OpenARDF/FlexFox80/README.md

# FlexFox80
A very configurable remote-controllable 80m ARDF transmitter. It has no external buttons or switches, and contains its own webserver and is configured using most WiFi-capable devices, such as smartphones, tablets, or laptops.

Flexfox can be configured to function as an 80m "fox" transmitter for any type of Amateur Radio Direction Finding event, such as classic, sprint, or even foxoring.  

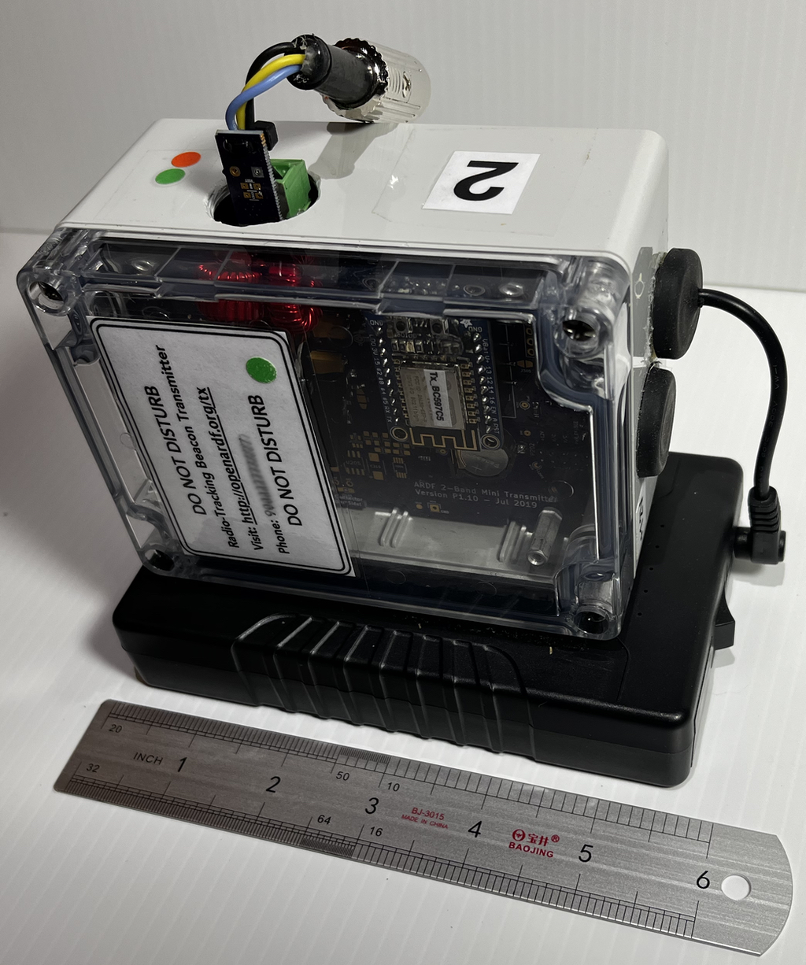
[picture p1: Docs/Proto-Flexfox4.jpeg]

Photo: Prototype FlexFox80 Assembled with 12V 6AH Battery Underneath

<b>KiCad</b>

The KiCad folder holds files for generating the schematic, BOM, and PCB files using KiCad. 

<b>Software</b>

The Software folder holds files for compiling executable code using Atmel Studio 7. 

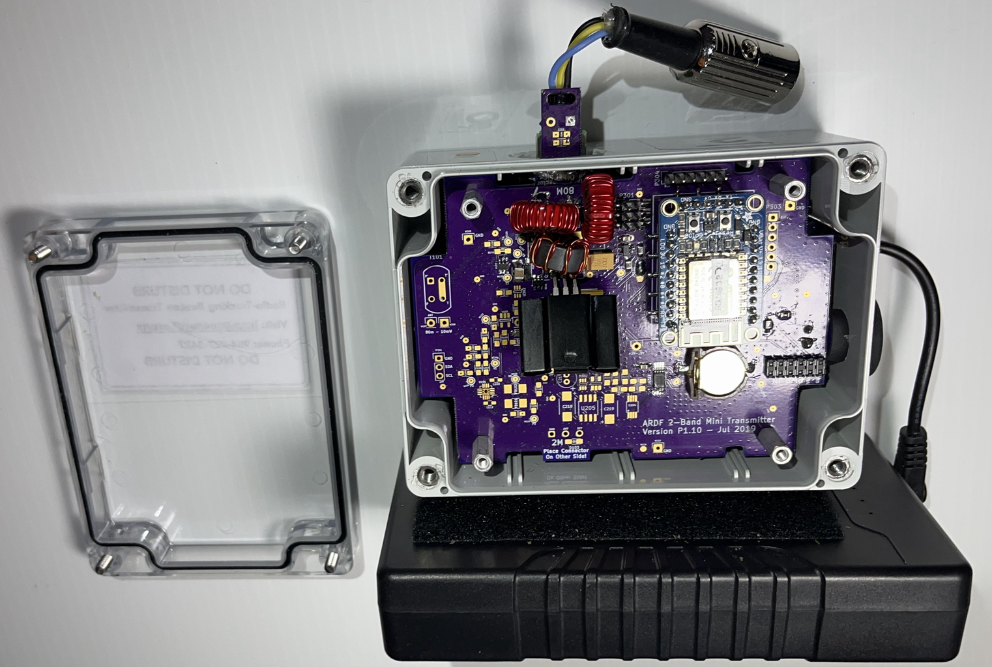
[picture p2: Docs/Proto-Flexfox2.jpeg]

Photo: Prototype FlexFox80 with Transparent Cover Removed
