OpenARDF/FlexFox80/KiCad/Gerber/FlexFox80 BOM Populated.xlsx

FlexFox80
Ref | Value | QTY PER | Footprint | Description | Digi-Key Part No. | LCSC Part No. | Link | Manufacturer | Manufacturer PN | Comments
C123 C131 | 1100pF | 2 | Capacitors_SMD:C_0805 | CAP CER 1100PF 50V NP0 0805 | 399-14552-1-ND | C2327793 | <a href="https://www.digikey.com/products/en?keywords=399-14552-1-ND">Link</a> | KEMET | C0805C112J5GAC7800
C120 C122 C310 C312 | 470nF | 4 | Capacitors_SMD:C_0805 | CAP CER 0.47UF 100V X7R 0805 | 478-9924-1-ND | C342818 | <a href="https://www.digikey.com/products/en?keywords=478-9924-1-ND">Link</a> | AVX Corporation | 08051C474K4Z2A
C126 | 1800pF | 1 | Capacitors_SMD:C_0805 | CAP CER 1800PF 100V C0G 0805 | 445-5752-1-ND | C2173329 | <a href="https://www.digikey.com/products/en?keywords=445-5752-1-ND">Link</a> | TDK Corporation | CGA4F2C0G2A182J085AA
C128 | 91pF | 1 | Capacitors_SMD:C_0603 | CAP CER 91PF 100V NP0 0603 | 478-10247-1-ND | C2170042 | <a href="https://www.digikey.com/products/en?keywords=478-10247-1-ND">Link</a> | KYOCERA AVX | 06031U910FAT2A
C119 C214 C217 | 47uF low ESR | 3 | Capacitors_SMD:C_2917 | CAP TANT 47UF 10% 20V 2917 | 399-3904-1-ND | C122333 | <a href="https://www.digikey.com/products/en?keywords=399-3904-1-ND">Link</a> | KEMET | T495X476K020ATE150
C117 C210 | 22uF | 2 | Capacitors_SMD:C_1210 | CAP CER 22UF 25V X5R 1210 | 1276-3373-1-ND | C337455 | <a href="https://www.digikey.com/products/en?keywords=1276-3373-1-ND">Link</a> | Samsung Electro-Mechanics | CL32A226MAJNNNE
C101 C205 C216 C305 C304 | 10uF | 5 | Capacitors_SMD:C_0805 | CAP CER 10UF 25V X5R 0805 | 490-5523-1-ND | C84416 | <a href="https://www.digikey.com/products/en?keywords=490-5523-1-ND">Link</a> | Murata Electronics | GRM21BR61E106KA73L
C213 C219 C301 | 1uF | 3 | Capacitors_SMD:C_0805 | CAP CER 1UF 16V X7R 0805 | 311-1365-1-ND | C344171 | <a href="https://www.digikey.com/products/en?keywords=311-1365-1-ND">Link</a> | Yageo | CC0805KKX7R7BB105
C207 | 270pF | 1 | Capacitors_SMD:C_0805 | CAP CER 270PF 50V C0G/NP0 0805 | 1276-2624-1-ND | C161109 | <a href="https://www.digikey.com/products/en?keywords=1276-2624-1-ND">Link</a> | Samsung Electro-Mechanics | CL21C271GBANNNC
C208 | 10pF | 1 | Capacitors_SMD:C_0805 | CAP CER 10PF 200V C0G/NP0 0805 | 478-10457-1-ND | C344177 | <a href="https://www.digikey.com/products/en?keywords=478-10457-1-ND">Link<a/> | AVX Corporation | 08052U100FAT2A
C206 C211 C202 C204 C212 C306 C307 C302 C319 C320 C311 C308 | 100nF | 12 | Capacitors_SMD:C_0805 | CAP CER 0.1UF 50V X7R 0805 | 478-1395-1-ND | C360619 | <a href="https://www.digikey.com/products/en?keywords=478-1395-1-ND">Link</a> | AVX Corporation | 08055C104KAT2A
C215 C209 | 150uF low ESR | 2 | Capacitors_SMD:C_2917 | CAP TANT 150UF 10% 20V 2917 | 478-5253-1-ND | C444765 | <a href="https://www.digikey.com/products/en?keywords=478-5253-1-ND">Link</a> | AVX Corporation | TPME157K020R0035
C218 | 10nF | 1 | Capacitors_SMD:C_0805 | CAP CER 10000PF 50V NP0 0805 | 478-10068-1-ND | C527201 | <a href="https://www.digikey.com/products/en?keywords=478-10068-1-ND">Link</a> | AVX Corporation | 08055A103JAT2A
C303 C318 C317 C314 C313 C315 | 4.7uF | 6 | Capacitors_SMD:C_0805 | CAP CER 4.7UF 25V X7R 0805 | 587-2990-1-ND | C162420 | <a href="https://www.digikey.com/products/en?keywords=587-2990-1-ND">Link</a> | Taiyo Yuden | TMK212AB7475KG-T
D104 D306 D307 | ESD | 3 | Resistors_SMD:R_0603 | VARISTOR 0603 | CG0603MLC-05LECT-ND | C2655331 | <a href="https://www.digikey.com/products/en?keywords=CG0603MLC-05LECT-ND">Link</a> | Bourns Inc. | CG0603MLC-05LE
D101 D301 | MBD54 | 2 | TO_SOT_Packages_SMD:SOT-363-0.65 | DIODE ARRAY SCHOTTKY 30V SC88 | MBD54DWT1GOSCT-ND | C152486 | <a href="https://www.digikey.com/products/en?keywords=MBD54DWT1GOSCT-ND">Link</a> | ON Semiconductor | MBD54DWT1G
D102 | 4.7V | 1 | Diodes_SMD:SOD-123_Handsolder | DIODE ZENER 4.7V 500MW SOD123 | BZT52C4V7-13FDICT-ND | C151054 | <a href="https://www.digikey.com/products/en?keywords=BZT52C4V7-13FDICT-ND">Link</a> | Diodes Incorporated | BZT52C4V7-13-F
D202 D201 | B530 | 2 | Diodes_SMD:DO-214AB | DIODE SCHOTTKY 30V 5A SMC | B530C-FDICT-ND | C110488 | <a href="https://www.digikey.com/products/en?keywords=B530C-FDICT-ND">Link</a> | Diodes Incorporated | B530C-13-F
D305 | RED | 1 | Resistors_SMD:R_0805 | LED RED CLEAR 0805 SMD | 732-4984-1-ND | C72037 | <a href="https://www.digikey.com/products/en?keywords=732-4984-1-ND ">Link</a> | Wurth Elektronik | 150080RS75000
D304 | GREEN | 1 | Resistors_SMD:R_0805 | LED GREEN CLEAR 0805 SMD | 732-4983-1-ND | C98224 | <a href="https://www.digikey.com/products/en?keywords=732-4983-1-ND">Link</a> | Wurth Elektronik | 150080GS75000
L202 L203 | 6.8uH | 2 | Inductors:CDR7D28MN | FIXED IND 6.8UH 2.75A 46.3 MOHM | 308-1328-1-ND |  | <a href="https://www.digikey.com/products/en?keywords=308-1328-1-ND">Link</a> | Sumida America Components Inc. | CDR7D28MNNP-6R8NC
Q201 | MUN5213DW1 | 1 | TO_SOT_Packages_SMD:SOT-363-0.65 | TRANS PREBIAS 2NPN 50V SC88 | MUN5213DW1T1GOSCT-ND | C95381 | <a href="https://www.digikey.com/products/en?keywords=MUN5213DW1T1GOSCT-ND">Link</a> | ON Semiconductor | MUN5213DW1T1G
Q202 | DMP4025LSD | 1 | Housings_SOIC:SOIC-8_3.9x4.9mm_Pitch1.27mm | MOSFET 2P-CH 40V 6.9A 8SO | DMP4025LSD-13DICT-ND | C150763 | <a href="https://www.digikey.com/products/en?keywords=DMP4025LSD-13DICT-ND">Link</a> | Diodes Incorporated | DMP4025LSD-13
Q203 | RJK0354DSP | 1 | Housings_SOIC:SOIC-8_3.9x4.9mm_Pitch1.27mm | MOSFET N-CH 30V 16A 8SOP | RJK0354DSP-00#J0CT-ND | C919563 | <a href="https://www.digikey.com/products/en?keywords=RJK0354DSP-00#J0CT-ND">Link</a> | Renesas Electronics America Inc | RJK0354DSP-00#J0
Q301 | PN2222A | 1 | TO_SOT_Packages_SMD:SOT-23 | TRANS NPN 40V 0.6A SOT23 | MMBT2222ATPMSCT-ND | C194252 | <a href="https://www.digikey.com/products/en?keywords=MMBT2222ATPMSCT-ND">Link</a> | Micro Commercial Co | MMBT2222A-TP
R204 | 392k | 1 | Resistors_SMD:R_0805 | RES SMD 392K OHM 1% 1/8W 0805 | 311-392KCRCT-ND | C273847 | <a href="https://www.digikey.com/products/en?keywords=311-392KCRCT-ND">Link</a> | Yageo | RC0805FR-07392KL
R207 R209 R210 R313 R308 | 100k | 5 | Resistors_SMD:R_0805 | RES SMD 100K OHM 1% 1/8W 0805 | 311-100KCRCT-ND | C103905 | <a href="https://www.digikey.com/products/en?keywords=311-100KCRCT-ND">Link</a> | Yageo | RC0805FR-07100KL
R212 R205 R201 | 162k | 3 | Resistors_SMD:R_0805 | RES SMD 162K OHM 1% 1/8W 0805 | 311-162KCRCT-ND | C416820 | <a href="https://www.digikey.com/products/en?keywords=311-162KCRCT-ND">Link</a> | Yageo | RC0805FR-07162KL
R203 R208 R206 | 27k | 3 | Resistors_SMD:R_0805 | RES SMD 27K OHM 1% 1/8W 0805 | 311-27.0KCRCT-ND | C139896 | <a href="https://www.digikey.com/products/en?keywords=311-27.0KCRCT-ND">Link</a> | Yageo | RC0805FR-0727KL
R213 R214 R211 R216 R215 R306 R307 R310 R311 R303 R315 R316 | 10k | 12 | Resistors_SMD:R_0805 | RES SMD 10K OHM 1% 1/8W 0805 | 311-10KLGCT-ND | C38522 | <a href="https://www.digikey.com/products/en?keywords=311-10KLGCT-ND">Link</a> | Yageo | AC0805FR-0710KL
R217 | 1.1k | 1 | Resistors_SMD:R_0805 | RES SMD 1.1K OHM 1% 1/8W 0805 | 311-1.10KCRCT-ND | C352257 | <a href="https://www.digikey.com/products/en?keywords=311-1.10KCRCT-ND">Link</a> | Yageo | RC0805FR-071K1L
R218 | 0.01 0.5W | 1 | Resistors_SMD:R_0805 | RES 0.01 OHM 1% 1/2W 0805 | 408-1544-1-ND | C728271 | <a href="https://www.digikey.com/products/en?keywords=408-1544-1-ND">Link</a> | Susumu | KRL1220E-M-R010-F-T5
R202 | 49.9k | 1 | Resistors_SMD:R_0805 | RES SMD 49.9K OHM 0.1% 1/8W 0805 | YAG4990CT-ND | C218598 | <a href="https://www.digikey.com/products/en?keywords=YAG4990CT-ND">Link</a> | Yageo | RT0805BRE0749K9L
R304 | 10 | 1 | Resistors_SMD:R_0805 | RES SMD 10 OHM 1% 1/8W 0805 | 311-10.0CRCT-ND | C96347 | <a href="https://www.digikey.com/products/en?keywords=311-10.0CRCT-ND">Link</a> | Yageo | RC0805FR-0710RL
R312 R314 | 560k | 2 | Resistors_SMD:R_0805 | RES SMD 560K OHM 1% 1/8W 0805 | 13-RT0805FRE07560KLCT-ND | C352198 | <a href="https://www.digikey.com/products/en?keywords=13-RT0805FRE07560KLCT-ND">Link</a> | Yageo | RT0805FRE07560KL
R309 | 2.2k | 1 | Resistors_SMD:R_0805 | RES SMD 2.2K OHM 1% 1/8W 0805 | 311-2.2KCRCT-ND | C114561 | <a href="https://www.digikey.com/products/en?keywords=311-10.0KCRCT-ND">Link</a> | Yageo | RC0805FR-072K2L
R302 R301 | 470 | 2 | Resistors_SMD:R_0805 | RES 470 OHM 1% 1/4W 0805 | 2019-RK73H2ATTD4700FCT-ND | C114564 | <a href="https://www.digikey.com/products/en?keywords=2019-RK73H2ATTD4700FCT-ND">Link</a> | KOA Speer Electronics Inc. | RK73H2ATTD4700F
RV301 | 10k Pot | 1 | Potentiometers:Potentiometer_ST32ET_Handsolder | TRIMMER 10K OHM 0.1W J LEAD TOP | TC33X-103ECT-ND | C719176 | <a href="https://www.digikey.com/products/en?keywords=TC33X-103ECT-ND">Link</a> | Bourns Inc. | TC33X-2-103E
SW301 | SPST | 1 | Buttons_Switches_SMD:PTS645SL50SMTR92 | SWITCH TACTILE SPST-NO 0.05A 12V | CKN9088CT-ND | C221877 | <a href="https://www.digikey.com/products/en?keywords=CKN9088CT-ND">Link</a> | C&K | PTS645SL50SMTR92 LFS
U107 | LM5134B | 1 | TO_SOT_Packages_SMD:SOT-23-6-LM5134 | IC GATE DRVR LOW-SIDE SOT23-6 | 296-40244-1-ND | C2677086 | <a href="https://www.digikey.com/products/en?keywords=296-40244-1-ND">Link</a> | Texas Instruments | LM5134BMFX/NOPB
U101 | TPS22810DBVT | 1 | TO_SOT_Packages_SMD:SOT-23-6 | Power Switch/Driver 1:1 N-Channel 2A SOT-23-6 | 296-45304-1-ND | C2680364 | <a href="https://www.digikey.com/products/en?keywords=296-45304-1-ND">Link</a> | Texas Instruments | TPS22810DBVT
U203 | LTC3600 | 1 | Housings_SSOP:SSOP-12_Pad | IC REG BUCK PROG 1.5A 12MSOP | LTC3600EMSE#PBF-ND | C580752 | <a href="https://www.digikey.com/products/en?keywords=LTC3600EMSE%23PBF-ND">Link</a> | Analog Devices Inc. | LTC3600EMSE#PBF
U202 | OPA171 | 1 | TO_SOT_Packages_SMD:SOT-23-5_MCP | IC OPAMP GP 1 CIRCUIT SOT23-5 | 296-37698-1-ND | C88036 | <a href="https://www.digikey.com/products/en?keywords=296-37698-1-ND">Link</a> | Texas Instruments | OPA171AIDBVR
U204 | MIC2196 | 1 | Housings_SOIC:SOIC-8_3.9x4.9mm_Pitch1.27mm | IC REG CTRLR BOOST 8SOIC | MIC2196YM-CT-ND | C627808 | <a href="https://www.digikey.com/products/en?keywords=MIC2196YM-CT-ND">Link</a> | Microchip Technology | MIC2196YM-TR
U304 | SI5351A | 1 | Housings_SSOP:MSOP-10_3x3mm_Pitch0.5mm | IC CLK GENERATOR 200MHZ 10MSOP | 336-2399-5-ND | C529366 | <a href="https://www.digikey.com/products/en?keywords=336-2399-5-ND">Link</a> | Silicon Labs | SI5351A-B-GT
U301 | DS3231 | 1 | SMD_Packages:SO16 | IC RTC CLK/CALENDAR I2C 16-SOIC | DS3231S#T&RCT-ND | C2651514 | <a href="https://www.digikey.com/products/en?keywords=DS3231S%23T%26RCT-ND">Link</a> | Maxim Integrated | DS3231S#T&R
U305 | 74HC1G08 | 1 | TO_SOT_Packages_SMD:SOT-23-5 | IC GATE AND 1CH 2-INP 5TSOP | MC74HC1G08DTT1GOSCT-ND | C108694 | <a href="https://www.digikey.com/products/en?keywords=MC74HC1G08DTT1GOSCT-ND">Link</a> | ON Semiconductor | MC74HC1G08DTT1G
U303 U308 | LD2985BM33R | 2 | TO_SOT_Packages_SMD:SOT-23-5 | IC REG LINEAR 3.3V 150MA SOT23-5 | 497-3499-1-ND | C222396 | <a href="https://www.digikey.com/products/en?keywords=497-3499-1-ND">Link</a> | STMicroelectronics | LD2985BM33R
U302 | AVR128DA48 | 1 | Housings_QFP:TQFP-48_7x7mm_Pitch0.5mm_AVR128DA48 | IC MCU 8BIT 128KB FLASH 48TQFP | 150-AVR128DA48T-E/PTCT-ND | C1870720 | <a href="https://www.digikey.com/products/en?keywords=150-AVR128DA48T-E/PTCT-ND">Link</a> | Microchip Technology | AVR128DA48T-E/PT
U306 | LT1763CS8-5 | 1 | Housings_SOIC:SOIC-8_3.9x4.9mm_Pitch1.27mm | IC REG LINEAR 5V 500MA 8SOIC | LT1763CS8-5#TRPBFCT-ND | C193629 | <a href="https://www.digikey.com/products/en?keywords=LT1763CS8-5#TRPBFCT-ND">Link</a> | Analog Devices Inc. | LT1763CS8-5#TRPBF
U307 | TPS22810DBVT | 1 | TO_SOT_Packages_SMD:SOT-23-6 | IC PWR SWITCH N-CHAN 1:1 SOT23-6 | 296-45304-1-ND | C2680364 | <a href="https://www.digikey.com/products/en?keywords=296-45304-1-ND">Link</a> | Texas Instruments | TPS22810DBVT
X301 | 25.MHZ TCXO | 1 | Crystals:ASTX-H11-25.000MHZ | XTAL OSC TCXO 25MHZ CLPSNW | 2780-I537-2O7-25.000MHZCT-ND |  | <a href="https://www.digikey.com/products/en?keywords=2780-I537-2O7-25.000MHZCT-ND">Link</a> | Abracon LLC | I537-2O7-25.000 MHZ
