OpenARDF/FlexFox80/KiCad/FlexFox80.kicad_pcb

## KiCad design KiCad/FlexFox80.kicad_pcb (2026-07-14)

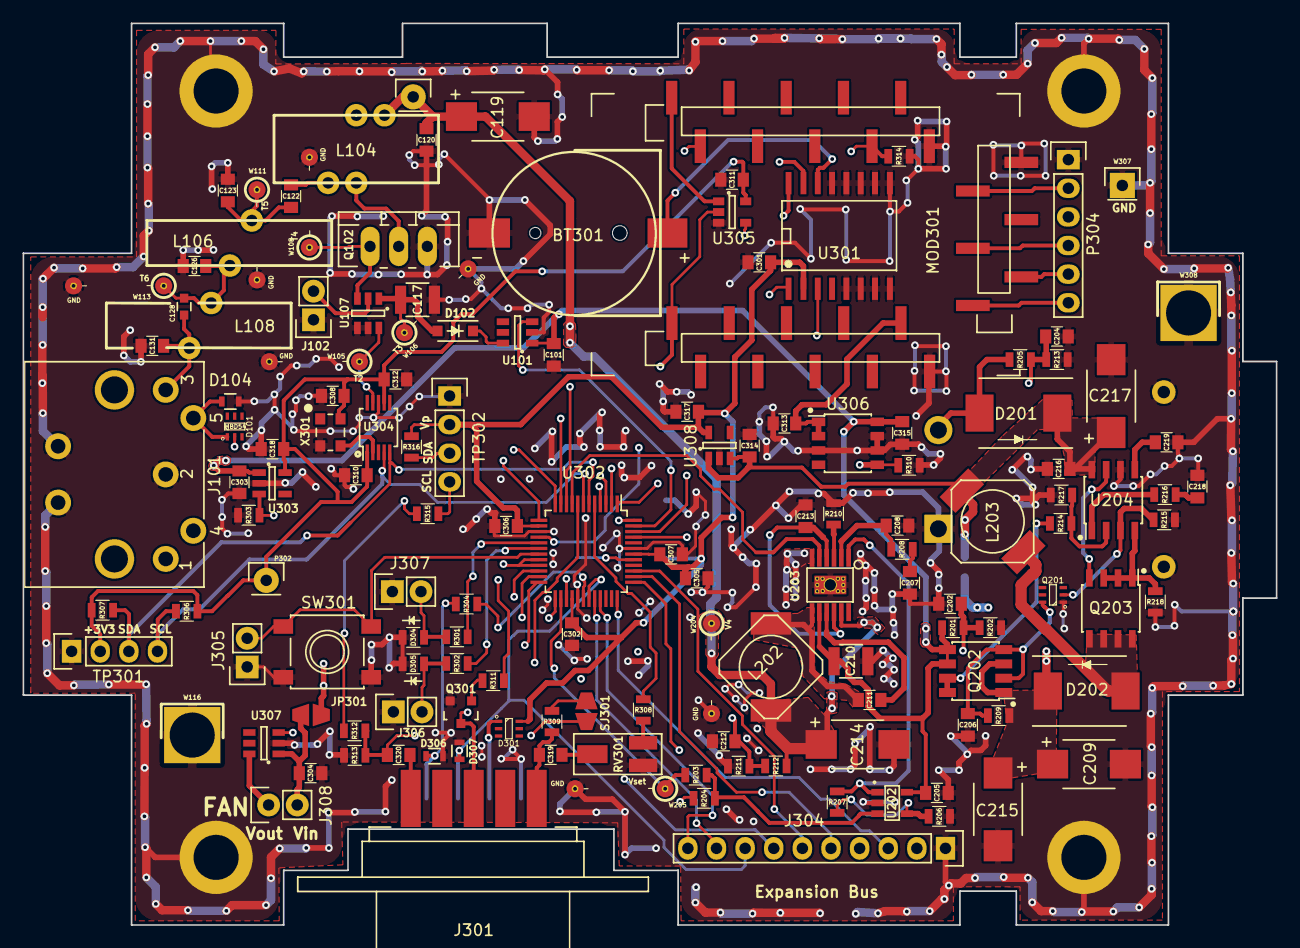
[picture p3: board FlexFox80.kicad_pcb from above]

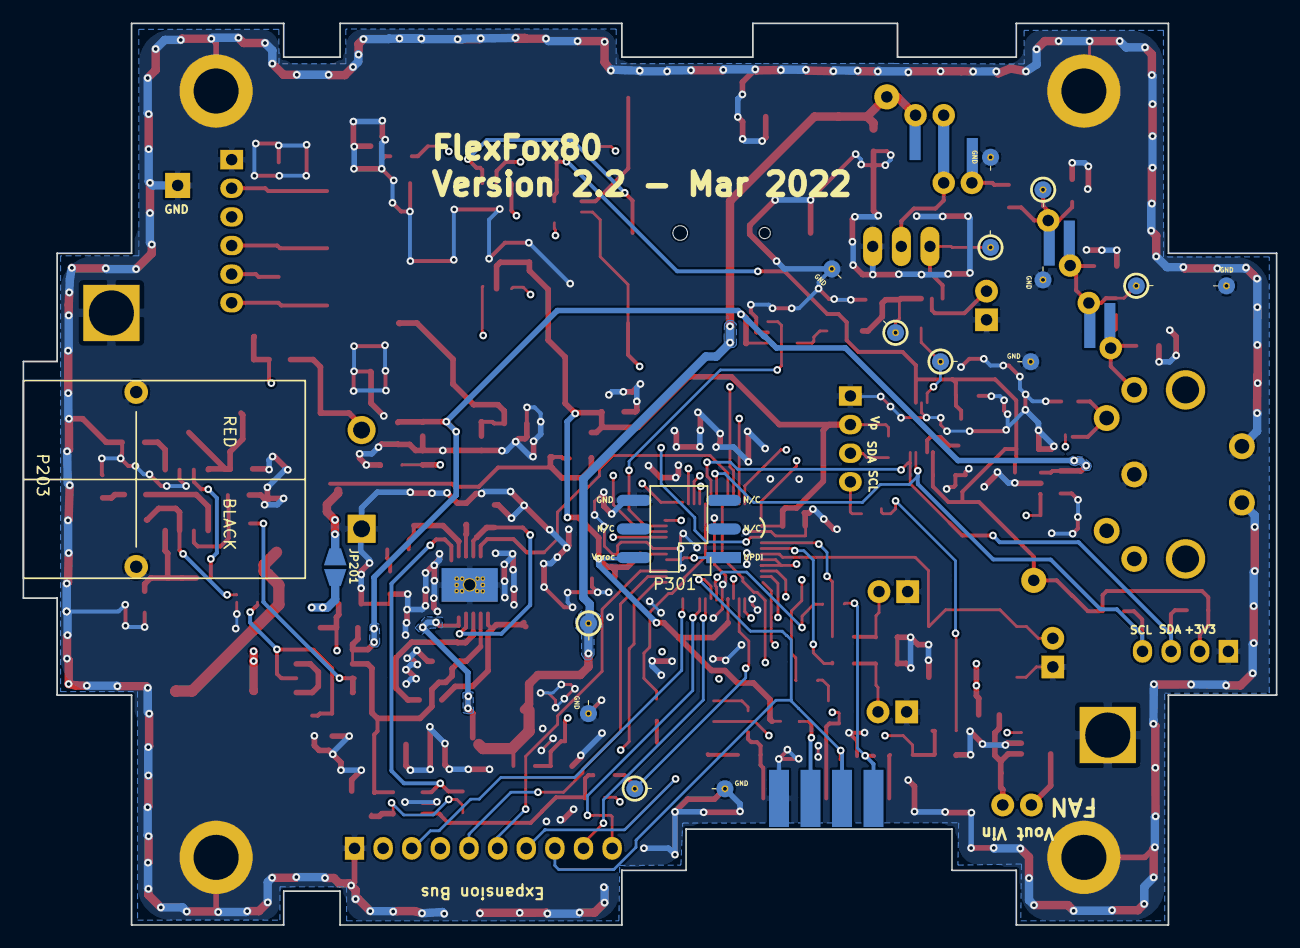
[picture p4: board FlexFox80.kicad_pcb from below]

Board: 4 copper layers, 111.2 x 80.0 mm, 143 parts (3 on the bottom side), 94 nets.

Parts:
BT301: CR1220; BC501SM_CR1220_BAT_Handsolder
C101, C205, C216, C304, C305: 10uF; C_0805
C117, C210: 22uF; C_1210
C119, C214, C217: 47uF low ESR; C_2917
C120, C122, C310, C312: 470nF; C_0805
C123, C131: 1100pF; C_0805
C126: 1800pF; C_0805
C128: 91pF; C_0603
C202, C204, C206, C211, C212, C302, C306, C307, C308, C311, C319, C320: 100nF; C_0805
C207: 270pF; C_0805
C208: 10pF; C_0805
C209, C215: 150uF low ESR; C_2917
C213, C219, C301: 1uF; C_0805
C218: 10nF; C_0805
C303, C313, C314, C315, C317, C318: 4.7uF; C_0805
D101, D301: MBD54; SOT-363-0.65_MBD54
D102: 4.7V; SOD-123
D104, D306, D307: ESD; R_0603
D201, D202: B530; DO-214AB
D304: GREEN; D_0805
D305: RED; D_0805
J101: DIN-5_180degree; SDF-50J
J102, J305, J306, J307, J308: Conn_01x02; Pin_Header_Straight_1x02
J203: V4; Pin_Header_Straight_1x01_circle_pad
J301: DB9_Female; DB9F_CI
J304: Conn_01x10; Pin_Header_Straight_1x10
JP201: Boost Bypass; Solder-Jumper-NO-SMD-Pad_Small
JP301: Jumper_NO_Small; Solder-Jumper-NO-SMD-Pad_Small
L104: 9T #24 Bifilar T50-43; Toroid_T-50A_TH_BF_CT_Vertical
L106, L108: 2.7uH; Toroid_T-60_2TH_Vertical
L202, L203: 6.8uH; CDR7D28MN
MOD301: HUZZAH_ESP8266_Breakout; Adafruit_HUZZAH_ESP8266_Breakout_SM
P203: Power Pole; PowerPole-ASMPP30-1x2
P301: ISP/PDI; SM_Pin_Header_Straight_2x03
P302: Thru; Pin_Header_Straight_1x01
P304: Header; Pin_Header_Straight_1x06
Q102: IRF610; TO-220_Neutral123_Vertical_LargePads
Q201: MUN5213DW1; SOT-363-0.65
Q202: DMP4025LSD; SOIC-8_3.9x4.9mm_Pitch1.27mm
Q203: RJK0354DSP; SOIC-8_3.9x4.9mm_Pitch1.27mm
Q301: PN2222A; SOT-23
R201, R205, R212: 162k; R_0805
R202: 49.9k; R_0805
R203, R206, R208: 27k; R_0805
R204: 392k; R_0805
R207, R209, R210, R308, R313: 100k; R_0805
R211, R213, R214, R215, R216, R303, R306, R307, R310, R311, R315, R316: 10k; R_0805
R217: 1.1k; R_0805
R218: 0.01 0.5W; R_0805
R301, R302: 470; R_0805
R304: 10; R_0805
R309: 2.2k; R_0805
R312, R314: 560k; R_0805
RV301: 10k Pot; Potentiometer_ST32ET_Handsolder
SJ301: SolderJumper_2_Open; Solder-Jumper-NO-SMD-Pad_Small
SW301: SPST; PTS645SL50SMTR92
TP301: I2C1; Pin_Header_Straight_1x04
TP302: I2C0; Pin_Header_Straight_1x04
U101, U307: TPS22810DBVT; SOT-23-6
U107: LM5134B; SOT-23-6-LM5134
U202: OPA171; SOT-23-5_MCP
U203: LTC3600; SSOP-12_Pad_Handsolder
U204: MIC2196; SOIC-8_3.9x4.9mm_Pitch1.27mm
U301: DS3231; SO16
U302: AVR128DA48; TQFP-48_7x7mm_Pitch0.5mm_AVR128DA48
U303, U308: LD2985BM33R; SOT-23-5
U304: SI5351A; MSOP-10_3x3mm_Pitch0.5mm
U305: 74HC1G08; SOT-23-5
U306: LT1763CS8-5; SOIC-8_3.9x4.9mm_Pitch1.27mm
W105: T2; Measurement_Point_ScopeProbe_Round-SMD-2sides-Pad_Small
W106: T3; Measurement_Point_ScopeProbe_Round-SMD-2sides-Pad_Small
W108: T4; Measurement_Point_ScopeProbe_Round-SMD-2sides-Pad_Small
W111: T5; Measurement_Point_ScopeProbe_Round-SMD-2sides-Pad_Small
W113: T6; Measurement_Point_ScopeProbe_Round-SMD-2sides-Pad_Small
W116: GND; Pin_Header_Straight_1x01
W204: V4; Measurement_Point_ScopeProbe_Round-SMD-2sides-Pad_Small
W205: Vset; Measurement_Point_ScopeProbe_Round-SMD-2sides-Pad_Small
W307, W308: CONN_01X01; Pin_Header_Straight_1x01
X301: 25.MHZ TCXO; TXETCLSANF-25.000MHZ

Connections:
3V3_PWR_ENABLE: R303.2, U302.3, U303.3
32KHZ_SQUAREWAVE: U301.1, U302.16
80M_ANTENNA_DETECT: D101.1, D104.1, J101.5, U302.20, U302.21
+2to+12V: C119.1, C120.1, C214.1, J203.1, L104.1, L202.2, R212.1, U203.11, W204.1
+3V3_L8: C308.1, C310.1, C311.2, C312.1, C318.2, J304.2, P302.1, R204.1, R306.1, R307.1, TP301.2, U303.5, U304.1, U304.7, U305.5, X301.4
+12V: C101.2, C205.2, C210.1, C303.2, C315.2, JP301.2, Q202.5, Q202.6, R201.2, U101.1, U202.5, U203.8, U303.1, U306.8
/Digital/ADC7: MOD301.13, R314.1, U302.27
/Digital/PC5: R301.2, U302.17
/Digital/PC6: R302.2, U302.18
/Digital/PC7: J305.2, SW301.1, U302.19
/Digital/PE2: J304.9, U302.32
/Digital/PE3: J304.10, U302.33
/Digital/PF2: J304.3, U302.36
/Digital/PF3: J304.4, U302.37
/Digital/PF4: J304.5, U302.38
/Digital/PF5: J304.6, U302.39
/Digital/SCL1: R306.2, TP301.4, U302.7, U304.4
/Digital/SDA1: R307.2, TP301.3, U302.6, U304.5
/Digital/TXD4: J304.7, R304.1, U302.30
CLK1: U107.6, U304.9, W105.1
DAC_OUTPUT: R203.2, U302.26, W205.1
EXTERNAL_3.6V-15V_SUPPLY: C216.2, C217.1, C314.2, D201.1, JP201.2, L203.2, U204.8, U308.1, U308.3
FAN_ENABLE: U302.45, U307.3
FET_DRIVER_ENABLE: U101.3, U302.47
GND: BT301.2, C101.1, C117.2, C119.2, C120.2, C123.2, C126.1, C131.2, C202.2, C204.1, C205.1, C206.2, C207.2, C208.2, C209.2, C210.2, C212.1, C213.2, C214.2, C215.2, C216.1, C217.2, C218.2, C219.2, C301.2, C302.1, C303.1, C304.2, C305.1, C306.1, C307.1, C308.2, C310.2, C311.1, C312.2, C313.1, C314.1, C315.1, C317.1, C318.1, D104.2, D304.1, D305.1, D306.2, D307.2, J101.2, J101.E, J102.1, J301.6, J304.1, J305.1, J306.1, J307.1, MOD301.10, MOD301.11, MOD301.21, P203.1, P203.E, P301.6, P304.1, Q102.3, Q201.1, Q301.2, R202.2, R206.2, R210.2, R211.2, R213.2, R215.1, R217.1, R218.1, R303.1, R310.2, R313.2, R314.2, RV301.3, SW301.2, TP301.1, TP302.1, U101.2, U107.4, U107.5, U202.2, U203.6, U203.13, U204.6, U301.5, U301.6, U301.7, U301.8, U301.9, U301.10, U301.11, U301.12, U301.13, U302.15, U302.29, U302.43, U303.2, U304.8, U305.3, U306.3, U306.6, U306.7, U307.2, U308.2, W105.2, W106.2, W108.2, W111.2, W113.2, W116.1, W204.2, W205.2, W307.1, W308.1, X301.2
MAIN_PWR_ENABLE: Q201.2, R215.2, U204.3, U302.8
unnamed: BT301.1, U301.14
unnamed: C117.1, D102.2, U107.1, W106.1
unnamed: C122.1, L104.3
unnamed: C122.2, C123.1, L106.1, W111.1
unnamed: C126.2, C128.2, L106.2, L108.1, W113.1
unnamed: C128.1, C131.1, J101.3, L108.2
unnamed: C206.1, Q201.6, Q202.2, Q202.4, R209.1
unnamed: C207.1, R208.2
unnamed: C208.1, R208.1, U203.2
unnamed: C209.1, C215.1, D202.1, JP201.1, Q202.1, Q202.3, R209.2
unnamed: C211.1, L202.1, U203.7
unnamed: C211.2, U203.9
unnamed: C213.1, U203.4, U203.10
unnamed: C218.1, R216.1
unnamed: C219.1, U204.5
unnamed: C304.1, J308.2, JP301.1, U307.1
unnamed: C313.2, MOD301.9, U306.1, U306.2
unnamed: C319.1, RV301.2
unnamed: C319.2, J301.1, R309.2
unnamed: C320.2, J301.5
unnamed: D102.1, U101.6
unnamed: D201.2, P203.2, R205.1
unnamed: D202.2, L203.1, Q203.5, Q203.6, Q203.7, Q203.8
unnamed: D301.1, J301.7
unnamed: D304.2, J307.2, R301.1
unnamed: D305.2, J306.2, R302.1
unnamed: J102.2, U107.2
unnamed: J301.3, Q301.3, SJ301.2
unnamed: J308.1, U307.6
unnamed: L104.2, Q102.2
unnamed: MOD301.20, U305.1
unnamed: MOD301.22, P304.2
unnamed: MOD301.24, P304.4
unnamed: MOD301.25, P304.5
unnamed: MOD301.26, P304.6
unnamed: P301.1, U302.41
unnamed: Q102.1, U107.3, W108.1
unnamed: Q202.7, Q202.8, R214.2
unnamed: Q203.1, Q203.2, Q203.3, R218.2, U204.4
unnamed: Q203.4, U204.7
unnamed: Q301.1, R311.1
unnamed: R203.1, R204.2, U202.3
unnamed: R206.1, R207.2, U202.4
unnamed: R207.1, U202.1, U203.1
unnamed: R210.1, U203.3
unnamed: R214.1, R217.2, U204.2
unnamed: R216.2, U204.1
unnamed: R308.2, RV301.1
unnamed: R309.1, SJ301.1
unnamed: U304.2, X301.3
PROC_HT_AUDIO_IN: C320.1, R312.2, R313.1, U302.22
PROC_PTT_OUT: R311.2, U302.4
PROC_TONE_OUT: R308.1, U302.5
RTC_SCL: R315.2, TP302.4, U301.16, U302.13
RTC_SDA: R316.2, TP302.3, U301.15, U302.12
RTC_SQW: U301.3, U302.46
RXD_TO_FTDI: D307.1, J301.8, J304.8, U302.31
TXD_TO_FTDI: D306.1, J301.9, R304.2
TX_+12_VOLTAGE: C202.1, R201.1, R202.1, U302.24
TX_BATTERY_VOLTAGE: C204.2, R205.2, R213.1, U302.23
TX_FINAL_VOLTAGE_ENABLE: U203.5, U302.9
TX_PA_VOLTAGE: C212.2, R211.1, R212.2, U302.25
Vproc: C301.1, C302.2, C305.2, C306.2, C307.2, C317.2, D301.6, P301.2, R312.1, R315.1, R316.1, TP302.2, U301.2, U302.14, U302.28, U302.42, U308.5
WIFI_ENABLE: R310.1, U302.1, U306.5
WIFI_RX: MOD301.19, U302.10
WIFI_TX: U302.11, U305.4
~ANT_CONNECT_INT: D101.2, U302.48
~WIFI_RESET: MOD301.1, U302.2, U305.2
