OpenARDF/FlexFox80/Software/Huzzah/ARDF_Transmitter/ARDF_Transmitter.ino

/*
 *  MIT License
 *
 *  Copyright (c) 2022-2026 Digital Confections LLC
 *
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
 *  THE SOFTWARE IS PROVIDED "AS IS", WITHOUT WARRANTY OF ANY KIND, EXPRESS OR
 *  IMPLIED, INCLUDING BUT NOT LIMITED TO THE WARRANTIES OF MERCHANTABILITY,
 *  FITNESS FOR A PARTICULAR PURPOSE AND NONINFRINGEMENT. IN NO EVENT SHALL THE
 *  AUTHORS OR COPYRIGHT HOLDERS BE LIABLE FOR ANY CLAIM, DAMAGES OR OTHER
 *  LIABILITY, WHETHER IN AN ACTION OF CONTRACT, TORT OR OTHERWISE, ARISING FROM,
 *  OUT OF OR IN CONNECTION WITH THE SOFTWARE OR THE USE OR OTHER DEALINGS IN THE
 *  SOFTWARE.
 */

/*
 * Top-level ESP8266 WiFi, HTTP, WebSocket, and AVR bridge orchestration.
 *
 * Hardware target: Adafruit HUZZAH ESP8266 at 80 MHz.
 *
 * This sketch:
 *
 * - exchanges framed Linkbus commands and telemetry with the FlexFox AVR;
 * - hosts the FlexFox access point, HTTP configuration UI, and WebSocket API;
 * - stores and validates event definitions in LittleFS;
 * - coordinates master/target wireless cloning, including quiet mode, RTC-edge
 *   synchronization, checksum validation, and cleanup; and
 * - can obtain network time and pass it to the AVR when explicitly requested.
 */

#include <Arduino.h>
/*#include <GDBStub.h> */
#include <ESP8266WiFi.h>
#include <WiFiUdp.h>
#include <WiFiClient.h>
#include <ESP8266WebServer.h>
#include <ESP8266WiFiMulti.h>
#include <Updater.h>
#include <StreamString.h>
/*#include <ESP8266mDNS.h> */
#include <user_interface.h>
#include "esp8266.h"
/*#include <ArduinoOTA.h> */
#include <LittleFS.h> // LittleFS is declared
#include <Hash.h>
#include <WebSocketsServer.h>
#include <WebSocketsClient.h>
#include <ESP8266WiFiType.h>
#include <time.h>
#include "Transmitter.h"
#include "RootPage.h"
#include "FirmwareUpdatePage.h"
#include "AvrFirmwareUpdate.h"
#include "AvrFirmwareUpdatePage.h"
#include "FleetSoak.h"
#include "Event.h"
#include "clone_event_manifest.h"
#include "clone_diagnostic_state.h"
#include "clone_keepalive_schedule.h"
#include "clone_reset_marker.h"
#include "clone_sync_safety.h"
#include "fleet_soak.h"
#include "firmware_update_integrity.h"
#include "filesystem_startup_policy.h"
#include "linkbus_command_transaction.h"
#include "temperature_contract.h"
/* #include <Wire.h> */
#include "Helpers.h"
#include "CircularStringBuff.h"
#include "Blinkies.h"

/* Global variables are always prefixed with g_ */

#if TRANSMITTER_COMPILE_DEBUG_PRINTS
bool g_debug_prints_enabled = DEBUG_PRINTS_ENABLE_DEFAULT;
#endif // TRANSMITTER_COMPILE_DEBUG_PRINTS

bool g_LEDs_enabled = LEDS_ENABLE_DEFAULT;
bool g_baud_sync_success = false;

/*
    TCP to UART Bridge
*/

#define MAX_SRV_CLIENTS 3   /*how many clients should be able to telnet to this ESP8266 */
/*WiFiServer g_tcpServer(BRIDGE_TCP_PORT_DEFAULT.toInt());
  WiFiClient g_tcpServerClients[MAX_SRV_CLIENTS]; */

// String g_bridgeIPaddr = BRIDGE_IP_ADDR_DEFAULT;
///String g_bridgeSSID = BRIDGE_SSID_DEFAULT;
String g_bridgePW = BRIDGE_PW_DEFAULT;  /* minimum 8 characters */
// String g_bridgeTCPport = BRIDGE_TCP_PORT_DEFAULT;


/* Access Point */
String g_masterSSID = MASTER_SSID;
String g_masterSSID_PWD = BRIDGE_PW_DEFAULT;
bool g_IamMaster = MASTER_ENABLE_DEFAULT;

/* Time Retrieval */
/*
    NIST Time Sync
    See https://www.arduino.cc/en/Tutorial/UdpNTPClient
    See http://tf.nist.gov/tf-cgi/servers.cgi
*/
// String g_timeHost = TIME_HOST_DEFAULT;
// String g_timeHTTPport = TIME_HTTP_PORT_DEFAULT;

/* UDP time query */
#define NTP_PACKET_SIZE 48                                  /* NTP time stamp is in the first 48 bytes of the message */
WiFiUDP g_UDP;                                              /* A UDP instance to let us send and receive packets over UDP */
unsigned int g_localPort = 2390;                            /* local port to listen for UDP  packets */

/* HTTP web server */
ESP8266WebServer g_http_server(80);                         /* HTTP server on port 80 */
WebSocketsServer g_webSocketServer = WebSocketsServer(81);  /* create a websocket server on port 81 */
String g_AP_NameString;
String g_uniqueAPNameString;
WebSocketsClient g_webSocketLocalClient;
bool g_webSocketServerStarted = false;

typedef struct webSocketClient
{
  int8_t webID;
  int8_t socketID;
  String macAddr;
} WebSocketClient;

WebSocketClient g_webSocketClient[MAX_NUMBER_OF_WEB_CLIENTS];   /* Keep track of active clients and their MAC addresses */
uint8_t g_numberOfSocketClients = 0;
uint8_t g_numberOfWebClients = 0;
uint8_t g_socket_timeout = 0;

ESP8266WiFiMulti wifiMulti; /* Create an instance of the ESP8266WiFiMulti class, called 'wifiMulti' */
File fsUploadFile;          /* a File variable to temporarily store the received file */
String g_fsUploadTargetPath;
String g_fsUploadStagingPath;
String g_fsUploadBackupPath;
String g_fsUploadError;
size_t g_fsUploadExpectedSize = 0;
size_t g_fsUploadReceivedSize = 0;
uint32_t g_fsUploadExpectedCrc32 = 0;
uint32_t g_fsUploadRunningCrc32 = 0xffffffffUL;
bool g_fsUploadIntegrityRequired = false;
bool g_fsUploadSucceeded = false;
bool g_littleFsMounted = false;
bool g_littleFsRecoveryMode = false;
const char *g_littleFsRecoveryReason = "none";

static const char FILESYSTEM_RECOVERY_PAGE_HTML[] PROGMEM =
  "<!doctype html><html><head><meta name='viewport' content='width=device-width,initial-scale=1'>"
  "<title>FlexFox filesystem recovery</title></head><body>"
  "<h1>Filesystem recovery mode</h1>"
  "<p>LittleFS was not mounted. No filesystem was formatted or modified.</p>"
  "<p>Configuration, event, and AVR-update operations are disabled, but the ESP sketch updater remains available.</p>"
  "<p><a href='/firmware'>Open ESP firmware updater</a></p>"
  "<p><a href='/firmware/status'>View recovery status</a></p>"
  "</body></html>";

String g_softAP_IP_addr;

void handleRoot();          /* function prototypes for HTTP handlers */
void handleNotFound();
void stopWebSocketServer();

/*
    Main Program Support
*/

//unsigned long g_lastAccessToNISTServers = 0;
//bool g_timeWasSet = false;
bool g_justPoweredUp = true;

WebSocketSlaveState g_webSocketSlaveState = WSClientConnecting;
bool g_master_has_connected_slave = false;
bool g_slave_released = true;
bool g_slave_received_new_event_file = false;
int g_slave_socket_number = -1;
int g_files_sent_to_slave = 0;
bool g_onlyUpdateEvent = false;
bool g_slaveCloneQuietActive = false;
bool g_slaveSyncReadySent = false;
unsigned long g_slaveSyncReadyStartedMillis = 0;
unsigned long g_cloneClockExpected = 0;
unsigned long g_cloneClockReadback = 0;
int32_t g_cloneClockReadbackDelta = 0;
unsigned long g_cloneClockWaitStartedMillis = 0;
bool g_cloneClockVerified = false;
bool g_cloneClockReadbackMismatch = false;
bool g_masterCloneQuietPending = false;
bool g_masterCloneQuietActive = false;
bool g_masterClonePruneTargetEvents = false;
bool g_slaveClonePruneTargetEvents = false;
CloneEventManifest g_cloneEventManifest;
CloneKeepAliveSchedule g_slaveCloneKeepAliveSchedule = {0, false, false};
CloneDiagnosticState g_cloneDiagnostic;
String g_cloneDiagnosticFailure;
bool g_cloneDiagnosticCanReportToMaster = false;
uint32_t g_cloneDiagnosticFreeHeap = 0;
uint32_t g_cloneDiagnosticMinimumFreeHeap = 0;
uint16_t g_cloneDiagnosticMaxFreeBlock = 0;
uint8_t g_cloneDiagnosticHeapFragmentation = 0;
String g_masterLastTargetDiagnostic;
unsigned long g_masterLastTargetDiagnosticMillis = 0;
unsigned long g_masterCloneSessionStartedMillis = 0;
unsigned long g_masterCloneLastProgressMillis = 0;
uint16_t g_masterCloneRecoveryCount = 0;
String g_masterCloneLastFailure;
bool g_cloneRecoveredResetDetected = false;
CloneDiagnosticPhase g_cloneRecoveredResetPhase = CLONE_DIAG_IDLE;
uint16_t g_cloneRecoveredResetFileIndex = 0;
uint16_t g_cloneRecoveredResetFileCount = 0;
String g_cloneRecoveredResetReason;
FleetSoakMode g_masterFleetSoakMode = FLEET_SOAK_MODE_OFF;
FleetSoakMode g_slaveFleetSoakMode = FLEET_SOAK_MODE_OFF;
String g_slaveFleetSoakAssignment;
bool g_slaveFleetSoakCapabilitySeen = false;
bool g_slaveFleetSoakSessionReady = false;
int g_fleetSoakCandidateSocket = -1;
String g_fleetSoakCandidateSsid;
String g_fleetSoakCandidateAssignment;

bool g_firmwareUpdateActive = false;
bool g_firmwareUpdateSucceeded = false;
bool g_firmwareRestartPending = false;
size_t g_firmwareUpdateExpectedSize = 0;
size_t g_firmwareUpdateReceivedSize = 0;
uint32_t g_firmwareUpdateExpectedCrc32 = 0;
uint32_t g_firmwareUpdateRunningCrc32 = 0xffffffffUL;
unsigned long g_firmwareUpdateLastKeepAliveMillis = 0;
unsigned long g_firmwareRestartAtMillis = 0;
String g_firmwareUpdateError;

File g_avrUpdateUploadFile;
bool g_avrUpdateUploadActive = false;
bool g_avrUpdateUploadSucceeded = false;
size_t g_avrUpdateExpectedSize = 0;
size_t g_avrUpdateReceivedSize = 0;
uint32_t g_avrUpdateExpectedCrc32 = 0;
uint32_t g_avrUpdateRunningCrc32 = 0xffffffffUL;
String g_avrUpdateTargetVersion;
String g_avrUpdateError;
uint32_t g_avrUpdateCompletionIndicationUntil = 0;
bool g_avrBootloaderAvailable = false;
String g_avrBootloaderIdentity;
int16_t g_avrQualificationResetPage = -1;
bool g_avrQualificationResetReady = false;
bool g_avrQualificationResetContinue = false;

static_assert(
  CLONE_EVENT_MANIFEST_CAPACITY == MAXIMUM_NUMBER_OF_EVENTS,
  "Clone manifest must hold every supported event file");

#define NO_ACTIVITY_TIMEOUT (60 * 5)
int g_noActivityTimeoutSeconds = NO_ACTIVITY_TIMEOUT;

unsigned long g_timeOfDayFromTx = 0;

static WiFiEventHandler e1, e2;

Transmitter *g_xmtr = NULL;
Event* g_activeEvent = NULL;
String g_selectedEventName = String("");
String g_atmega_sw_version = String("");
int g_activeEventIndex = 0;
EventFileRef g_eventList[MAXIMUM_NUMBER_OF_EVENTS];
int g_numberOfEventFilesFound = 0;
int g_numberOfEventFilesSeen = 0;
bool g_eventListCapacityExceeded = false;
int g_numberOfScheduledEvents = 0;
bool g_sendEventSheet = true;
TxCommState g_ESP_Comm_State = TX_WAKE_UP;
TxCommState g_Hold_Comm_State = TX_INVALID_STATE;

CircularStringBuff *g_LBOutputBuff = NULL;
CircularStringBuff *g_fileDataBuff = NULL;
int g_linkBusAckPending = 0;
int g_linkBusNacksReceived = 0;
bool g_linkBusAckTimoutOccurred = false;
bool g_linkBusEventTransactionActive = false;
int g_linkBusCurrentAttemptCount = 0;
int g_linkBusLastAttempts = 0;
unsigned long g_linkBusLastValidFrameMillis = 0;
String g_linkBusLastPhase = String("idle");
String g_linkBusLastFailure = String("");

Blinkies *lights;

void httpWebServerLoop(int blinkRate);
bool populateEventFileList(void);
bool updateEventFileRefFromEvent(String path, Event * event, EventFileRef * fileRef);
bool readEventSummary(String path, Event * event, EventFileRef * fileRef);
void broadcastEventSummary(const EventFileRef& fileRef);
bool readDefaultsFile(void);
void saveDefaultsFile(void);
#if TRANSMITTER_COMPILE_DEBUG_PRINTS
void showSettings(void);
#endif // TRANSMITTER_COMPILE_DEBUG_PRINTS
void handleFileUpload(void);
void handleFileUploadResult(void);
void recoverInterruptedFileUploads(void);
bool startLittleFS(void);
bool filesystemStartupMayProceed(void);
void filesystemStartupComplete(void);
void handleFirmwareUpdatePage(void);
void handleFirmwareUpdateStatus(void);
void handleFirmwareUpdateResult(void);
void handleFirmwareUpdateUpload(void);
void serviceFirmwareUpdateRestart(void);
void handleAvrUpdatePage(void);
void handleAvrUpdateStatus(void);
void handleAvrUpdateJournal(void);
void handleAvrQualificationStatus(void);
void handleAvrQualificationContinue(void);
void handleAvrUpdateResult(void);
void handleAvrUpdateUpload(void);
void handleFleetSoakStatus(void);
void handleFleetSoakActivate(void);
void handleFleetSoakCleanup(void);
void handleAvrUpdateStart(void);
void handleFileDownload(void);
void fileDelete(void);
void fileDeleteWithMessage(String msg);
void handleFileDelete(void);
void handleLBMessage(String message);
void handleFS(void);
bool linkbusLoop(void);
bool clientConnectLoop();
bool clientUpdateEventFilesLoop();
bool waitForTimeLoop();
bool sendEventToATMEGA(String * errorTxt);
bool loadActiveEventFile(String updatedFileName);
int numberOfEventsScheduled(unsigned long epoch);
void shutdownSlave(void);
bool setAVRCloneQuietMode(bool quiet);
void beginSlaveCloneKeepAlive(void);
void serviceSlaveCloneKeepAlive(void);
void endSlaveCloneKeepAlive(void);
void reportCloneDiagnosticPhase(CloneDiagnosticPhase phase);
void reportCloneDiagnosticFailure(const String& reason);
void reportCloneDiagnosticComplete(void);
String cloneDiagnosticFailureText(const String& fallback);
void captureCloneHeapDiagnostic(void);
void cleanupIncompleteCloneTempFile(File& tempFile);
void persistCloneResetMarker(void);
void loadCloneResetEvidence(void);
void initializeUniqueAPName(void);
void serviceMasterCloneHandshake(void);
void serviceMasterCloneWatchdog(void);
void endMasterCloneSession(void);
bool reconcileCloneEventFiles(const CloneEventManifest *manifest);
static bool drainLinkbusBeforeEvent(String *errorTxt);
static bool sendLinkbusTransactionCommand(const String& message, const char *phase, String *errorTxt);

void setup()
{
  Serial.begin(SERIAL_BAUD_RATE);
  initializeUniqueAPName();
  loadCloneResetEvidence();

  lights = new Blinkies();

#define LB_OUTPUT_BUFF_SIZE 25
  g_LBOutputBuff = new CircularStringBuff(LB_OUTPUT_BUFF_SIZE);

  if (filesystemStartupMayProceed())
  {
    g_littleFsMounted = startLittleFS();
    if (!g_littleFsMounted)
    {
      g_littleFsRecoveryReason = "mount-failed";
    }
    if (g_littleFsMounted)
    {
      avrUpdateResumeIfRequired();      /* Resume autonomously if AVR reset removed ESP power mid-update. */
      recoverInterruptedFileUploads(); /* Restore a live file if power failed during a staged replacement. */
      if (!readDefaultsFile())          /* Read default settings from file system */
      {
        saveDefaultsFile();
      }
    }
    filesystemStartupComplete();
  }

  if (!g_littleFsMounted)
  {
    /* Never clone, schedule, or write defaults against an unavailable
     * filesystem. Force the immutable MAC-derived SSID so the recovery target
     * remains unambiguous even if the saved master setting cannot be read. */
    g_littleFsRecoveryMode = true;
    g_IamMaster = false;
  }

#if WIFI_DEBUG_PRINTS_ENABLED
  WiFi.onEvent(eventWiFi);    /* Handle WiFi event */
#endif /* WIFI_DEBUG_PRINTS_ENABLED */

#if TRANSMITTER_COMPILE_DEBUG_PRINTS
  g_xmtr = new Transmitter(g_debug_prints_enabled);
#else
  g_xmtr = new Transmitter(false);
#endif // TRANSMITTER_COMPILE_DEBUG_PRINTS

  if (g_cloneRecoveredResetDetected)
  {
    /* A reset during cloning can leave the AVR suppressing the time report that
     * waitForTimeLoop() requires. Resume it before entering that wait so the
     * target can boot, expose diagnostics, and retry without a power cycle. */
    g_LBOutputBuff->put(LB_MESSAGE_ESP_CLONE_RESUME);
  }

}

/*******************************************************
    Handle WiFi events
 ********************************************************/
#if WIFI_DEBUG_PRINTS_ENABLED
void eventWiFi(WiFiEvent_t event)
{
  String e = String(event);

  switch (event)
  {
    case WIFI_EVENT_STAMODE_CONNECTED:
      {
        Serial.println(String("[WiFi] " + e + ", Connected"));
      }
      break;

    case WIFI_EVENT_STAMODE_DISCONNECTED:
      {
        Serial.println(String("[WiFi] " + e + ", Disconnected - Status " + String( WiFi.status()) + String(connectionStatus( WiFi.status() ).c_str()) ));
      }
      break;

    case WIFI_EVENT_STAMODE_AUTHMODE_CHANGE:
      {
        Serial.println(String("[WiFi] " + e + ", AuthMode Change"));
      }
      break;

    case WIFI_EVENT_STAMODE_GOT_IP:
      {
        Serial.println(String("[WiFi] " + e + ", Got IP"));
      }
      break;

    case WIFI_EVENT_STAMODE_DHCP_TIMEOUT:
      {
        Serial.println(String("[WiFi] " + e + ", DHCP Timeout"));
      }
      break;

    case WIFI_EVENT_SOFTAPMODE_STACONNECTED:
      {
        Serial.println(String("[WiFi] " + e + ", Client Connected"));
      }
      break;

    case WIFI_EVENT_SOFTAPMODE_STADISCONNECTED:
      {
        Serial.println(String("[AP] " + e + ", Client Disconnected"));
      }
      break;

    case WIFI_EVENT_SOFTAPMODE_PROBEREQRECVED:
      {
        Serial.println(String("[AP] " + e + ", Probe Request Recieved"));
      }
      break;

    case WIFI_EVENT_ANY:
      {
        Serial.println(String("[AP] " + e + ", WIFI_EVENT_ANY Recieved"));
      }
      break;

    case WIFI_EVENT_MODE_CHANGE:
      {
        Serial.println(String("[AP] " + e + ", WIFI_EVENT_MODE_CHANGE Recieved"));
      }
      break;

    default:
      {
        /*    case WIFI_EVENT_MAX: */
        Serial.println(String("[AP] " + e + ", WIFI_EVENT_MAX Recieved"));
      }
      break;
  }
}
#endif  /* WIFI_DEBUG_PRINTS_ENABLED */


/*******************************************************
    WiFi Connection Status
 ********************************************************/
String connectionStatus( int which )
{
  switch ( which )
  {
    case WL_CONNECTED:
      {
        return ( "Connected");
      }
      break;

    case WL_NO_SSID_AVAIL:
      {
        return ( "Network not availible");
      }
      break;

    case WL_CONNECT_FAILED:
      {
        return ( "Wrong password");
      }
      break;

    case WL_IDLE_STATUS:
      {
        return ( "Idle status");
      }
      break;

    case WL_DISCONNECTED:
      {
        return ( "Disconnected");
      }
      break;

    default:
      {
        return ( "Unknown");
      }
      break;
  }
}

/*===============================================================
   This routine is executed when you open its IP in browser
  =============================================================== */
void handleRoot()
{
  if (g_littleFsRecoveryMode)
  {
    g_http_server.sendHeader("Cache-Control", "no-store");
    g_http_server.send_P(200, PSTR("text/html; charset=utf-8"), FILESYSTEM_RECOVERY_PAGE_HTML);
    return;
  }
  g_http_server.send_P(200, PSTR("text/html; charset=utf-8"), ROOT_PAGE_HTML);
}

void handleFS()
{
  String message = "<p style=\"text-align:left;\"><a href=\"/\">[HOME]</a></p> <h2 style=\"font-family:verdana; font-size:30px; color:Black; text-align:left;\">File System Contents</h2>";
  String line;
  Dir dir = LittleFS.openDir("/");

  while (dir.next())
  { /* List the file system contents */
    String fileName = dir.fileName();
    size_t fileSize = dir.fileSize();
    line = String("<p>" + fileName + ", size: " + formatBytes(fileSize) + "</p>");
    message += line;
  }

  message += "<form method=\"post\" enctype=\"multipart/form-data\">\r\n";
  message += "File name:<input type=\"text\" name=\"name\">\r\n";
  message += "<input class=\"button\" type=\"submit\" value=\"Download\">\r\n";
  message += "</form>";

  g_http_server.send(200, "text/html", message);
}

void handleUpload()
{
  String message = "<p style=\"text-align:left;\"><a href=\"/\">[HOME]</a></p><form method=\"post\" enctype=\"multipart/form-data\"><input type=\"file\" name=\"name\"><input class=\"button\" type=\"submit\" value=\"Upload\"></form>";

  g_http_server.send(200, "text/html", message);
}

bool firmwareUpdateCloneIsActive()
{
  return g_master_has_connected_slave ||
         g_masterCloneQuietPending ||
         g_masterCloneQuietActive ||
         g_slaveCloneQuietActive;
}

uint32_t firmwareUpdateMaximumSketchSize()
{
  const uint32_t freeSketchSpace = ESP.getFreeSketchSpace();
  if (freeSketchSpace <= 0x1000)
  {
    return 0;
  }
  return (freeSketchSpace - 0x1000) & 0xfffff000UL;
}

void firmwareUpdateCaptureUpdaterError(const String& prefix)
{
  StreamString details;
  Update.printError(details);
  g_firmwareUpdateError = prefix;
  if (details.length())
  {
    g_firmwareUpdateError += ": ";
    g_firmwareUpdateError += details.c_str();
  }
  g_firmwareUpdateError.trim();
}

void firmwareUpdateAbort(const String& reason)
{
  if (Update.isRunning())
  {
    Update.end(false); /* No eboot command is created for an incomplete image. */
  }
  g_firmwareUpdateActive = false;
  g_firmwareUpdateSucceeded = false;
  g_firmwareUpdateError = reason;
}

bool avrSoftwareVersionAtLeast(unsigned int requiredMajor, unsigned int requiredMinor)
{
  unsigned int major = 0;
  unsigned int minor = 0;
  char trailing = '\0';
  return sscanf(g_atmega_sw_version.c_str(), "%u.%u%c", &major, &minor, &trailing) == 2 &&
         (major > requiredMajor || (major == requiredMajor && minor >= requiredMinor));
}

void firmwareUpdateKeepAvrAwake()
{
  /* This mature keep-alive path is also reused by ordinary LittleFS uploads.
   * A long, single HTTP request can prevent the browser WebSocket heartbeat
   * from being serviced before the AVR's two-minute ESP timeout expires. */
  const unsigned long now = millis();
  if (!g_firmwareUpdateLastKeepAliveMillis ||
      (unsigned long)(now - g_firmwareUpdateLastKeepAliveMillis) >= 20000UL)
  {
    if (g_LBOutputBuff && !g_LBOutputBuff->full())
    {
      g_LBOutputBuff->put(
        avrSoftwareVersionAtLeast(0, 209) ?
          LB_MESSAGE_ESP_UPDATE_LEASE :
          LB_MESSAGE_ESP_KEEPALIVE);
      g_firmwareUpdateLastKeepAliveMillis = now;
    }
  }
}

void firmwareUpdateReleaseAvrLease()
{
  /* A maintenance failure must not leave the longer lease active. Restoring
   * the mature ordinary keep-alive immediately returns the AVR to its normal
   * two-minute, activity-renewed shutdown contract. */
  if (g_LBOutputBuff && !g_LBOutputBuff->full())
  {
    g_LBOutputBuff->put(LB_MESSAGE_ESP_KEEPALIVE);
  }
  g_firmwareUpdateLastKeepAliveMillis = 0;
}

void beginSlaveCloneKeepAlive()
{
  cloneKeepAliveBegin(&g_slaveCloneKeepAliveSchedule);
}

void serviceSlaveCloneKeepAlive()
{
  if (g_linkBusEventTransactionActive)
  {
    return;
  }

  const uint32_t now = millis();
  if (cloneKeepAliveIsDue(&g_slaveCloneKeepAliveSchedule, now) &&
      g_LBOutputBuff && !g_LBOutputBuff->full())
  {
    g_LBOutputBuff->put(LB_MESSAGE_ESP_KEEPALIVE);
    cloneKeepAliveWasQueued(&g_slaveCloneKeepAliveSchedule, now);
  }
}

void endSlaveCloneKeepAlive()
{
  cloneKeepAliveEnd(&g_slaveCloneKeepAliveSchedule);
}

void persistCloneResetMarker()
{
  CloneResetMarker marker = g_cloneDiagnostic.active
                            ? cloneResetMarkerActive(
                                (uint32_t)g_cloneDiagnostic.phase,
                                g_cloneDiagnostic.fileIndex,
                                g_cloneDiagnostic.fileCount)
                            : cloneResetMarkerClear();
  ESP.rtcUserMemoryWrite(
    CLONE_RESET_RTC_OFFSET_WORDS,
    reinterpret_cast<uint32_t *>(&marker),
    sizeof(marker));
}

void loadCloneResetEvidence()
{
  CloneResetMarker marker = cloneResetMarkerClear();
  const bool markerRead = ESP.rtcUserMemoryRead(
    CLONE_RESET_RTC_OFFSET_WORDS,
    reinterpret_cast<uint32_t *>(&marker),
    sizeof(marker));

  if (markerRead && cloneResetMarkerWasInterrupted(&marker) &&
      marker.phase <= (uint32_t)CLONE_DIAG_FAILED)
  {
    g_cloneRecoveredResetDetected = true;
    g_cloneRecoveredResetPhase = (CloneDiagnosticPhase)marker.phase;
    g_cloneRecoveredResetFileIndex = (uint16_t)marker.fileIndex;
    g_cloneRecoveredResetFileCount = (uint16_t)marker.fileCount;
    g_cloneRecoveredResetReason = ESP.getResetReason();
  }

  marker = cloneResetMarkerClear();
  ESP.rtcUserMemoryWrite(
    CLONE_RESET_RTC_OFFSET_WORDS,
    reinterpret_cast<uint32_t *>(&marker),
    sizeof(marker));
}

static String jsonEscaped(String value)
{
  value.replace("\\", "\\\\");
  value.replace("\"", "\\\"");
  value.replace("\r", "\\r");
  value.replace("\n", "\\n");
  return value;
}

static String cloneDiagnosticSnapshot()
{
  const uint32_t now = millis();
  String failureReason = g_cloneDiagnosticFailure;
  failureReason.replace(",", ";");
  String resetReason = g_cloneRecoveredResetReason;
  resetReason.replace(",", ";");
  String message;
  /* Clone diagnostics run at the lowest-heap point in the workflow. Reserve
   * once and append in place instead of constructing a long chain of String
   * temporaries immediately before LittleFS metadata operations. */
  message.reserve(384);
  message += SOCK_COMMAND_CLONE_DIAGNOSTIC;
  message += ',';
  message += g_uniqueAPNameString;
  message += ',';
  message += cloneDiagnosticPhaseText(g_cloneDiagnostic.phase);
  message += ',';
  message += cloneDiagnosticPhaseText(g_cloneDiagnostic.failurePhase);
  message += ',';
  message += g_cloneDiagnostic.attempt;
  message += ',';
  message += g_cloneDiagnostic.fileIndex;
  message += ',';
  message += g_cloneDiagnostic.fileCount;
  message += ',';
  message += g_cloneDiagnostic.receivedLines;
  message += ',';
  message += cloneDiagnosticElapsedMillis(&g_cloneDiagnostic, now);
  message += ',';
  message += g_cloneDiagnostic.cleanupConfirmed ? '1' : '0';
  message += ',';
  message += g_cloneDiagnostic.receiveBufferOverflow ? '1' : '0';
  message += ',';
  message += failureReason;
  message += ',';
  message += g_cloneClockExpected;
  message += ',';
  message += g_cloneClockReadback;
  message += ',';
  message += g_cloneClockReadbackDelta;
  message += ',';
  message += cloneDiagnosticPhaseText(g_cloneRecoveredResetPhase);
  message += ',';
  message += g_cloneRecoveredResetFileIndex;
  message += ',';
  message += g_cloneRecoveredResetFileCount;
  message += ',';
  message += resetReason;
  message += ',';
  message += g_cloneDiagnosticFreeHeap;
  message += ',';
  message += g_cloneDiagnosticMinimumFreeHeap;
  message += ',';
  message += g_cloneDiagnosticMaxFreeBlock;
  message += ',';
  message += g_cloneDiagnosticHeapFragmentation;
  message += ',';
  message += g_cloneDiagnostic.temporaryFileCleanupAttempted ? '1' : '0';
  message += ',';
  message += g_cloneDiagnostic.temporaryFileCleanupConfirmed ? '1' : '0';
  message.replace("\r", " ");
  message.replace("\n", " ");
  return message;
}

void captureCloneHeapDiagnostic()
{
  g_cloneDiagnosticFreeHeap = ESP.getFreeHeap();
  if (!g_cloneDiagnosticMinimumFreeHeap ||
      g_cloneDiagnosticFreeHeap < g_cloneDiagnosticMinimumFreeHeap)
  {
    g_cloneDiagnosticMinimumFreeHeap = g_cloneDiagnosticFreeHeap;
  }
  g_cloneDiagnosticMaxFreeBlock = ESP.getMaxFreeBlockSize();
  g_cloneDiagnosticHeapFragmentation = ESP.getHeapFragmentation();
}

void cleanupIncompleteCloneTempFile(File& tempFile)
{
  if (!cloneDiagnosticShouldRemoveIncompleteTemporaryFile(&g_cloneDiagnostic))
  {
    return;
  }

  if (tempFile)
  {
    tempFile.close();
  }
  if (LittleFS.exists("/Temp"))
  {
    LittleFS.remove("/Temp");
  }
  cloneDiagnosticTemporaryFileCleanupFinished(
    &g_cloneDiagnostic,
    !LittleFS.exists("/Temp"));
}

static void emitCloneDiagnosticSnapshot()
{
  String message = cloneDiagnosticSnapshot();
  Serial.println(message);
  if (g_cloneDiagnosticCanReportToMaster)
  {
    g_webSocketLocalClient.sendTXT(stringObjToConstCharString(&message));
  }
}

void reportCloneDiagnosticPhase(CloneDiagnosticPhase phase)
{
  cloneDiagnosticSetPhase(&g_cloneDiagnostic, phase, millis());
  captureCloneHeapDiagnostic();
  persistCloneResetMarker();
  emitCloneDiagnosticSnapshot();
}

void reportCloneDiagnosticFailure(const String& reason)
{
  if (!g_cloneDiagnosticFailure.length())
  {
    g_cloneDiagnosticFailure = reason;
  }
  cloneDiagnosticFail(&g_cloneDiagnostic, millis());
  captureCloneHeapDiagnostic();
  persistCloneResetMarker();
  emitCloneDiagnosticSnapshot();
}

void reportCloneDiagnosticComplete()
{
  cloneDiagnosticComplete(&g_cloneDiagnostic, millis());
  captureCloneHeapDiagnostic();
  persistCloneResetMarker();
  emitCloneDiagnosticSnapshot();
}

String cloneDiagnosticFailureText(const String& fallback)
{
  const String reason = g_cloneDiagnosticFailure.length() ? g_cloneDiagnosticFailure : fallback;
  const CloneDiagnosticPhase phase = g_cloneDiagnostic.phase == CLONE_DIAG_FAILED
                                     ? g_cloneDiagnostic.failurePhase
                                     : g_cloneDiagnostic.phase;
  return String(cloneDiagnosticPhaseText(phase)) + ": " + reason;
}

void handleFirmwareUpdatePage()
{
  g_http_server.sendHeader("Cache-Control", "no-store");
  g_http_server.send_P(200, PSTR("text/html; charset=utf-8"), FIRMWARE_UPDATE_PAGE_HTML);
}

void handleFirmwareUpdateStatus()
{
  String response = "{\"version\":\"";
  response += WIFI_SW_VERSION;
  response += "\",\"deviceSsid\":\"";
  response += g_uniqueAPNameString;
  response += "\",\"filesystemProtected\":true,\"filesystemMounted\":";
  response += g_littleFsMounted ? "true" : "false";
  response += ",\"recoveryMode\":";
  response += g_littleFsRecoveryMode ? "true" : "false";
  response += ",\"filesystemRecoveryReason\":\"";
  response += g_littleFsRecoveryReason;
  response += "\"";
  response += ",\"updateActive\":";
  response += g_firmwareUpdateActive ? "true" : "false";
  response += ",\"restartPending\":";
  response += g_firmwareRestartPending ? "true" : "false";
  response += ",\"cloneActive\":";
  response += firmwareUpdateCloneIsActive() ? "true" : "false";
  response += ",\"currentSketchBytes\":";
  response += String(ESP.getSketchSize());
  response += ",\"currentSketchMd5\":\"";
  response += ESP.getSketchMD5();
  response += "\",\"uptimeMillis\":";
  response += String(millis());
  response += ",\"maximumUpdateBytes\":";
  response += String(firmwareUpdateMaximumSketchSize());
  response += ",\"linkbusEventTransactionActive\":";
  response += g_linkBusEventTransactionActive ? "true" : "false";
  response += ",\"linkbusLastValidFrameMillis\":";
  response += String(g_linkBusLastValidFrameMillis);
  response += ",\"linkbusLastAttempts\":";
  response += String(g_linkBusLastAttempts);
  response += ",\"linkbusLastPhase\":\"";
  response += jsonEscaped(g_linkBusLastPhase);
  response += "\",\"linkbusLastFailure\":\"";
  response += jsonEscaped(g_linkBusLastFailure);
  response += "\",\"cloneDiagnosticActive\":";
  response += g_cloneDiagnostic.active ? "true" : "false";
  response += ",\"cloneDiagnosticPhase\":\"";
  response += cloneDiagnosticPhaseText(g_cloneDiagnostic.phase);
  response += "\",\"cloneDiagnosticFailurePhase\":\"";
  response += cloneDiagnosticPhaseText(g_cloneDiagnostic.failurePhase);
  response += "\",\"cloneDiagnosticFailure\":\"";
  response += jsonEscaped(g_cloneDiagnosticFailure);
  response += "\",\"cloneDiagnosticAttempt\":";
  response += String(g_cloneDiagnostic.attempt);
  response += ",\"cloneDiagnosticFileIndex\":";
  response += String(g_cloneDiagnostic.fileIndex);
  response += ",\"cloneDiagnosticFileCount\":";
  response += String(g_cloneDiagnostic.fileCount);
  response += ",\"cloneDiagnosticReceivedLines\":";
  response += String(g_cloneDiagnostic.receivedLines);
  response += ",\"cloneDiagnosticElapsedMillis\":";
  response += String(cloneDiagnosticElapsedMillis(&g_cloneDiagnostic, millis()));
  response += ",\"cloneDiagnosticPhaseElapsedMillis\":";
  response += String(cloneDiagnosticPhaseElapsedMillis(&g_cloneDiagnostic, millis()));
  response += ",\"cloneDiagnosticCleanupConfirmed\":";
  response += g_cloneDiagnostic.cleanupConfirmed ? "true" : "false";
  response += ",\"cloneDiagnosticReceiveBufferOverflow\":";
  response += g_cloneDiagnostic.receiveBufferOverflow ? "true" : "false";
  response += ",\"cloneDiagnosticTemporaryFileReceptionActive\":";
  response += g_cloneDiagnostic.temporaryFileReceptionActive ? "true" : "false";
  response += ",\"cloneDiagnosticTemporaryFileCleanupAttempted\":";
  response += g_cloneDiagnostic.temporaryFileCleanupAttempted ? "true" : "false";
  response += ",\"cloneDiagnosticTemporaryFileCleanupConfirmed\":";
  response += g_cloneDiagnostic.temporaryFileCleanupConfirmed ? "true" : "false";
  response += ",\"cloneDiagnosticClockExpected\":";
  response += String(g_cloneClockExpected);
  response += ",\"cloneDiagnosticClockReadback\":";
  response += String(g_cloneClockReadback);
  response += ",\"cloneDiagnosticClockDeltaSeconds\":";
  response += String(g_cloneClockReadbackDelta);
  response += ",\"cloneDiagnosticFreeHeap\":";
  response += String(g_cloneDiagnosticFreeHeap);
  response += ",\"cloneDiagnosticMinimumFreeHeap\":";
  response += String(g_cloneDiagnosticMinimumFreeHeap);
  response += ",\"cloneDiagnosticMaxFreeBlock\":";
  response += String(g_cloneDiagnosticMaxFreeBlock);
  response += ",\"cloneDiagnosticHeapFragmentation\":";
  response += String(g_cloneDiagnosticHeapFragmentation);
  response += ",\"cloneRecoveredResetDetected\":";
  response += g_cloneRecoveredResetDetected ? "true" : "false";
  response += ",\"cloneRecoveredResetPhase\":\"";
  response += cloneDiagnosticPhaseText(g_cloneRecoveredResetPhase);
  response += "\",\"cloneRecoveredResetFileIndex\":";
  response += String(g_cloneRecoveredResetFileIndex);
  response += ",\"cloneRecoveredResetFileCount\":";
  response += String(g_cloneRecoveredResetFileCount);
  response += ",\"cloneRecoveredResetReason\":\"";
  response += jsonEscaped(g_cloneRecoveredResetReason);
  response += "\",\"masterLastTargetDiagnosticMillis\":";
  response += String(g_masterLastTargetDiagnosticMillis);
  response += ",\"masterLastTargetDiagnostic\":\"";
  response += jsonEscaped(g_masterLastTargetDiagnostic);
  response += "\",\"masterCloneSessionStartedMillis\":";
  response += String(g_masterCloneSessionStartedMillis);
  response += ",\"masterCloneLastProgressMillis\":";
  response += String(g_masterCloneLastProgressMillis);
  response += ",\"masterCloneRecoveryCount\":";
  response += String(g_masterCloneRecoveryCount);
  response += ",\"masterCloneLastFailure\":\"";
  response += jsonEscaped(g_masterCloneLastFailure);
  response += "\"";
  response += "}";
  g_http_server.sendHeader("Cache-Control", "no-store");
  g_http_server.send(200, "application/json", response);
}

void handleFirmwareUpdateResult()
{
  g_http_server.sendHeader("Cache-Control", "no-store");
  g_http_server.sendHeader("Connection", "close");
  if (g_firmwareUpdateSucceeded && g_firmwareRestartPending)
  {
    g_http_server.send_P(200, PSTR("text/html; charset=utf-8"), FIRMWARE_UPDATE_SUCCESS_HTML);
    return;
  }

  firmwareUpdateReleaseAvrLease();
  String response = "Firmware update rejected. The running firmware and LittleFS were not changed.";
  if (g_firmwareUpdateError.length())
  {
    response += "\n";
    response += g_firmwareUpdateError;
  }
  g_http_server.send(firmwareUpdateCloneIsActive() ? 409 : 400, "text/plain; charset=utf-8", response);
}

void handleFirmwareUpdateUpload()
{
  HTTPUpload& upload = g_http_server.upload();

  if (upload.status == UPLOAD_FILE_START)
  {
    g_firmwareUpdateActive = false;
    g_firmwareUpdateSucceeded = false;
    g_firmwareUpdateError = "";
    g_firmwareUpdateExpectedSize = 0;
    g_firmwareUpdateReceivedSize = 0;
    g_firmwareUpdateExpectedCrc32 = 0;
    g_firmwareUpdateRunningCrc32 = 0xffffffffUL;
    g_firmwareUpdateLastKeepAliveMillis = 0;

    if (g_firmwareRestartPending)
    {
      g_firmwareUpdateError = "A validated update is already waiting for reboot";
      return;
    }
    if (firmwareUpdateCloneIsActive())
    {
      g_firmwareUpdateError = "Finish or cancel cloning before updating firmware";
      return;
    }
    if (upload.name != "firmware" ||
        !firmwareUpdateHasBinExtension(upload.filename.c_str()))
    {
      g_firmwareUpdateError = "Only an uncompressed .bin sketch is accepted";
      return;
    }
    if (g_http_server.arg("confirm") != "UPDATE")
    {
      g_firmwareUpdateError = "Explicit update confirmation is missing";
      return;
    }

    const uint32_t maximumSize = firmwareUpdateMaximumSketchSize();
    if (!maximumSize ||
        !firmwareUpdateParseSize(
          g_http_server.arg("size").c_str(),
          maximumSize,
          &g_firmwareUpdateExpectedSize) ||
        g_firmwareUpdateExpectedSize < 4096)
    {
      g_firmwareUpdateError = "Firmware size is missing, invalid, or too large";
      return;
    }
    if (!firmwareUpdateParseCrc32(
          g_http_server.arg("crc32").c_str(),
          &g_firmwareUpdateExpectedCrc32))
    {
      g_firmwareUpdateError = "Firmware CRC32 is missing or invalid";
      return;
    }

    if (!Update.begin(g_firmwareUpdateExpectedSize, U_FLASH))
    {
      firmwareUpdateCaptureUpdaterError("Unable to stage sketch update");
      return;
    }
    g_firmwareUpdateActive = true;
    firmwareUpdateKeepAvrAwake();
  }
  else if (upload.status == UPLOAD_FILE_WRITE)
  {
    if (!g_firmwareUpdateActive)
    {
      return;
    }
    if (upload.currentSize >
        g_firmwareUpdateExpectedSize - g_firmwareUpdateReceivedSize)
    {
      firmwareUpdateAbort("Upload contains more data than declared");
      return;
    }
    if (Update.write(upload.buf, upload.currentSize) != upload.currentSize)
    {
      firmwareUpdateCaptureUpdaterError("Flash staging write failed");
      g_firmwareUpdateActive = false;
      return;
    }
    g_firmwareUpdateRunningCrc32 = firmwareUpdateCrc32(
      g_firmwareUpdateRunningCrc32,
      upload.buf,
      upload.currentSize);
    g_firmwareUpdateReceivedSize += upload.currentSize;
    firmwareUpdateKeepAvrAwake();
  }
  else if (upload.status == UPLOAD_FILE_END)
  {
    if (!g_firmwareUpdateActive)
    {
      return;
    }
    const uint32_t receivedCrc32 = g_firmwareUpdateRunningCrc32 ^ 0xffffffffUL;
    if (upload.totalSize != g_firmwareUpdateExpectedSize ||
        g_firmwareUpdateReceivedSize != g_firmwareUpdateExpectedSize)
    {
      firmwareUpdateAbort("Upload ended before the declared firmware size was received");
      return;
    }
    if (receivedCrc32 != g_firmwareUpdateExpectedCrc32)
    {
      firmwareUpdateAbort("Firmware CRC32 did not match the complete uploaded file");
      return;
    }
    if (!Update.isFinished() || !Update.end(false))
    {
      firmwareUpdateCaptureUpdaterError("Staged sketch failed final validation");
      g_firmwareUpdateActive = false;
      return;
    }

    g_firmwareUpdateActive = false;
    g_firmwareUpdateSucceeded = true;
    g_firmwareRestartPending = true;
    g_firmwareRestartAtMillis = millis() + 1500UL;
  }
  else if (upload.status == UPLOAD_FILE_ABORTED)
  {
    firmwareUpdateAbort("Upload was interrupted before validation completed");
  }
  delay(0);
}

void serviceFirmwareUpdateRestart()
{
  if (g_firmwareRestartPending &&
      (long)(millis() - g_firmwareRestartAtMillis) >= 0)
  {
    g_http_server.stop();
    delay(50);
    ESP.restart();
  }
}

void handleAvrUpdatePage()
{
  g_http_server.sendHeader("Cache-Control", "no-store");
  g_http_server.send_P(200, PSTR("text/html; charset=utf-8"), AVR_FIRMWARE_UPDATE_PAGE_HTML);
}

void handleAvrUpdateStatus()
{
  g_http_server.sendHeader("Cache-Control", "no-store");
  g_http_server.send(200, "application/json", avrUpdateStatusJson(g_uniqueAPNameString));
}

void handleAvrUpdateJournal()
{
  g_http_server.sendHeader("Cache-Control", "no-store");
  File journal = LittleFS.open(AVR_UPDATE_JOURNAL_PATH, "r");
  if(!journal)
  {
    g_http_server.send(404, "text/plain; charset=utf-8", "No AVR update journal is available");
    return;
  }
  g_http_server.streamFile(journal, "text/plain; charset=utf-8");
  journal.close();
}

void handleAvrQualificationStatus()
{
  g_http_server.sendHeader("Cache-Control", "no-store");
  g_http_server.send(200, "application/json",
    String("{\"armedPage\":") + String(g_avrQualificationResetPage) +
    ",\"resetReady\":" + (g_avrQualificationResetReady ? "true" : "false") + "}");
}

void handleAvrQualificationContinue()
{
  if(!g_avrQualificationResetReady ||
     g_http_server.arg("confirm") != "CONTINUE-AFTER-AVR-RESET")
  {
    g_http_server.send(409, "text/plain; charset=utf-8", "No qualified AVR reset pause is active");
    return;
  }
  g_avrQualificationResetContinue = true;
  g_http_server.send(200, "text/plain; charset=utf-8", "AVR reset injection acknowledged");
}

/* Called only from the blocking AVR updater. Normal updates return immediately;
 * an explicitly armed qualification run temporarily reopens HTTP so the host
 * can synchronize an Atmel-ICE reset to an exact verified page. */
bool serviceAvrUpdateQualificationPause(uint16_t pageIndex, uint32_t address)
{
  (void)address;
  g_avrQualificationResetPage = (int16_t)pageIndex;
  g_avrQualificationResetReady = true;
  g_avrQualificationResetContinue = false;
  g_http_server.begin();
  const uint32_t deadline = millis() + 60000UL;
  while(!g_avrQualificationResetContinue && (int32_t)(deadline - millis()) > 0)
  {
    g_http_server.handleClient();
    if(lights) lights->blinkLEDs(250, RED_BLUE_ALTERNATING, true);
    delay(1);
    yield();
  }
  g_http_server.stop();
  const bool acknowledged = g_avrQualificationResetContinue;
  g_avrQualificationResetPage = -1;
  g_avrQualificationResetReady = false;
  g_avrQualificationResetContinue = false;
  return acknowledged;
}

void handleAvrUpdateResult()
{
  firmwareUpdateReleaseAvrLease();
  g_http_server.sendHeader("Cache-Control", "no-store");
  if(g_avrUpdateUploadSucceeded)
  {
    g_http_server.send(200, "text/html; charset=utf-8",
      "<!doctype html><html><body><h1>AVR image staged</h1><p>The complete image passed its CRC check and is stored for power-loss recovery.</p><p><a href='/avr-update'>Continue to SSID authorization</a></p></body></html>");
    return;
  }
  String response = "AVR update image rejected. The running AVR was not changed.";
  if(g_avrUpdateError.length()) response += String("\n") + g_avrUpdateError;
  g_http_server.send(400, "text/plain; charset=utf-8", response);
}

void handleAvrUpdateUpload()
{
  HTTPUpload& upload = g_http_server.upload();
  if(upload.status == UPLOAD_FILE_START)
  {
    g_avrUpdateUploadActive = false;
    g_avrUpdateUploadSucceeded = false;
    g_avrUpdateError = "";
    g_avrUpdateExpectedSize = 0;
    g_avrUpdateReceivedSize = 0;
    g_avrUpdateExpectedCrc32 = 0;
    g_avrUpdateRunningCrc32 = 0xffffffffUL;
    g_avrUpdateTargetVersion = g_http_server.arg("version");
    LittleFS.remove(AVR_UPDATE_STAGING_PATH);

    if(g_firmwareUpdateActive || g_firmwareRestartPending || firmwareUpdateCloneIsActive() || g_linkBusEventTransactionActive)
    {
      g_avrUpdateError = "Finish the current firmware, clone, or event transaction first";
      return;
    }
    if(upload.name != "firmware" || !firmwareUpdateHasBinExtension(upload.filename.c_str()))
    {
      g_avrUpdateError = "Only an uncompressed FlexFox80 AVR .bin is accepted";
      return;
    }
    if(g_http_server.arg("confirm") != "STAGE" || !g_avrUpdateTargetVersion.length())
    {
      g_avrUpdateError = "Staging confirmation or target version is missing";
      return;
    }
    if(!firmwareUpdateParseSize(g_http_server.arg("size").c_str(), AVR_UPDATE_MAX_IMAGE_BYTES, &g_avrUpdateExpectedSize) ||
       !g_avrUpdateExpectedSize || (g_avrUpdateExpectedSize % AVR_UPDATE_PAGE_SIZE) != 0)
    {
      g_avrUpdateError = "AVR image size is invalid or not page aligned";
      return;
    }
    if(!firmwareUpdateParseCrc32(g_http_server.arg("crc32").c_str(), &g_avrUpdateExpectedCrc32))
    {
      g_avrUpdateError = "AVR image CRC32 is missing or invalid";
      return;
    }
    if(!avrUpdateCanStageImage(g_avrUpdateExpectedSize, &g_avrUpdateError))
    {
      return;
    }
    g_avrUpdateUploadFile = LittleFS.open(AVR_UPDATE_STAGING_PATH, "w");
    if(!g_avrUpdateUploadFile)
    {
      g_avrUpdateError = "Unable to create the persistent staging file";
      return;
    }
    g_avrUpdateUploadActive = true;
    firmwareUpdateKeepAvrAwake();
  }
  else if(upload.status == UPLOAD_FILE_WRITE)
  {
    if(!g_avrUpdateUploadActive) return;
    if(upload.currentSize > g_avrUpdateExpectedSize - g_avrUpdateReceivedSize ||
       g_avrUpdateUploadFile.write(upload.buf, upload.currentSize) != upload.currentSize)
    {
      g_avrUpdateError = "Persistent AVR staging write failed or exceeded declared size";
      g_avrUpdateUploadActive = false;
      g_avrUpdateUploadFile.close();
      LittleFS.remove(AVR_UPDATE_STAGING_PATH);
      return;
    }
    g_avrUpdateRunningCrc32 = avrUpdateCrc32(g_avrUpdateRunningCrc32, upload.buf, upload.currentSize);
    g_avrUpdateReceivedSize += upload.currentSize;
    firmwareUpdateKeepAvrAwake();
  }
  else if(upload.status == UPLOAD_FILE_END)
  {
    if(!g_avrUpdateUploadActive) return;
    g_avrUpdateUploadFile.flush();
    g_avrUpdateUploadFile.close();
    g_avrUpdateUploadActive = false;
    const uint32_t receivedCrc32 = g_avrUpdateRunningCrc32 ^ 0xffffffffUL;
    if(upload.totalSize != g_avrUpdateExpectedSize || g_avrUpdateReceivedSize != g_avrUpdateExpectedSize)
    {
      g_avrUpdateError = "Upload ended before the declared AVR image size was received";
    }
    else if(receivedCrc32 != g_avrUpdateExpectedCrc32)
    {
      g_avrUpdateError = "AVR image CRC32 did not match the complete uploaded file";
    }
    else if(!avrUpdateCommitStagedImage(g_avrUpdateExpectedSize, receivedCrc32, g_avrUpdateTargetVersion, &g_avrUpdateError))
    {
    }
    else
    {
      g_avrUpdateUploadSucceeded = true;
      return;
    }
    LittleFS.remove(AVR_UPDATE_STAGING_PATH);
  }
  else if(upload.status == UPLOAD_FILE_ABORTED)
  {
    if(g_avrUpdateUploadFile) g_avrUpdateUploadFile.close();
    g_avrUpdateUploadActive = false;
    g_avrUpdateError = "AVR upload was interrupted before validation completed";
    LittleFS.remove(AVR_UPDATE_STAGING_PATH);
  }
  delay(0);
}

static bool currentEventFileIsActive(String *eventName)
{
  populateEventFileList();
  const unsigned long currentEpoch = g_timeOfDayFromTx;
  for(int index = 0; index < g_numberOfEventFilesFound; index++)
  {
    const EventFileRef& event = g_eventList[index];
    if(event.startDateTimeEpoch <= currentEpoch && currentEpoch < event.finishDateTimeEpoch)
    {
      if(eventName) *eventName = event.ename;
      return true;
    }
  }
  return false;
}

static bool fleetSoakHttpIsAvailable(void)
{
  if (fleetSoakPageIsAvailable(g_IamMaster))
  {
    return true;
  }
  g_masterFleetSoakMode = FLEET_SOAK_MODE_OFF;
  g_http_server.send(404, "text/plain; charset=utf-8", "Fleet Soak is not installed on this master");
  return false;
}

static bool fleetSoakOperationIsBusy(void)
{
  return firmwareUpdateCloneIsActive() || g_firmwareUpdateActive ||
         g_firmwareRestartPending || g_linkBusEventTransactionActive;
}

void handleFleetSoakStatus(void)
{
  if (!fleetSoakHttpIsAvailable())
  {
    return;
  }
  FSInfo info;
  const bool haveFilesystemInfo = LittleFS.info(info) && info.usedBytes <= info.totalBytes;
  String response = "{";
  response += String("\"protocolVersion\":") + FLEET_SOAK_PROTOCOL_VERSION;
  response += String(",\"eventCapacity\":") + MAXIMUM_NUMBER_OF_EVENTS;
  response += String(",\"eventCount\":") + fleetSoakEventFileCount();
  response += String(",\"ordinaryEventCount\":") + fleetSoakOrdinaryEventCount();
  response += String(",\"reservedEventCount\":") + fleetSoakReservedEventCount();
  response += String(",\"suiteReady\":") + (fleetSoakSuiteIsReady() ? "true" : "false");
  response += String(",\"mode\":") + g_masterFleetSoakMode;
  response += String(",\"operationActive\":") + (fleetSoakOperationIsBusy() ? "true" : "false");
  if (haveFilesystemInfo)
  {
    response += String(",\"filesystemFreeBytes\":") + (info.totalBytes - info.usedBytes);
  }
  response += "}";
  g_http_server.send(200, "application/json; charset=utf-8", response);
}

void handleFleetSoakActivate(void)
{
  if (!fleetSoakHttpIsAvailable())
  {
    return;
  }
  if (g_http_server.arg("confirm") != "ACTIVATE_RESERVED_SUITE" ||
      fleetSoakOperationIsBusy())
  {
    g_http_server.send(409, "text/plain; charset=utf-8", "Fleet Soak activation is not currently permitted");
    return;
  }
  String activeEventName;
  if (currentEventFileIsActive(&activeEventName))
  {
    g_http_server.send(409, "text/plain; charset=utf-8", "Fleet Soak cannot activate while an event is running");
    return;
  }
  String error;
  if (!fleetSoakActivateInstalledSuite(&error))
  {
    g_http_server.send(409, "text/plain; charset=utf-8", error);
    return;
  }
  g_ESP_Comm_State = TX_READ_ALL_EVENTS_FILES;
  g_http_server.send(200, "text/plain; charset=utf-8", "Fleet Soak suite activated");
}

void handleFleetSoakCleanup(void)
{
  if (!fleetSoakHttpIsAvailable())
  {
    return;
  }
  if (g_http_server.arg("confirm") != "REMOVE_RESERVED_EVENTS" ||
      fleetSoakOperationIsBusy())
  {
    g_http_server.send(409, "text/plain; charset=utf-8", "Fleet Soak cleanup is not currently permitted");
    return;
  }
  String activeEventName;
  if (currentEventFileIsActive(&activeEventName))
  {
    g_http_server.send(409, "text/plain; charset=utf-8", "Fleet Soak cannot clean up while an event is running");
    return;
  }
  int removedCount = 0;
  String error;
  if (!fleetSoakCleanupReservedEvents(&removedCount, &error))
  {
    g_http_server.send(409, "text/plain; charset=utf-8", error);
    return;
  }
  g_masterFleetSoakMode = FLEET_SOAK_MODE_OFF;
  g_ESP_Comm_State = TX_READ_ALL_EVENTS_FILES;
  g_http_server.send(200, "text/plain; charset=utf-8",
                     String("Fleet Soak cleanup complete; removed ") + removedCount + " reserved event files");
}

static bool avrBootloaderIdentityIsCompatible(const String& identity)
{
  /* Keep compatibility tied to the protocol and fixed Flash geometry, while
   * allowing reviewed behavior-only revisions of the resident BL0 bootloader. */
  if(!identity.startsWith("BL0.")) return false;
  const int versionEnd = identity.indexOf(',');
  if(versionEnd <= 4 || identity.substring(versionEnd) != ",2,0x4000,512") return false;
  for(int i = 4; i < versionEnd; i++)
  {
    if(!isDigit(identity.charAt(i))) return false;
  }
  return identity.substring(4, versionEnd).toInt() >= 3;
}

void handleAvrUpdateStart()
{
  String error;
  g_avrQualificationResetPage = -1;
  g_avrQualificationResetReady = false;
  g_avrQualificationResetContinue = false;
  String suppliedSuffix = g_http_server.arg("unlock");
  suppliedSuffix.trim();
  suppliedSuffix.toUpperCase();
  if(g_uniqueAPNameString.length() < 4)
  {
    g_http_server.send(503, "text/plain; charset=utf-8", "The unique ESP update identity is unavailable");
    return;
  }
  String expectedSuffix = g_uniqueAPNameString.substring(g_uniqueAPNameString.length() - 4);
  expectedSuffix.toUpperCase();
  if(suppliedSuffix.length() != 4 || suppliedSuffix != expectedSuffix)
  {
    g_http_server.send(403, "text/plain; charset=utf-8",
                       "AVR update authorization must match the last four characters of this ESP's unique Tx_ SSID");
    return;
  }
  if(g_http_server.arg("confirm") != "START" || firmwareUpdateCloneIsActive() ||
     g_firmwareUpdateActive || g_firmwareRestartPending || g_linkBusEventTransactionActive ||
     !avrUpdateHasStagedImage())
  {
    error = "AVR update cannot start while another operation is active or no validated image is staged";
    g_http_server.send(409, "text/plain; charset=utf-8", error);
    return;
  }
  String activeEventName;
  if(currentEventFileIsActive(&activeEventName))
  {
    error = String("Cancel the active event file before updating the AVR: ") + activeEventName;
    g_http_server.send(409, "text/plain; charset=utf-8", error);
    return;
  }

  /*
   * The resident-bootloader search can take longer than the ordinary two-minute
   * WiFi shutdown clock when the first handoff is missed. Reacquire the bounded
   * five-minute maintenance lease before draining the queue so a recoverable
   * handoff failure returns to HTTP service instead of powering the ESP off.
   */
  firmwareUpdateKeepAvrAwake();
  g_avrBootloaderAvailable = false;
  g_avrBootloaderIdentity = "";
  bool residentBootloader = false;
  const bool applicationPreflight =
    drainLinkbusBeforeEvent(&error) &&
    sendLinkbusTransactionCommand(String(LB_MESSAGE_AVR_UPDATE_QUERY), "AVR bootloader capability", &error) &&
    g_avrBootloaderAvailable &&
    avrBootloaderIdentityIsCompatible(g_avrBootloaderIdentity);
  if(!applicationPreflight)
  {
    residentBootloader = avrUpdateResidentBootloaderPresent();
  }
  if(!applicationPreflight && !residentBootloader)
  {
    if(!error.length()) error = "The AVR did not prove a protocol-2 BL0.3-or-newer bootloader and 0x4000 application layout";
    firmwareUpdateReleaseAvrLease();
    g_http_server.send(409, "text/plain; charset=utf-8", error);
    return;
  }
  if(!avrUpdateMarkEnteringBootloader(&error))
  {
    firmwareUpdateReleaseAvrLease();
    g_http_server.send(500, "text/plain; charset=utf-8", error);
    return;
  }
  if(g_http_server.arg("qualificationConfirm") == "ARM-ESP-RESTART")
  {
    const long restartPage = g_http_server.arg("qualificationRestartPage").toInt();
    if(restartPage < 1 || restartPage > 65535L ||
       !avrUpdateArmQualificationEspRestart((uint16_t)restartPage, &error))
    {
      avrUpdateRestoreStaged(NULL);
      firmwareUpdateReleaseAvrLease();
      g_http_server.send(400, "text/plain; charset=utf-8", error);
      return;
    }
  }
  else if(g_http_server.arg("qualificationConfirm") == "ARM-AVR-RESET")
  {
    const long resetPage = g_http_server.arg("qualificationResetPage").toInt();
    if(resetPage < 1 || resetPage > 65535L ||
       !avrUpdateArmQualificationAvrReset((uint16_t)resetPage, &error))
    {
      avrUpdateRestoreStaged(NULL);
      firmwareUpdateReleaseAvrLease();
      g_http_server.send(400, "text/plain; charset=utf-8", error);
      return;
    }
  }
  else if(g_http_server.arg("qualificationConfirm").length())
  {
    avrUpdateRestoreStaged(NULL);
    firmwareUpdateReleaseAvrLease();
    g_http_server.send(400, "text/plain; charset=utf-8", "Unknown AVR update qualification request");
    return;
  }

  /* The capability transaction already drained the queue and returned with its
   * ACK consumed.  Send START immediately while that exclusive condition still
   * holds.  Sending the HTTP response and delaying first lets ordinary Linkbus
   * traffic refill the queue, causing a redundant second drain to time out. */
  bool success = residentBootloader ||
                 sendLinkbusTransactionCommand(String(LB_MESSAGE_AVR_UPDATE_START), "AVR bootloader entry", &error);
  if(!success)
  {
    g_avrQualificationResetPage = -1;
    avrUpdateRestoreStaged(NULL);
    firmwareUpdateReleaseAvrLease();
    g_linkBusLastFailure = error;
    g_http_server.send(409, "text/plain; charset=utf-8", error);
  }
  else
  {
    g_http_server.sendHeader("Connection", "close");
    g_http_server.send(202, "text/plain; charset=utf-8",
      "Bootloader entry authorized by the unique ESP SSID suffix; programming will resume automatically.");
    /* Keep the UART session that just proved either the running application or
     * resident bootloader.  Rebooting the ESP here can lose the otherwise-good
     * AVR bootloader link on installed FlexFox hardware.  Persistent state still
     * resumes safely after an actual interruption. */
    delay(150);
    g_http_server.stop();
    avrUpdateResumeIfRequired(residentBootloader);
    /* Successful programming restarts the ESP and never returns.  A bounded
     * pre-erase recovery return must restore service so status and retry remain
     * available without requiring a power cycle. */
    g_http_server.begin();
    firmwareUpdateReleaseAvrLease();
  }
}

void handleSuccess()
{
  String message = "<html><head><title>Success</title></head><body><p><a href=\"/\">[HOME]</a></p><h1 style=\"font-family:verdana;font-size:30px;color:Black;text-align:left;\">File uploaded successfully!</h1></body></html>";

  g_http_server.send(200, "text/html", message);
}

void fileDelete()
{
  fileDeleteWithMessage("");
}

void fileDeleteWithMessage(String msg)
{
  String message = "<p style=\"text-align:left;\"><a href=\"/\">[HOME]</a></p> <h2 style=\"font-family:verdana; font-size:30px; color:Black; text-align:left;\">File System Contents</h2>";
  String line;
  Dir dir = LittleFS.openDir("/");

  while (dir.next())
  { /* List the file system contents */
    String fileName = dir.fileName();
    size_t fileSize = dir.fileSize();
    line = String("<p>" + fileName + ", size: " + formatBytes(fileSize) + "</p>");
    message += line;
  }

  message += "<form method=\"post\" enctype=\"multipart/form-data\">\r\n";
  message += "File name:<input type=\"text\" name=\"name\">\r\n";
  message += "<input class=\"button\" type=\"submit\" value=\"Delete\">\r\n";
  message += "</form>";

  if (msg.length() > 0)
  {
    message += msg;
  }

  g_http_server.send(200, "text/html", message);
}

void handleNotFound()
{
  if (g_littleFsRecoveryMode)
  {
    g_http_server.sendHeader("Cache-Control", "no-store");
    g_http_server.send_P(503, PSTR("text/html; charset=utf-8"), FILESYSTEM_RECOVERY_PAGE_HTML);
    return;
  }

  /* if the requested file or page doesn't exist, return a 404 not found error */
  if (!handleFileRead(g_http_server.uri()))
  { /* check if the file exists in the flash memory (LittleFS), if so, send it */
    String message = "<p style=\"text-align:left;\"><a href=\"/\">[HOME]</a></p><p>File Not Found</p>";
    message += "URI: ";
    message += g_http_server.uri();
    message += "\nMethod: ";
    message += (g_http_server.method() == HTTP_GET) ? "GET" : "POST";
    message += "\nArguments: ";
    message += g_http_server.args();
    message += "\n";
    for (uint8_t i = 0; i < g_http_server.args(); i++)
    {
      message += " " + g_http_server.argName(i) + ": " + g_http_server.arg(i) + "\n";
    }
    g_http_server.send(404, "text/html", message);
  }
  else
  {
    String filename = String(g_http_server.uri());

#if TRANSMITTER_COMPILE_DEBUG_PRINTS
    if (g_debug_prints_enabled)
    {
      Serial.println("File read:" + filename);
    }
#endif // TRANSMITTER_COMPILE_DEBUG_PRINTS
  }
}

void initializeUniqueAPName()
{
  uint8_t mac[WL_MAC_ADDR_LENGTH];
  WiFi.softAPmacAddress(mac);
  char macID[9];
  /* Format bytes, not integers, so every MAC-derived identity has exactly
   * eight uppercase hex digits even when a byte contains a leading zero. */
  snprintf(macID, sizeof(macID), "%02X%02X%02X%02X",
           mac[WL_MAC_ADDR_LENGTH - 4], mac[WL_MAC_ADDR_LENGTH - 3],
           mac[WL_MAC_ADDR_LENGTH - 2], mac[WL_MAC_ADDR_LENGTH - 1]);
  g_uniqueAPNameString = String("Tx_") + macID;
}


bool setupHTTP_AP()
{
  bool success = false;

  g_numberOfSocketClients = 0;
  g_numberOfWebClients = 0;
  Serial.setDebugOutput(false);

#if WIFI_DEBUG_PRINTS_ENABLED
  Serial.printf("Initial connection status: %d\n", WiFi.status());
  WiFi.printDiag(Serial);
#endif

  WiFi.mode(WIFI_AP_STA);
  /* Event subscription */
  e1 = WiFi.onSoftAPModeStationConnected(onNewStation);
  e2 = WiFi.onSoftAPModeStationDisconnected(onStationDisconnect);

  /*  WiFi.mode(WIFI_AP); */

  /* Keep an immutable per-ESP identity even while master mode advertises Tx_Master. */
  if (!g_uniqueAPNameString.length())
  {
    initializeUniqueAPName();
  }
  g_AP_NameString = g_IamMaster ? MASTER_SSID : g_uniqueAPNameString;

  IPAddress apIP = stringToIP(g_softAP_IP_addr);

  if (apIP == IPAddress(-1, -1, -1, -1))
  {
    apIP = stringToIP(String(SOFT_AP_IP_ADDR_DEFAULT)); /* some reasonable default address */
  }

  WiFi.softAPConfig(apIP, apIP, IPAddress(255, 255, 255, 0));

  if (g_bridgePW.length() > 0)
  {
    success = WiFi.softAP(stringObjToConstCharString(&g_AP_NameString), stringObjToConstCharString(&g_bridgePW));
  }
  else
  {
    success = WiFi.softAP(stringObjToConstCharString(&g_AP_NameString));
  }

  if (success)
  {
#if TRANSMITTER_COMPILE_DEBUG_PRINTS
    IPAddress myIP = WiFi.softAPIP();   /*Get IP address */
#endif // TRANSMITTER_COMPILE_DEBUG_PRINTS

    /* Start TCP listener on port TCP_PORT */
    g_http_server.on("/", HTTP_GET, handleRoot);                        /* Call the 'handleRoot' function when a client requests URI "/" */

    /* These handlers are compiled into the sketch and deliberately remain
     * available when LittleFS cannot be mounted. */
    g_http_server.on("/firmware", HTTP_GET, handleFirmwareUpdatePage);
    g_http_server.on("/firmware/status", HTTP_GET, handleFirmwareUpdateStatus);
    g_http_server.on(
      "/firmware",
      HTTP_POST,
      handleFirmwareUpdateResult,
      handleFirmwareUpdateUpload);

    if (g_littleFsMounted)
    {
      g_http_server.on("/download", HTTP_GET, handleFS);                        /* Provide utility to help manage the file system */
      g_http_server.on("/download.html", HTTP_GET, handleFS);                   /* Provide utility to help manage the file system */

      g_http_server.on("/download", HTTP_POST, handleFileDownload);             /* go to 'handleFileDownload' */
      g_http_server.on("/download.html", HTTP_POST, handleFileDownload);        /* go to 'handleFileDownload' */

      g_http_server.on("/delete", HTTP_GET, fileDelete);              /* Provide utility to help manage the file system */
      g_http_server.on("/delete.html", HTTP_GET, fileDelete);         /* Provide utility to help manage the file system */

      g_http_server.on("/delete", HTTP_POST, handleFileDelete);       /* go to 'handleFileDelete' */
      g_http_server.on("/delete.html", HTTP_POST, handleFileDelete);  /* go to 'handleFileDelete' */

      g_http_server.on("/upload", HTTP_GET, handleUpload);
      g_http_server.on("/upload.html", HTTP_GET, handleUpload);

      g_http_server.on("/avr-update", HTTP_GET, handleAvrUpdatePage);
      g_http_server.on("/avr-update/status", HTTP_GET, handleAvrUpdateStatus);
      g_http_server.on("/avr-update/log", HTTP_GET, handleAvrUpdateJournal);
      g_http_server.on("/avr-update/qualification/status", HTTP_GET, handleAvrQualificationStatus);
      g_http_server.on("/avr-update/qualification/continue", HTTP_POST, handleAvrQualificationContinue);
      g_http_server.on(
        "/avr-update",
        HTTP_POST,
        handleAvrUpdateResult,
        handleAvrUpdateUpload);
      g_http_server.on("/avr-update/start", HTTP_POST, handleAvrUpdateStart);

      g_http_server.on("/fleet-soak/status", HTTP_GET, handleFleetSoakStatus);
      g_http_server.on("/fleet-soak/activate", HTTP_POST, handleFleetSoakActivate);
      g_http_server.on("/fleet-soak/cleanup", HTTP_POST, handleFleetSoakCleanup);

      g_http_server.on(
        "/upload.html",
        HTTP_POST,
        handleFileUploadResult,
        handleFileUpload);

      g_http_server.on(
        "/upload",
        HTTP_POST,
        handleFileUploadResult,
        handleFileUpload);
    }

    g_http_server.onNotFound(handleNotFound);   /* When a client requests an unknown URI (i.e. something other than "/"), call function "handleNotFound" */
    g_http_server.begin();

    /*    startWebSocketServer(); // Start a WebSocket server */

#if TRANSMITTER_COMPILE_DEBUG_PRINTS
    if (g_debug_prints_enabled)
    {
      Serial.print(g_AP_NameString + " server started: ");
      Serial.println(myIP);
    }
#endif // TRANSMITTER_COMPILE_DEBUG_PRINTS
  }

  return (success);
}


/* Manage incoming device connection on ESP access point */
void onNewStation(WiFiEventSoftAPModeStationConnected sta_info)
{
  char newMac[20];

  sprintf(newMac, MACSTR, MAC2STR(sta_info.mac));
  String newMacStr = String(newMac);
  newMacStr.toUpperCase();
  bool found = false;
  int emptyClientIndex = -1;

  for (int i = 0; i < MAX_NUMBER_OF_WEB_CLIENTS; i++)
  {
    if ((emptyClientIndex < 0) && !(g_webSocketClient[i].macAddr).length())
    {
      emptyClientIndex = i;
    }

    if (newMacStr.equals(g_webSocketClient[i].macAddr))
    {
      found = true;
#if TRANSMITTER_COMPILE_DEBUG_PRINTS
      if (g_debug_prints_enabled)
      {
        Serial.println("Station found in existing list.");
      }
#endif // TRANSMITTER_COMPILE_DEBUG_PRINTS
      g_webSocketClient[i].webID = sta_info.aid;
      g_webSocketClient[i].socketID = WEBSOCKETS_SERVER_CLIENT_MAX;
      break;
    }
  }

  g_numberOfWebClients = WiFi.softAPgetStationNum();
  g_numberOfSocketClients = g_webSocketServer.connectedClients(false);

  if (!found && (emptyClientIndex >= 0))
  {
    g_webSocketClient[emptyClientIndex].macAddr = newMacStr;
    g_webSocketClient[emptyClientIndex].webID = sta_info.aid;
    g_webSocketClient[emptyClientIndex].socketID = WEBSOCKETS_SERVER_CLIENT_MAX;
  }

#if TRANSMITTER_COMPILE_DEBUG_PRINTS
  if (g_debug_prints_enabled)
  {
    Serial.println("New Station: " + newMacStr);
    Serial.println("  Total stations: " + String(g_numberOfWebClients) + "; Socket clients: " + String(g_numberOfSocketClients));

    for (int i = 0; (i < g_numberOfSocketClients) && (i < MAX_NUMBER_OF_WEB_CLIENTS); i++)
    {
      Serial.printf("%d. WebSocketClient: WebID# %d. MAC address : %s\n", i, g_webSocketClient[i].webID, (g_webSocketClient[i].macAddr).c_str());
    }
  }
#endif // TRANSMITTER_COMPILE_DEBUG_PRINTS

  g_noActivityTimeoutSeconds = NO_ACTIVITY_TIMEOUT;
  if (g_littleFsMounted)
  {
    startWebSocketServer(); /* Start WebSocket commands only when configuration state is available. */
  }
}

void onStationDisconnect(WiFiEventSoftAPModeStationDisconnected sta_info)
{
  char newMac[20];

  sprintf(newMac, MACSTR, MAC2STR(sta_info.mac));
  String oldMacStr = String(newMac);
  oldMacStr.toUpperCase();

  for (int i = 0; i < MAX_NUMBER_OF_WEB_CLIENTS; i++)
  {
    if (oldMacStr.equals(g_webSocketClient[i].macAddr))
    {
      g_webSocketClient[i].webID = 0;
      g_webSocketClient[i].macAddr = "";
      g_webSocketClient[i].socketID = WEBSOCKETS_SERVER_CLIENT_MAX;

#if TRANSMITTER_COMPILE_DEBUG_PRINTS
      if (g_debug_prints_enabled)
      {
        Serial.println("Station removed from list.");
      }
#endif // TRANSMITTER_COMPILE_DEBUG_PRINTS
      break;
    }
  }

  g_numberOfWebClients = WiFi.softAPgetStationNum();
  g_numberOfSocketClients = g_webSocketServer.connectedClients(false);

#if TRANSMITTER_COMPILE_DEBUG_PRINTS
  if (g_debug_prints_enabled)
  {
    Serial.println("Station Exit:");
    Serial.printf("  Remaining stations: %d\n", g_numberOfWebClients);
  }

  if (g_debug_prints_enabled)
  {
    for (int i = 0; i < MAX_NUMBER_OF_WEB_CLIENTS; i++)
    {
      if ((g_webSocketClient[i].macAddr).length())
      {
        Serial.printf("WebID# %d. sockID# %d. MAC address : %s\n", g_webSocketClient[i].webID, g_webSocketClient[i].socketID, (g_webSocketClient[i].macAddr).c_str());
      }
    }
  }
#endif // TRANSMITTER_COMPILE_DEBUG_PRINTS
}


bool setupWiFiAPConnection()
{
  bool err = false;
  int tries = 0;
  bool sentComsOFF = false;

  lights->setLEDs(RED_BLUE_TOGETHER, g_LEDs_enabled);

  /* We start by connecting to a WiFi network */

#ifdef MULTI_ACCESS_POINT_SUPPORT
  if (strlen(stringObjToConstCharString(&g_masterSSID_PWD)) > 0)
  {
    wifiMulti.addAP(stringObjToConstCharString(&g_masterSSID), stringObjToConstCharString(&g_masterSSID_PWD));    /* add Wi-Fi networks you want to connect to */
  }
  else
  {
    wifiMulti.addAP(stringObjToConstCharString(&g_masterSSID));
  }

#if TRANSMITTER_COMPILE_DEBUG_PRINTS
  if (g_debug_prints_enabled)
  {
    Serial.print("Connecting ...");
  }
#endif // #if TRANSMITTER_COMPILE_DEBUG_PRINTS

  unsigned long holdMillis = millis();

  while (wifiMulti.run() != WL_CONNECTED)
  {
    linkbusLoop();

    if ((unsigned long)(millis() - holdMillis) > 250)
    {
      holdMillis = millis();
      if (lights->blinkLEDs(100, RED_BLUE_TOGETHER, true))
      {
        if (!sentComsOFF)
        {
          lights->setLEDs(RED_BLUE_TOGETHER, true);
          Serial.print(LB_MESSAGE_WIFI_COMS_OFF);    /* send immediate */
          sentComsOFF = true;
          if (g_slave_released)
          {
            g_webSocketSlaveState = WSClientCleanup;
          }
          err = true;
          break;
        }
      }
#if TRANSMITTER_COMPILE_DEBUG_PRINTS
      if (g_debug_prints_enabled)
      {
        Serial.print(".");
      }
#endif // #if TRANSMITTER_COMPILE_DEBUG_PRINTS

      tries++;

      if (tries > 60)
      {
        err = true;
        break;
      }
    }
  }

#else // MULTI_ACCESS_POINT_SUPPORT

#if TRANSMITTER_COMPILE_DEBUG_PRINTS
  if (g_debug_prints_enabled)
  {
    Serial.println();
    Serial.print("Connecting to ");
    Serial.println(g_masterSSID);
  }
#endif // TRANSMITTER_COMPILE_DEBUG_PRINTS

  if (WiFi.status() == WL_CONNECTED)
  {
    WiFi.disconnect();
    delay(2500);
  }

  if (g_masterSSID_PWD.length() < 1)
  {
    WiFi.begin(stringObjToConstCharString(&g_masterSSID);
  }
  else
  {
    WiFi.begin(stringObjToConstCharString(&g_masterSSID), stringObjToConstCharString(&g_masterSSID_PWD));
  }

  while (WiFi.status() != WL_CONNECTED)
  {
    delay(250);
    if (lights->blinkLEDs(100, RED_BLUE_TOGETHER, true))
    {
      if (!sentComsOFF)
      {
        lights->setLEDs(RED_BLUE_TOGETHER, true);
        Serial.print(LB_MESSAGE_WIFI_COMS_OFF);    /* send immediate */
        sentComsOFF = true;
        if (g_slave_released)
        {
          g_webSocketSlaveState = WSClientCleanup;
        }
        err = true;
        break;
      }
    }

#if TRANSMITTER_COMPILE_DEBUG_PRINTS
    if (g_debug_prints_enabled)
    {
      Serial.print(".");
    }
#endif // TRANSMITTER_COMPILE_DEBUG_PRINTS

    tries++;

    if (tries > 60)
    {
      err = true;
      break;
    }
    else if ((tries == 20) || (tries == 40))
    {
      if (g_hotspotPW.length() < 1)
      {
        WiFi.begin(stringObjToConstCharString(&g_masterSSID));
      }
      else
      {
        WiFi.begin(stringObjToConstCharString(&g_masterSSID), stringObjToConstCharString(&g_masterSSID_PWD));
      }
    }
  }
#endif  /* MULTI_ACCESS_POINT_SUPPORT */


  if (err)
  {
#if TRANSMITTER_COMPILE_DEBUG_PRINTS
    if (g_debug_prints_enabled)
    {
      Serial.println('\n');
      Serial.println("Unable to find master tx.");
    }
#endif // TRANSMITTER_COMPILE_DEBUG_PRINTS
    lights->setLEDs(RED_BLUE_TOGETHER, true);
  }
  else
  {
    lights->setLEDs(BLUE_LED_ONLY, true);

#if TRANSMITTER_COMPILE_DEBUG_PRINTS
    if (g_debug_prints_enabled)
    {
      Serial.println('\n');
      Serial.print("Connected to ");
      Serial.println(WiFi.SSID());    /* Tell us what network we're connected to */
      Serial.print("IP address:\t");
      Serial.println(WiFi.localIP()); /* Send the IP address of the ESP8266 to the computer */
    }
#endif // TRANSMITTER_COMPILE_DEBUG_PRINTS
  }

  return (err);
}


void loop()
{
  String arg1, arg2;
  int blinkPeriodMillis = 500;

#if TRANSMITTER_COMPILE_DEBUG_PRINTS
  g_debug_prints_enabled = DEBUG_PRINTS_ENABLE_DEFAULT;   /* kluge override of saved settings */

  /* HTTP Server */
  if (g_debug_prints_enabled)
  {
    Serial.println("Starting loop()...");
  }
#endif // TRANSMITTER_COMPILE_DEBUG_PRINTS

  lights->setLEDs(LEDS_ON, g_LEDs_enabled);

  if (g_littleFsRecoveryMode)
  {
    /* Do not attempt cloning, event selection, or defaults access. The ordinary
     * HTTP loop continues Linkbus service and retains the AVR's absolute WiFi
     * shutdown authority while exposing only sketch-resident recovery routes. */
    g_LBOutputBuff->put(LB_MESSAGE_ESP_WAKEUP);
    g_LBOutputBuff->put(LB_MESSAGE_VER_REQUEST);
    linkbusLoop();
    if (setupHTTP_AP())
    {
      httpWebServerLoop(100);
    }
    lights->setLEDs(LEDS_OFF, g_LEDs_enabled);
    return;
  }

  waitForTimeLoop(); /* Wait for baud calibration and time update from ATMEGA */

  if (g_IamMaster)
  {
    populateEventFileList();   /* read files into the event list */
    g_numberOfScheduledEvents = numberOfEventsScheduled(g_timeOfDayFromTx);
    g_LBOutputBuff->put(LB_MESSAGE_ESP_KEEPALIVE);
    linkbusLoop();

    if (g_numberOfScheduledEvents)
    {
#if TRANSMITTER_COMPILE_DEBUG_PRINTS
      if (g_debug_prints_enabled)
      {
        String msg = String("Scheduled event(s): ") + g_numberOfScheduledEvents;
        Serial.println(msg);
      }
#endif // TRANSMITTER_COMPILE_DEBUG_PRINTS

      if (!g_activeEvent)
      {
#if TRANSMITTER_COMPILE_DEBUG_PRINTS
        g_activeEvent = new Event(g_debug_prints_enabled);
#else
        g_activeEvent = new Event(false);
#endif // TRANSMITTER_COMPILE_DEBUG_PRINTS
      }

      g_LBOutputBuff->put(LB_MESSAGE_ESP_KEEPALIVE);

      if (!loadActiveEventFile(g_eventList[0].path))
      {
#if TRANSMITTER_COMPILE_DEBUG_PRINTS
        if (g_debug_prints_enabled)
        {
          String msg = String("Scheduled event loaded: ");
          msg = msg + g_activeEvent->getEventName();
          Serial.println(msg);
        }
#endif // TRANSMITTER_COMPILE_DEBUG_PRINTS
      }
      else
      {
        blinkPeriodMillis = 100;
#if TRANSMITTER_COMPILE_DEBUG_PRINTS
        if (g_debug_prints_enabled)
        {
          Serial.println("Scheduled event load failed.");
        }
#endif // TRANSMITTER_COMPILE_DEBUG_PRINTS
      }
    }
    else
    {
      blinkPeriodMillis = 100;
#if TRANSMITTER_COMPILE_DEBUG_PRINTS
      if (g_debug_prints_enabled)
      {
        Serial.println("No scheduled events found.");
      }
#endif // TRANSMITTER_COMPILE_DEBUG_PRINTS
    }
  }
  else /* IamSlave */
  {
    g_slaveClonePruneTargetEvents = false;
    g_slaveFleetSoakMode = FLEET_SOAK_MODE_OFF;
    g_slaveFleetSoakAssignment = "";
    g_slaveFleetSoakCapabilitySeen = false;
    g_slaveFleetSoakSessionReady = false;
    cloneEventManifestReset(&g_cloneEventManifest);
    if (!g_onlyUpdateEvent)
    {
      beginSlaveCloneKeepAlive();
      cloneDiagnosticBegin(&g_cloneDiagnostic, millis());
      g_cloneDiagnosticFailure = "";
      g_cloneDiagnosticFreeHeap = 0;
      g_cloneDiagnosticMinimumFreeHeap = 0;
      g_cloneDiagnosticMaxFreeBlock = 0;
      g_cloneDiagnosticHeapFragmentation = 0;
      captureCloneHeapDiagnostic();
      g_cloneClockExpected = 0;
      g_cloneClockReadback = 0;
      g_cloneClockReadbackDelta = 0;
      g_cloneDiagnosticCanReportToMaster = false;
      persistCloneResetMarker();
      emitCloneDiagnosticSnapshot();
    }

    if (!g_onlyUpdateEvent && !setupWiFiAPConnection())
    {
      g_webSocketLocalClient.begin("73.73.73.73", 81);
      g_webSocketLocalClient.onEvent(webSocketClientEvent);

#if TRANSMITTER_COMPILE_DEBUG_PRINTS
      if (g_debug_prints_enabled)
      {
        Serial.println("Client started\n");
      }
#endif // TRANSMITTER_COMPILE_DEBUG_PRINTS

      g_slave_released = true;

      if (!clientConnectLoop())
      {
        Serial.println(LB_MESSAGE_ESP_KEEPALIVE);

        if (!clientUpdateEventFilesLoop())
        {
          g_LBOutputBuff->put(LB_MESSAGE_ESP_KEEPALIVE);
          populateEventFileList();   /* read files into the event list */
          g_numberOfScheduledEvents = numberOfEventsScheduled(g_timeOfDayFromTx);
          linkbusLoop();

          if (g_slaveFleetSoakMode != FLEET_SOAK_MODE_OFF)
          {
            bool targetReady = true;
            String resultDetail = g_slaveFleetSoakAssignment;
            if (g_slaveFleetSoakMode == FLEET_SOAK_MODE_PROVISION)
            {
              if (g_numberOfScheduledEvents)
              {
                g_LBOutputBuff->put(LB_MESSAGE_ESP_KEEPALIVE);
                if (!loadActiveEventFile(g_eventList[0].path))
                {
                  g_activeEventIndex = 0;
                }
                else
                {
                  targetReady = false;
                  resultDetail = "Could not program the first scheduled Fleet Soak event";
                }
              }
              else
              {
                targetReady = false;
                resultDetail = "No Fleet Soak events are scheduled to run";
              }
            }

            String msg = String(SOCK_COMMAND_FLEET_SOAK_RESULT) + "," + g_uniqueAPNameString + "," +
                         fleetSoakModeText(g_slaveFleetSoakMode) + "," + (targetReady ? "OK" : "ERROR") + "," +
                         resultDetail + "," + fleetSoakReservedEventCount();
            g_webSocketLocalClient.sendTXT(stringObjToConstCharString(&msg));
            blinkPeriodMillis = targetReady ? 500 : 100;
            shutdownSlave();
            g_webSocketServer.loop();
          }
          else if (g_numberOfScheduledEvents)
          {
            g_LBOutputBuff->put(LB_MESSAGE_ESP_KEEPALIVE);
            if (!loadActiveEventFile(g_eventList[0].path))
            {
              g_activeEventIndex = 0;
              String msg = String(String(SOCK_COMMAND_SLAVE_UPDATE_SUCCESS) + "," + g_activeEvent->getTxDescriptiveName(g_activeEvent->getTxAssignment()) + "," + g_activeEvent->getEventName());
              g_webSocketLocalClient.sendTXT(stringObjToConstCharString(&msg)); /* Send to Master */
              blinkPeriodMillis = 500;
            }
            else
            {
              blinkPeriodMillis = 100;
            }

            shutdownSlave();
          }
          else
          {
            reportCloneDiagnosticFailure("no events are scheduled to run after transfer");
            String msg = String(SOCK_COMMAND_SLAVE_UPDATE_ERROR);
            msg = msg + "," + cloneDiagnosticFailureText("No events scheduled to run");
            g_webSocketLocalClient.sendTXT(stringObjToConstCharString(&msg)); /* Send to Master */
            blinkPeriodMillis = 100;
            shutdownSlave();
          }

          g_webSocketServer.loop();
        }
        else
        {
          blinkPeriodMillis = 100;
          shutdownSlave();
        }
      }
      else
      {
        blinkPeriodMillis = 100;
        if (g_cloneDiagnostic.phase != CLONE_DIAG_FAILED)
        {
          reportCloneDiagnosticFailure("master handshake or clock synchronization failed");
        }
      }
    }
    else
    {
      if (!g_onlyUpdateEvent)
      {
        reportCloneDiagnosticFailure("could not associate with master access point");
      }
      /* Load the next active event */
      populateEventFileList();   /* read files into the event list */
      g_numberOfScheduledEvents = numberOfEventsScheduled(g_timeOfDayFromTx);
      linkbusLoop();

      if (g_numberOfScheduledEvents)
      {
        if (loadActiveEventFile(g_eventList[0].path))
        {
          blinkPeriodMillis = 100;
        }
      }
      else
      {
        blinkPeriodMillis = 100;
      }
    }

    if (!g_onlyUpdateEvent)
    {
      endSlaveCloneKeepAlive();
    }
  }

  if (g_onlyUpdateEvent)
  {
    unsigned long last = 0;

    while (1)
    {
      linkbusLoop();
      yield();
      if ((unsigned long)(millis() - last) > 5000)
      {
        last = millis();
        String msgOut = String(LB_MESSAGE_ESP_SHUTDOWN); /* Tell ATMEGA to shut down WiFi */
        g_LBOutputBuff->put(msgOut);
      }
    }
  }
  else if (setupHTTP_AP())
  {
    httpWebServerLoop(blinkPeriodMillis); /* Pass the blink rate to the next loop */
  }

  Serial.println("Escaped!");

  lights->setLEDs(LEDS_OFF, g_LEDs_enabled);
}

bool setAVRCloneQuietMode(bool quiet)
{
  unsigned long started = millis();

  while (!g_LBOutputBuff->empty() || g_linkBusAckPending)
  {
    g_webSocketLocalClient.loop();
    linkbusLoop();
    yield();

    if ((unsigned long)(millis() - started) > 12000)
    {
      return false;
    }
  }

  g_linkBusAckTimoutOccurred = false;
  g_linkBusNacksReceived = 0;
  g_LBOutputBuff->put(quiet ? LB_MESSAGE_ESP_CLONE_QUIET : LB_MESSAGE_ESP_CLONE_RESUME);
  started = millis();

  while (!g_LBOutputBuff->empty() || g_linkBusAckPending)
  {
    g_webSocketLocalClient.loop();
    linkbusLoop();
    yield();

    if (g_linkBusAckTimoutOccurred || g_linkBusNacksReceived || ((unsigned long)(millis() - started) > 12000))
    {
      return false;
    }
  }

  g_slaveCloneQuietActive = quiet;
  return !g_linkBusAckTimoutOccurred && !g_linkBusNacksReceived;
}

static void clearFleetSoakCandidate(void)
{
  g_fleetSoakCandidateSocket = -1;
  g_fleetSoakCandidateSsid = "";
  g_fleetSoakCandidateAssignment = "";
}

void endMasterCloneSession()
{
  if (g_masterCloneQuietPending || g_masterCloneQuietActive)
  {
    g_LBOutputBuff->put(LB_MESSAGE_ESP_CLONE_RESUME);
  }

  g_masterCloneQuietPending = false;
  g_masterCloneQuietActive = false;
  g_master_has_connected_slave = false;
  g_slave_socket_number = -1;
  clearFleetSoakCandidate();
}

static const char *fleetSoakModeText(FleetSoakMode mode)
{
  if (mode == FLEET_SOAK_MODE_PROVISION)
  {
    return FLEET_SOAK_MODE_TEXT_PROVISION;
  }
  if (mode == FLEET_SOAK_MODE_CLEANUP)
  {
    return FLEET_SOAK_MODE_TEXT_CLEANUP;
  }
  return FLEET_SOAK_MODE_TEXT_OFF;
}

static int masterCloneFileCount(void)
{
  /* Ordinary clone behavior is untouched unless the optional page has armed a target. */
  if (g_masterFleetSoakMode == FLEET_SOAK_MODE_PROVISION &&
      g_slave_socket_number == g_fleetSoakCandidateSocket)
  {
    return fleetSoakSuiteIsReady() ? FLEET_SOAK_EVENT_COUNT : 0;
  }
  if (g_masterFleetSoakMode == FLEET_SOAK_MODE_CLEANUP &&
      g_slave_socket_number == g_fleetSoakCandidateSocket)
  {
    return 0;
  }
  return g_numberOfEventFilesFound;
}

static String masterCloneFilePath(int index)
{
  if (g_masterFleetSoakMode == FLEET_SOAK_MODE_PROVISION &&
      g_slave_socket_number == g_fleetSoakCandidateSocket)
  {
    if (index >= 0 && index < FLEET_SOAK_EVENT_COUNT)
    {
      return String(FLEET_SOAK_EVENT_PATHS[index]);
    }
    return "";
  }
  if (index >= 0 && index < g_numberOfEventFilesFound)
  {
    return g_eventList[index].path;
  }
  return "";
}

static void sendMasterCloneText(String message)
{
  /* Fleet sessions are target-specific; ordinary clone retains its broadcast behavior. */
  if (g_masterFleetSoakMode != FLEET_SOAK_MODE_OFF && g_slave_socket_number >= 0)
  {
    g_webSocketServer.sendTXT(
      (uint8_t)g_slave_socket_number,
      stringObjToConstCharString(&message),
      message.length());
  }
  else
  {
    g_webSocketServer.broadcastTXT(stringObjToConstCharString(&message), message.length());
  }
}

static void sendFleetSoakTargetInfo(void)
{
  String sprintAssignment;
  String classicAssignment;
  String storedFleetAssignment;
  fleetSoakOrdinaryAssignmentEvidence(&sprintAssignment, &classicAssignment);
  fleetSoakStoredAssignmentEvidence(&storedFleetAssignment);
  String message = String(SOCK_COMMAND_FLEET_SOAK_INFO) + "," + g_uniqueAPNameString + "," +
                   FLEET_SOAK_PROTOCOL_VERSION + "," + fleetSoakEventFileCount() + "," +
                   fleetSoakReservedEventCount() + "," + (fleetSoakSuiteIsReady() ? "1" : "0") + "," +
                   sprintAssignment + "," + classicAssignment + "," + storedFleetAssignment;
  g_webSocketLocalClient.sendTXT(stringObjToConstCharString(&message));
}

void serviceMasterCloneHandshake()
{
  if (!g_masterCloneQuietPending)
  {
    return;
  }

  if (g_linkBusAckTimoutOccurred || g_linkBusNacksReceived)
  {
    if (g_slave_socket_number >= 0)
    {
      String msg = String(SOCK_COMMAND_SLAVE) + "," + SLAVE_FREE;
      g_webSocketServer.sendTXT(g_slave_socket_number, stringObjToConstCharString(&msg), msg.length());
    }
    endMasterCloneSession();
    return;
  }

  if (g_LBOutputBuff->empty() && !g_linkBusAckPending)
  {
    g_masterCloneQuietPending = false;
    g_masterCloneQuietActive = true;

    if (g_slave_socket_number >= 0)
    {
      String msg = String(SOCK_COMMAND_CLONE_PRUNE_EVENTS) + "," +
                   (g_masterClonePruneTargetEvents ? "1" : "0");
      g_webSocketServer.sendTXT(g_slave_socket_number, stringObjToConstCharString(&msg), msg.length());

      msg = String(SOCK_COMMAND_SLAVE) + "," + SLAVE_CONFIRMED;
      g_webSocketServer.sendTXT(g_slave_socket_number, stringObjToConstCharString(&msg), msg.length());
    }
  }
}

void serviceMasterCloneWatchdog()
{
  if (!masterCloneProgressTimedOut(
        g_master_has_connected_slave,
        g_masterCloneLastProgressMillis,
        millis()))
  {
    return;
  }

  const int staleSocket = g_slave_socket_number;
  g_masterCloneLastFailure = "target made no clone progress for 15 seconds";
  g_masterCloneRecoveryCount++;

  if (staleSocket >= 0)
  {
    String msg = String(SOCK_COMMAND_SLAVE) + "," + SLAVE_FREE;
    g_webSocketServer.sendTXT(
      (uint8_t)staleSocket,
      stringObjToConstCharString(&msg),
      msg.length());
  }

  /* Always resume the master's AVR and clear ownership, even when the TCP
   * library still considers the vanished target socket connected. */
  endMasterCloneSession();
  if (staleSocket >= 0)
  {
    g_webSocketServer.disconnect((uint8_t)staleSocket);
  }
}

void shutdownSlave()
{
  int times2try = 2;
  bool ready = false;
  unsigned long last = millis();
  int state = 0;
  const bool priorFailure = g_cloneDiagnostic.phase == CLONE_DIAG_FAILED;

  if (!priorFailure)
  {
    reportCloneDiagnosticPhase(CLONE_DIAG_CLEANUP_RESUME);
  }
  g_cloneDiagnostic.cleanupConfirmed = setAVRCloneQuietMode(false);
  if (!g_cloneDiagnostic.cleanupConfirmed)
  {
    if (!priorFailure)
    {
      reportCloneDiagnosticFailure("AVR resume acknowledgement was not confirmed");
    }
    else
    {
      emitCloneDiagnosticSnapshot();
    }
  }
  else if (!priorFailure)
  {
    reportCloneDiagnosticPhase(CLONE_DIAG_RELEASE);
  }

  while (!ready)
  {
    g_webSocketLocalClient.loop();
    linkbusLoop();
    yield();

    switch (state)
    {
      case 0:
        {
          if (times2try)
          {
            if ((unsigned long)(millis() - last) > 1000)
            {
              last = millis();
              times2try--;
            }
          }
          else
          {
            String msg = String(SOCK_COMMAND_SLAVE) + "," + SLAVE_FREE;
            g_webSocketLocalClient.sendTXT(stringObjToConstCharString(&msg)); /* Send to Master */
            times2try = 5;
            state++;
          }
        }
        break;

      case 1:
        {
          if (times2try)
          {
            if ((unsigned long)(millis() - last) > 1000)
            {
              last = millis();
              times2try--;
            }

            if (g_slave_released)
            {
              g_webSocketLocalClient.disconnect();
              WiFi.disconnect();
              wifiMulti.cleanAPlist();
              ready = true;
            }
          }
          else
          {
            g_webSocketLocalClient.disconnect();
            WiFi.disconnect();
            wifiMulti.cleanAPlist();
            ready = true;
          }
        }
        break;
    }
  }

  if (!priorFailure && g_cloneDiagnostic.cleanupConfirmed && g_slave_released)
  {
    reportCloneDiagnosticComplete();
  }
  else if (!priorFailure && g_cloneDiagnostic.cleanupConfirmed && g_cloneDiagnostic.phase != CLONE_DIAG_FAILED)
  {
    reportCloneDiagnosticFailure("master did not confirm target release");
  }

  return;
}


bool waitForTimeLoop()
{
  bool failure = true;
  int times2try = 5; /* Allow time for baud calibration */
  bool ready = false;
  unsigned long last = millis();
  bool baudSet = false;
  bool sentComsOFF = false;

//  while (times2try)
//  {
//    g_webSocketLocalClient.loop();
//    linkbusLoop();
//    yield();
//
//    if ((unsigned long)(millis() - last) > 1000)
//    {
//      last = millis();
//      times2try--;
//      Serial.write(0);
//      Serial.write(85);
//      Serial.flush();
//    }
//  }

  /* Inform the ATMEGA that WiFi power up is complete */
  g_LBOutputBuff->put(LB_MESSAGE_ESP_WAKEUP);

  while (!ready)
  {
    g_webSocketLocalClient.loop();
    linkbusLoop();
    yield();
    if (lights->blinkLEDs(500, RED_BLUE_TOGETHER, true))
    {
      if (!sentComsOFF)
      {
        lights->setLEDs(RED_BLUE_TOGETHER, true);
        Serial.print(LB_MESSAGE_WIFI_COMS_OFF);    /* send immediate */
        sentComsOFF = true;
      }
    }

    if (!baudSet && g_baud_sync_success)
    {
      baudSet = true;
      times2try = 10;
    }

    if (g_timeOfDayFromTx)
    {
      g_numberOfScheduledEvents = numberOfEventsScheduled(g_timeOfDayFromTx);
      ready = true;
      failure = false;
#if TRANSMITTER_COMPILE_DEBUG_PRINTS
      if (g_debug_prints_enabled)
      {
        Serial.println(String("Received time from tx: ") + g_timeOfDayFromTx);
      }
#endif // TRANSMITTER_COMPILE_DEBUG_PRINTS

    }
    else if (times2try)
    {
      if ((unsigned long)(millis() - last) > 1000)
      {
        last = millis();
        times2try--;
        g_LBOutputBuff->put(LB_MESSAGE_ESP_WAKEUP);
      }
    }
    else
    {
#if TRANSMITTER_COMPILE_DEBUG_PRINTS
      if (g_debug_prints_enabled)
      {
        Serial.println("Timeout waiting for Tx time.");
      }
#endif // TRANSMITTER_COMPILE_DEBUG_PRINTS

      ready = true;
    }
  }

  return failure;
}


bool clientConnectLoop()
{
  bool failure = true;
  String temp;
  LEDPattern ledPattern = RED_BLUE_TOGETHER;
  String errorMessage = String("");

  int blinkPeriodMillis = 100;
  String msg;
  /* A rebooted target may need to outlast the master's stale-session watchdog
   * before its reconnect can be accepted. */
  int times2try = 10;
  bool syncFailed = true;
  bool busy = true;
  static unsigned long last = 0;

  reportCloneDiagnosticPhase(CLONE_DIAG_AVR_QUIET);
  if (!setAVRCloneQuietMode(true))
  {
    reportCloneDiagnosticFailure(
      g_linkBusNacksReceived ? "AVR rejected clone quiet mode" :
      (g_linkBusAckTimoutOccurred ? "AVR clone quiet acknowledgement timed out" :
       "AVR clone quiet queue did not drain"));
    setAVRCloneQuietMode(false);
    return true;
  }
  reportCloneDiagnosticPhase(CLONE_DIAG_MASTER_HANDSHAKE);

  while (busy)
  {
    g_webSocketLocalClient.loop();
    linkbusLoop();
    yield();

    lights->blinkLEDs(blinkPeriodMillis, ledPattern, true);

    switch (g_webSocketSlaveState)
    {
      case WSClientConnecting:
        {
          if (g_slave_released && times2try)
          {
            if ((unsigned long)(millis() - last) > 2000)
            {
              msg = String(SOCK_COMMAND_SLAVE) + "," + SLAVE_CONNECT;
              g_webSocketLocalClient.sendTXT(stringObjToConstCharString(&msg)); /* Connect to Master */
              g_cloneDiagnostic.attempt++;
              g_cloneDiagnostic.updatedMillis = millis();
              emitCloneDiagnosticSnapshot();
              last = millis();
              times2try--;
            }
          }
          else
          {
            if (!g_slave_released) /* Success */
            {
              times2try = 5;
              g_slaveSyncReadySent = false;
              g_slaveSyncReadyStartedMillis = millis();
              g_webSocketSlaveState = WSClientSyncClock;
              reportCloneDiagnosticPhase(CLONE_DIAG_CLOCK_READY);

#if TRANSMITTER_COMPILE_DEBUG_PRINTS
              if (g_debug_prints_enabled)
              {
                Serial.println("WSc: Active");
              }
#endif // TRANSMITTER_COMPILE_DEBUG_PRINTS
            }
            else
            {
              errorMessage = "master did not accept target connection";
              g_webSocketSlaveState = WSClientClose;

#if TRANSMITTER_COMPILE_DEBUG_PRINTS
              if (g_debug_prints_enabled)
              {
                Serial.println("WSc: failed connection (1)");
              }
#endif // TRANSMITTER_COMPILE_DEBUG_PRINTS
            }
          }
        }
        break;

      case WSClientSyncClock:
        {
          if (g_slave_released)
          {
            errorMessage = "master released target before clock synchronization";
            g_webSocketSlaveState = WSClientClose;

#if TRANSMITTER_COMPILE_DEBUG_PRINTS
            if (g_debug_prints_enabled)
            {
              Serial.println("WSc: failed connection (2)");
            }
#endif // TRANSMITTER_COMPILE_DEBUG_PRINTS
          }
          else
          {
            g_linkBusAckTimoutOccurred = false;
            g_linkBusNacksReceived = 0;
            times2try = 5;
            if ((unsigned long)(millis() - g_slaveSyncReadyStartedMillis) > 12000)
            {
              errorMessage = "master clock synchronization message timed out";
              g_webSocketSlaveState = WSClientClose;
            }
            else if (!g_slaveSyncReadySent)
            {
              msg = String(SOCK_COMMAND_SLAVE) + "," + SLAVE_SYNC_READY;
              g_webSocketLocalClient.sendTXT(stringObjToConstCharString(&msg));
              g_slaveSyncReadySent = true;
            }
            /* Wait in this state until the master's next-edge sync message arrives. */
          }
        }
        break;

      case WSClientWaitForSyncAck:
        {
          if (g_slave_released)
          {
            blinkPeriodMillis = 100;
            errorMessage = "master released target during clock readback";
            g_webSocketSlaveState = WSClientClose;

#if TRANSMITTER_COMPILE_DEBUG_PRINTS
            if (g_debug_prints_enabled)
            {
              Serial.println("WSc: failed connection (3)");
            }
#endif // TRANSMITTER_COMPILE_DEBUG_PRINTS
          }
          else if (g_cloneClockVerified && g_LBOutputBuff->empty() && !g_linkBusAckPending && !g_linkBusAckTimoutOccurred && !g_linkBusNacksReceived)
          {
#if TRANSMITTER_COMPILE_DEBUG_PRINTS
            if (g_debug_prints_enabled)
            {
              Serial.println("WSc: Sync ack received.");
            }
#endif // TRANSMITTER_COMPILE_DEBUG_PRINTS
            g_webSocketSlaveState = WSClientExitSuccess;
            failure = false;
            reportCloneDiagnosticPhase(CLONE_DIAG_FILE_WAIT);
          }
          else if (g_cloneClockReadbackMismatch || g_linkBusAckTimoutOccurred || g_linkBusNacksReceived || ((unsigned long)(millis() - g_cloneClockWaitStartedMillis) > 10000))
          {
            errorMessage = g_cloneClockReadbackMismatch ? "clock readback did not match requested time" :
                           (g_linkBusNacksReceived ? "AVR rejected synchronized clock" :
                            (g_linkBusAckTimoutOccurred ? "clock write acknowledgement timed out" :
                             "clock readback timed out"));
            g_webSocketSlaveState = WSClientClose;

#if TRANSMITTER_COMPILE_DEBUG_PRINTS
            if (g_debug_prints_enabled)
            {
              Serial.println("WSc: verified clock readback failed");
            }
#endif // TRANSMITTER_COMPILE_DEBUG_PRINTS
          }
        }
        break;

      case WSClientExitSuccess:
        {
          if (failure)
          {
            g_webSocketSlaveState = WSClientCleanup;
          }
          else
          {
            busy = false;
          }
        }
        break;

      case WSClientClose:
        {
          if (syncFailed)
          {
            if (g_cloneDiagnostic.phase != CLONE_DIAG_FAILED)
            {
              reportCloneDiagnosticFailure(
                errorMessage.length() ? errorMessage : String("connection state closed without a reason"));
            }
            errorMessage = cloneDiagnosticFailureText(errorMessage);
            msg = String(SOCK_COMMAND_SLAVE_UPDATE_ERROR);
            if (errorMessage.length())
            {
              msg = msg + "," + errorMessage;
            }
            g_webSocketLocalClient.sendTXT(stringObjToConstCharString(&msg)); /* Send to Master */
            g_webSocketServer.loop();
            times2try = 3;
            syncFailed = false;
          }

          if (times2try)
          {
            if ((unsigned long)(millis() - last) > 1000)
            {
              last = millis();
              times2try--;
            }
          }
          else
          {
            g_webSocketLocalClient.disconnect();

            if (g_fileDataBuff)
            {
              delete g_fileDataBuff;
              g_fileDataBuff = NULL;
            }

            g_slave_released = true;
            times2try = 0;
            WiFi.disconnect(false);
            g_webSocketSlaveState = WSClientCleanup;
          }
        }
        break;

      default: /* WSClientCleanup */
        {
          if (times2try)
          {
            if ((unsigned long)(millis() - last) > 1000)
            {
              last = millis();
              times2try--;
            }
          }
          else
          {
#if TRANSMITTER_COMPILE_DEBUG_PRINTS
            if (g_debug_prints_enabled)
            {
              Serial.println("WSc: Closed (1)");
            }
#endif // TRANSMITTER_COMPILE_DEBUG_PRINTS
            WiFi.disconnect();
            wifiMulti.cleanAPlist();
            busy = false;
          }
        }
        break;
    }
  }

  if (failure && g_slaveCloneQuietActive)
  {
    g_cloneDiagnostic.cleanupConfirmed = setAVRCloneQuietMode(false);
    if (!g_cloneDiagnostic.cleanupConfirmed && !g_cloneDiagnosticFailure.length())
    {
      reportCloneDiagnosticFailure("AVR resume after failed connection was not confirmed");
    }
    else
    {
      emitCloneDiagnosticSnapshot();
    }
  }

  return (failure);
}


bool loadActiveEventFile(String updatedFileName)
{
  bool failure = true;
  File tempFile;
  String temp;
  String errorMessage = String("");

  LEDPattern ledPattern = RED_BLUE_TOGETHER;
  int blinkPeriodMillis = 500;
  String msg;
  int times2try = 5;
  bool syncFailed = true;
  bool busy = true;
  unsigned long last = 0;

  if (!g_IamMaster && g_cloneDiagnostic.active)
  {
    reportCloneDiagnosticPhase(CLONE_DIAG_EVENT_PROGRAM);
  }

  g_webSocketSlaveState = WSClientLoadEventFile;

  while (busy)
  {
    g_webSocketLocalClient.loop();
    linkbusLoop();
    yield();

    lights->blinkLEDs(blinkPeriodMillis, ledPattern, true);

    switch (g_webSocketSlaveState)
    {
      case WSClientLoadEventFile:
        {
          bool eventLoaded = false;
          g_slave_received_new_event_file = false;

          if (updatedFileName.length() > 0)
          {
            if (!g_activeEvent)
            {
#if TRANSMITTER_COMPILE_DEBUG_PRINTS
              g_activeEvent = new Event(g_debug_prints_enabled);
#else
              g_activeEvent = new Event(false);
#endif // TRANSMITTER_COMPILE_DEBUG_PRINTS
              g_activeEventIndex = 0;
            }

            if (g_activeEvent)
            {
#if TRANSMITTER_COMPILE_DEBUG_PRINTS
              if (g_debug_prints_enabled)
              {
                Serial.println(String("updatedFileName: " + updatedFileName));
                Serial.println(String("g_activeEvent: " + g_activeEvent->myPath));
              }
#endif // TRANSMITTER_COMPILE_DEBUG_PRINTS
              /*
               * The file may have been replaced by cloning while retaining the
               * same pathname. Always reload it before programming the AVR or
               * reporting the next event; pathname equality does not prove the
               * in-memory Event still matches LittleFS.
               */
              g_LBOutputBuff->put(LB_MESSAGE_ESP_KEEPALIVE);
              if (g_activeEvent->readEventFile(updatedFileName))
              {
#if TRANSMITTER_COMPILE_DEBUG_PRINTS
                if (g_debug_prints_enabled)
                {
                  Serial.println("Error loading event file");
                }
#endif // TRANSMITTER_COMPILE_DEBUG_PRINTS
                errorMessage = "Could not read event file";
                g_webSocketSlaveState = WSClientClose;
              }
              else
              {
                g_selectedEventName = g_activeEvent->getEventName();
                g_slave_received_new_event_file = true;
                eventLoaded = true;
              }
            }
            else
            {
#if TRANSMITTER_COMPILE_DEBUG_PRINTS
              if (g_debug_prints_enabled)
              {
                Serial.println("g_activeEvent is NULL");
              }
#endif // TRANSMITTER_COMPILE_DEBUG_PRINTS
              errorMessage = "Could not create activeEvent";
              g_webSocketSlaveState = WSClientClose;
            }
          }
#if TRANSMITTER_COMPILE_DEBUG_PRINTS
          else if (g_debug_prints_enabled)
          {
            Serial.println("Invalid event file name: " + updatedFileName);
          }
#endif // TRANSMITTER_COMPILE_DEBUG_PRINTS

          if (!updatedFileName.length())
          {
            errorMessage = "Invalid event file name";
            g_webSocketSlaveState = WSClientClose;
          }

          if (eventLoaded && g_activeEvent->isNotDisabledEvent(g_timeOfDayFromTx))
          {
            g_webSocketSlaveState = WSClientProgramATMEGA;
          }
          else if (eventLoaded)
          {
#if TRANSMITTER_COMPILE_DEBUG_PRINTS
            if (g_debug_prints_enabled)
            {
              Serial.println("Event finished in the past");
            }
#endif // TRANSMITTER_COMPILE_DEBUG_PRINTS
            errorMessage = "Event finished in the past";
            g_webSocketSlaveState = WSClientClose;
          }
        }
        break;

      case WSClientProgramATMEGA:
        {
          if (g_slave_received_new_event_file)
          {
            String err;
            sendEventToATMEGA(&err);

            if (err.length())
            {
              errorMessage = String("Failed to send data to AVR: ") + err;
              g_webSocketSlaveState = WSClientClose;
              blinkPeriodMillis = 100;
            }
            else
            {
              blinkPeriodMillis = 500;
              syncFailed = false;
              failure = false;
              times2try = 0;
              g_webSocketSlaveState = WSClientExitSuccess;
            }
          }
          else
          {
            g_webSocketSlaveState = WSClientClose;
            errorMessage = "No event received";
          }
          g_webSocketServer.loop();
        }
        break;

      case WSClientClose:
        {
          if (g_IamMaster)
          {
            busy = false;
          }
          else
          {
            if (syncFailed)
            {
              if (!g_IamMaster && g_cloneDiagnostic.phase != CLONE_DIAG_FAILED)
              {
                reportCloneDiagnosticFailure(
                  errorMessage.length() ? errorMessage : String("event programming state closed without a reason"));
              }
              if (!g_IamMaster)
              {
                errorMessage = cloneDiagnosticFailureText(errorMessage);
              }
              msg = String(SOCK_COMMAND_SLAVE_UPDATE_ERROR);
              if (errorMessage.length())
              {
                msg = msg + "," + errorMessage;
              }
              g_webSocketLocalClient.sendTXT(stringObjToConstCharString(&msg)); /* Send to Master */
              g_webSocketServer.loop();
              times2try = 3;
              syncFailed = false;
            }

            if (times2try)
            {
              if ((unsigned long)(millis() - last) > 1000)
              {
                last = millis();
                times2try--;
              }
            }
            else
            {
              g_webSocketLocalClient.disconnect();

              if (g_fileDataBuff)
              {
                delete g_fileDataBuff;
                g_fileDataBuff = NULL;
              }

              if (tempFile)
              {
                tempFile.close();
              }

              g_slave_released = true;
              times2try = 0;
              WiFi.disconnect(false);
              g_webSocketSlaveState = WSClientCleanup;
            }
          }
        }
        break;

      case WSClientExitSuccess:
        {
          if (failure && !g_IamMaster)
          {
            g_webSocketSlaveState = WSClientCleanup;
          }
          else
          {
            busy = false;
          }
        }
        break;

      default: /* WSClientCleanup */
        {
          if (times2try)
          {
            if ((unsigned long)(millis() - last) > 1000)
            {
              last = millis();
              times2try--;
            }
          }
          else
          {
#if TRANSMITTER_COMPILE_DEBUG_PRINTS
            if (g_debug_prints_enabled)
            {
              Serial.println("WSc: Closed (2)");
            }
#endif // TRANSMITTER_COMPILE_DEBUG_PRINTS
            WiFi.disconnect();
            wifiMulti.cleanAPlist();
            busy = false;
          }
        }
        break;
    }
  }

  return (failure);
}


bool clientUpdateEventFilesLoop()
{
  bool failure = true;
  File tempFile;
  String updatedFileName;
  String temp;
  LEDPattern ledPattern = RED_BLUE_TOGETHER;
  String errorMessage = String("");

  int blinkPeriodMillis = 100;
  String msg;
  int times2try = 5;
  bool syncFailed = true;
  bool busy = true;
  static unsigned long last;
  const unsigned long fleetSessionStartedMillis = millis();

  last = millis();
  g_webSocketSlaveState = WSClientWaitingForFiles;
  if (!g_slaveFleetSoakCapabilitySeen || g_slaveFleetSoakSessionReady)
  {
    msg = String(SOCK_COMMAND_SLAVE) + "," + SLAVE_WAITING_FOR_FILES;
    g_webSocketLocalClient.sendTXT(stringObjToConstCharString(&msg));
  }

  while (busy)
  {
    g_webSocketLocalClient.loop();
    linkbusLoop();
    yield();

    lights->blinkLEDs(blinkPeriodMillis, ledPattern, true);

    switch (g_webSocketSlaveState)
    {
      case WSClientWaitingForFiles:
        {
          if (g_slave_released)
          {
            errorMessage = "master released target while waiting for files";
            g_webSocketSlaveState = WSClientClose;

#if TRANSMITTER_COMPILE_DEBUG_PRINTS
            if (g_debug_prints_enabled)
            {
              Serial.println("WSc: failed connection (21)");
            }
#endif // TRANSMITTER_COMPILE_DEBUG_PRINTS
          }
          else
          {
            if (g_slaveFleetSoakCapabilitySeen && !g_slaveFleetSoakSessionReady)
            {
              /* A Fleet Soak page may need operator input before assigning this target. */
              if ((unsigned long)(millis() - fleetSessionStartedMillis) > 300000UL)
              {
                errorMessage = "Fleet Soak assignment timed out";
                g_webSocketSlaveState = WSClientClose;
              }
            }
            else if (times2try)
            {
              if ((unsigned long)(millis() - last) > 2000)
              {
                msg = String(SOCK_COMMAND_SLAVE) + "," + SLAVE_WAITING_FOR_FILES;
                g_webSocketLocalClient.sendTXT(stringObjToConstCharString(&msg));
                last = millis();
                times2try--;
              }
            }
            else
            {
              blinkPeriodMillis = 100;
              errorMessage = "master did not answer file request";
              g_webSocketSlaveState = WSClientClose;

#if TRANSMITTER_COMPILE_DEBUG_PRINTS
              if (g_debug_prints_enabled)
              {
                Serial.println("WSc: TO waiting for files");
              }
#endif // TRANSMITTER_COMPILE_DEBUG_PRINTS
            }
          }
        }
        break;

      case WSClientReceiveFileUpdate:
        {
          if (g_slave_released)
          {
            errorMessage = "master released target before file transfer started";
            g_webSocketSlaveState = WSClientClose;

#if TRANSMITTER_COMPILE_DEBUG_PRINTS
            if (g_debug_prints_enabled)
            {
              Serial.println("WSc: failed connection (6)");
            }
#endif // TRANSMITTER_COMPILE_DEBUG_PRINTS
          }
          else
          {
            if (g_fileDataBuff == NULL)
            {
              g_fileDataBuff = new CircularStringBuff(2 + EVENT_FILE_DATA_SIZE);
            }

            if (g_fileDataBuff)
            {
              if (!tempFile)
              {
                tempFile = LittleFS.open("/Temp", "w");
              }

              if (tempFile)
              {
                cloneDiagnosticTemporaryFileOpened(&g_cloneDiagnostic);
                g_webSocketSlaveState = WSClientReceiveFileData;
                times2try = 5;

#if TRANSMITTER_COMPILE_DEBUG_PRINTS
                if (g_debug_prints_enabled)
                {
                  Serial.println("Temp file ready...");
                }
#endif // TRANSMITTER_COMPILE_DEBUG_PRINTS
              }
              else
              {
                errorMessage = "could not create temporary event file";
                g_webSocketSlaveState = WSClientClose;
              }
            }
#if TRANSMITTER_COMPILE_DEBUG_PRINTS
            else if (g_debug_prints_enabled)
            {
              Serial.println("File data buff error!");
            }
#endif // TRANSMITTER_COMPILE_DEBUG_PRINTS
          }
        }
        break;

      case WSClientReceiveFileData:
        {
          if (g_slave_released)
          {
            errorMessage = "master released target during file transfer";
            g_webSocketSlaveState = WSClientClose;

#if TRANSMITTER_COMPILE_DEBUG_PRINTS
            if (g_debug_prints_enabled)
            {
              Serial.println("WSc: failed connection (5)");
            }
#endif // TRANSMITTER_COMPILE_DEBUG_PRINTS
          }
          else
          {
            if (tempFile && g_fileDataBuff)
            {
              if (g_fileDataBuff->empty())
              {
                if (times2try)
                {
                  if ((unsigned long)(millis() - last) > 1000)
                  {
                    last = millis();
                    times2try--;
                  }
                }
                else
                {
                  errorMessage = "file data timed out";
                  g_webSocketSlaveState = WSClientClose;
#if TRANSMITTER_COMPILE_DEBUG_PRINTS
                  if (g_debug_prints_enabled)
                  {
                    Serial.println("WSc: Timeout waiting for data");
                  }
#endif // TRANSMITTER_COMPILE_DEBUG_PRINTS
                }
              }
              else
              {
                times2try = 5;
                temp = g_fileDataBuff->get();
                if (temp.equals("EOF"))
                {
#if TRANSMITTER_COMPILE_DEBUG_PRINTS
                  if (g_debug_prints_enabled)
                  {
                    Serial.println("Closing file");
                  }
#endif // TRANSMITTER_COMPILE_DEBUG_PRINTS
                  tempFile.close();
                  cloneDiagnosticTemporaryFileCompleted(&g_cloneDiagnostic);
                  /* File reception is complete. Reclaim the 202-String queue
                   * before validation and rename, where LittleFS needs its
                   * largest contiguous heap block. The next file allocates a
                   * fresh queue in WSClientReceiveFileUpdate. */
                  delete g_fileDataBuff;
                  g_fileDataBuff = NULL;
                  g_webSocketSlaveState = WSClientValidateFile;
                  reportCloneDiagnosticPhase(CLONE_DIAG_FILE_VALIDATE);
                }
                else if (temp.length() > 0)
                {
#if TRANSMITTER_COMPILE_DEBUG_PRINTS
                  if (g_debug_prints_enabled)
                  {
                    Serial.println(temp);
                  }
#endif // TRANSMITTER_COMPILE_DEBUG_PRINTS
                  tempFile.println(temp);
                }
              }

            }
#if TRANSMITTER_COMPILE_DEBUG_PRINTS
            else if (g_debug_prints_enabled)
            {
              Serial.println("File or buff error!");
            }
#endif // TRANSMITTER_COMPILE_DEBUG_PRINTS
          }
        }
        break;


      case WSClientValidateFile:
        {
          if (g_slave_released)
          {
            errorMessage = "master released target during file validation";
            g_webSocketSlaveState = WSClientClose;

#if TRANSMITTER_COMPILE_DEBUG_PRINTS
            if (g_debug_prints_enabled)
            {
              Serial.println("WSc: failed connection (7)");
            }
#endif // TRANSMITTER_COMPILE_DEBUG_PRINTS
          }
          else
          {
            String path = String("/Temp");
            bool validationTimedOut = false;
            updatedFileName = "";
            reportCloneDiagnosticPhase(CLONE_DIAG_FILE_VALIDATE_READ);
            if (Event::validEventFile(
                  path,
                  &updatedFileName,
                  true,
                  CLONE_FILE_VALIDATION_TIMEOUT_MILLIS,
                  &validationTimedOut))
            {
#if TRANSMITTER_COMPILE_DEBUG_PRINTS
              if (g_debug_prints_enabled)
              {
                Serial.println("Temp is valid");
              }
#endif // TRANSMITTER_COMPILE_DEBUG_PRINTS

              if (updatedFileName.length() > 0)
              {
                if (!cloneEventManifestRecord(
                      &g_cloneEventManifest,
                      stringObjToConstCharString(&updatedFileName)))
                {
                  errorMessage = "Invalid event file manifest";
                  g_webSocketSlaveState = WSClientClose;
                }
                else
                {
                  bool fileReady = true;
                  if (g_slaveFleetSoakMode == FLEET_SOAK_MODE_PROVISION)
                  {
                    reportCloneDiagnosticPhase(CLONE_DIAG_FILE_INSTALL_RENAME);
                    fileReady = fleetSoakStageReceivedEvent(updatedFileName, path, &errorMessage);
                  }
                  else
                  {
                    /* LittleFS rename replaces an existing file atomically in
                     * one directory commit. Removing the live file first is
                     * both unnecessary and unsafe: it adds metadata churn and
                     * leaves no valid file if the following rename stalls or
                     * power is lost. */
                    reportCloneDiagnosticPhase(CLONE_DIAG_FILE_INSTALL_RENAME);
                    fileReady = LittleFS.rename(path, updatedFileName);
                  }

#if TRANSMITTER_COMPILE_DEBUG_PRINTS
                  if (g_debug_prints_enabled && fileReady)
                  {
                    Serial.println(String("Renamed /Temp to " + updatedFileName));
                  }
#endif // TRANSMITTER_COMPILE_DEBUG_PRINTS
                  if (fileReady)
                  {
                    g_webSocketSlaveState = WSClientWaitingForFiles;
                    times2try = 5;
                    g_cloneDiagnostic.fileCount = g_cloneEventManifest.count;
                    reportCloneDiagnosticPhase(CLONE_DIAG_FILE_WAIT);
                  }
                  else
                  {
                    errorMessage = "Could not install event file";
                    g_webSocketSlaveState = WSClientClose;
                  }
                }
              }
              else
              {
                errorMessage = "validated event file had no destination name";
                g_webSocketSlaveState = WSClientClose;
              }
            }
            else
            {
              errorMessage = validationTimedOut
                             ? "event file validation exceeded five seconds"
                             : "received event file failed validation";
#if TRANSMITTER_COMPILE_DEBUG_PRINTS
              if (g_debug_prints_enabled)
              {
                Serial.println("Temp file is corrupt");
              }
#endif // TRANSMITTER_COMPILE_DEBUG_PRINTS
              g_webSocketSlaveState = WSClientClose;
            }
          }
        }
        break;

      case WSClientFilesComplete:
        {
          bool filesComplete = true;
          if (g_slaveFleetSoakMode == FLEET_SOAK_MODE_PROVISION)
          {
            /* Fleet finalization has its own exact allowlist and never invokes broad pruning. */
            if (g_cloneEventManifest.count != FLEET_SOAK_EVENT_COUNT)
            {
              errorMessage = "Fleet Soak transfer is incomplete";
              filesComplete = false;
            }
            else
            {
              for (size_t index = 0; index < FLEET_SOAK_EVENT_COUNT; index++)
              {
                if (!cloneEventManifestContains(&g_cloneEventManifest, FLEET_SOAK_EVENT_PATHS[index]))
                {
                  errorMessage = String("Fleet Soak transfer omitted file ") + String(index + 1);
                  filesComplete = false;
                  break;
                }
              }
            }
            if (filesComplete &&
                !fleetSoakFinalizeStagedSuite(g_slaveFleetSoakAssignment, &errorMessage))
            {
              filesComplete = false;
            }
          }
          else if (g_slaveFleetSoakMode == FLEET_SOAK_MODE_CLEANUP)
          {
            int removedCount = 0;
            if (!fleetSoakCleanupReservedEvents(&removedCount, &errorMessage))
            {
              filesComplete = false;
            }
          }
          else if (g_slaveClonePruneTargetEvents &&
                   !reconcileCloneEventFiles(&g_cloneEventManifest))
          {
            errorMessage = "Could not reconcile target event files";
            filesComplete = false;
          }

          if (filesComplete)
          {
            syncFailed = false;
            failure = false;
            busy = false;
          }
          else
          {
            g_webSocketSlaveState = WSClientClose;
          }
        }
        break;

      case WSClientClose:
        {
          if (syncFailed)
          {
            /* A staging file that is still open never received EOF and cannot
             * be validated or installed. Remove only that incomplete file.
             * A complete Temp file is deliberately retained if validation or
             * replacement fails so post-failure forensics remain possible. */
            cleanupIncompleteCloneTempFile(tempFile);
            if (g_cloneDiagnostic.phase != CLONE_DIAG_FAILED)
            {
              reportCloneDiagnosticFailure(
                errorMessage.length() ? errorMessage : String("file transfer state closed without a reason"));
            }
            errorMessage = cloneDiagnosticFailureText(errorMessage);
            msg = String(SOCK_COMMAND_SLAVE_UPDATE_ERROR);
            if (errorMessage.length())
            {
              msg = msg + "," + errorMessage;
            }
            g_webSocketLocalClient.sendTXT(stringObjToConstCharString(&msg)); /* Send to Master */
            g_webSocketServer.loop();
            times2try = 3;
            syncFailed = false;
          }

          if (times2try)
          {
            if ((unsigned long)(millis() - last) > 1000)
            {
              last = millis();
              times2try--;
            }
          }
          else
          {
            g_webSocketLocalClient.disconnect();

            if (g_fileDataBuff)
            {
              delete g_fileDataBuff;
              g_fileDataBuff = NULL;
            }

            if (tempFile)
            {
              tempFile.close();
            }

            g_slave_released = true;
            times2try = 0;
            WiFi.disconnect(false);
            g_webSocketSlaveState = WSClientCleanup;
          }
        }
        break;

      default: /* WSClientCleanup */
        {
          if (times2try)
          {
            if ((unsigned long)(millis() - last) > 1000)
            {
              last = millis();
              times2try--;
            }
          }
          else
          {
#if TRANSMITTER_COMPILE_DEBUG_PRINTS
            if (g_debug_prints_enabled)
            {
              Serial.println("WSc: Closed (3)");
            }
#endif // TRANSMITTER_COMPILE_DEBUG_PRINTS
            WiFi.disconnect();
            wifiMulti.cleanAPlist();
            busy = false;
          }
        }
        break;
    }
  }

  if (g_fileDataBuff)
  {
    delete g_fileDataBuff;
    g_fileDataBuff = NULL;
  }
  if (tempFile)
  {
    tempFile.close();
  }
  if (cloneDiagnosticShouldRemoveIncompleteTemporaryFile(&g_cloneDiagnostic))
  {
    cleanupIncompleteCloneTempFile(tempFile);
    emitCloneDiagnosticSnapshot();
  }

  return (failure);
}
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
