OpenARDF/FlexFox80/Software/AVR128DA48/FlexFox80/defs.h

/*
 *  MIT License
 *
 *  Copyright (c) 2017-2026 Digital Confections LLC
 *
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
 *  THE SOFTWARE IS PROVIDED "AS IS", WITHOUT WARRANTY OF ANY KIND, EXPRESS OR
 *  IMPLIED, INCLUDING BUT NOT LIMITED TO THE WARRANTIES OF MERCHANTABILITY,
 *  FITNESS FOR A PARTICULAR PURPOSE AND NONINFRINGEMENT. IN NO EVENT SHALL THE
 *  AUTHORS OR COPYRIGHT HOLDERS BE LIABLE FOR ANY CLAIM, DAMAGES OR OTHER
 *  LIABILITY, WHETHER IN AN ACTION OF CONTRACT, TORT OR OTHERWISE, ARISING FROM,
 *  OUT OF OR IN CONNECTION WITH THE SOFTWARE OR THE USE OR OTHER DEALINGS IN THE
 *  SOFTWARE.
 */

/*
 * FlexFox80 product-wide constants, types, limits, and protocol definitions.
 */

#ifndef DEFS_H
#define DEFS_H

#ifndef F_CPU
 #define F_CPU 24000000UL /* gets declared in makefile */
#endif

#include <avr/io.h>
#include <avr/interrupt.h>

/******************************************************
 * Set the text that gets displayed to the user */
#define SW_REVISION "0.210"

//#define TRANQUILIZE_WATCHDOG

#define PRODUCT_NAME_SHORT "FlexFox ARDF Tx"
#define PRODUCT_NAME_LONG "FlexFox 80m ARDF Transmitter"

/*******************************************************/

/******************************************************
 * Include only the necessary hardware support */
   #define INCLUDE_SI5351_SUPPORT true // Silicon Labs Programmable Clock
   #define INCLUDE_DS3231_SUPPORT true // Maxim RTC
//   #define INCLUDE_DAC081C085_SUPPORT
//   #define ENABLE_PIN_CHANGE_INTERRUPT_0
//   #define ENABLE_PIN_CHANGE_INTERRUPT_1
//   #define ENABLE_PIN_CHANGE_INTERRUPT_2

// #ifdef INCLUDE_DAC081C085_SUPPORT
//    #define PA_DAC DAC081C_I2C_SLAVE_ADDR_A0
// #endif

//   #define AM_DAC DAC081C_I2C_SLAVE_ADDR_A1
//   #define BIAS_POT MCP4552_I2C_SLAVE_ADDR_A0

	#define DATE_STRING_SUPPORT_ENABLED

/*******************************************************/
/* Error Codes                                                                   */
/*******************************************************/
typedef enum {
	ERROR_CODE_NO_ERROR = 0x00,
	ERROR_CODE_REPORT_NO_ERROR = 0x01,
	ERROR_CODE_EVENT_STATION_ID_ERROR = 0xC7,
	ERROR_CODE_EVENT_PATTERN_CODE_SPEED_NOT_SPECIFIED = 0xC8,
	ERROR_CODE_EVENT_PATTERN_NOT_SPECIFIED = 0xC9,
	ERROR_CODE_EVENT_TIMING_ERROR = 0xCA,
	ERROR_CODE_EVENT_MISSING_TRANSMIT_DURATION = 0xCB,
	ERROR_CODE_EVENT_MISSING_START_TIME = 0xCC,
	ERROR_CODE_EVENT_NOT_CONFIGURED = 0xCD,
    ERROR_CODE_ILLEGAL_COMMAND_RCVD = 0xCE,
    ERROR_CODE_SW_LOGIC_ERROR = 0xCF,
	ERROR_CODE_EVENT_ENDED_IN_PAST = 0xD0,
	ERROR_CODE_ATMEGA_NOT_RESPONDING = 0xD1,
	ERROR_CODE_RF_OSCILLATOR_ERROR = 0xD2,
	ERROR_CODE_POWER_LEVEL_NOT_SUPPORTED = 0xF5,
	ERROR_CODE_NO_ANTENNA_PREVENTS_POWER_SETTING = 0xF6,
	ERROR_CODE_NO_ANTENNA_FOR_BAND = 0xF7,
	ERROR_CODE_WD_TIMEOUT = 0xF8,
	ERROR_CODE_SUPPLY_VOLTAGE_ERROR = 0xF9,
	ERROR_CODE_BUCK_REG_OUTOFSPEC = 0xFA,
	ERROR_CODE_CLKGEN_NONRESPONSIVE = 0xFB,
	ERROR_CODE_RTC_NONRESPONSIVE = 0xFC,
	ERROR_CODE_DAC3_NONRESPONSIVE = 0xFD,
	ERROR_CODE_DAC2_NONRESPONSIVE = 0xFE,
	ERROR_CODE_DAC1_NONRESPONSIVE = 0xFF
	} EC;

/*******************************************************/
/* Status Codes                                                                 */
/*******************************************************/
typedef enum {
	STATUS_CODE_IDLE = 0x00,
	STATUS_CODE_REPORT_IDLE = 0x01,
	STATUS_CODE_NO_ANT_ATTACHED = 0xE9,
//	STATUS_CODE_2M_ANT_ATTACHED = 0xEA,
	STATUS_CODE_80M_ANT_ATTACHED = 0xEB,
	STATUS_CODE_RECEIVING_EVENT_DATA = 0xEC,
	STATUS_CODE_RETURNED_FROM_SLEEP = 0xED,
	STATUS_CODE_BEGINNING_XMSN_THIS_CYCLE = 0xEE,
	STATUS_CODE_SENDING_ID = 0xEF,
	STATUS_CODE_NO_EVENT_TO_RUN = 0xFA,
	STATUS_CODE_EVENT_NEVER_ENDS = 0xFB,
	STATUS_CODE_EVENT_FINISHED = 0xFC,
	STATUS_CODE_EVENT_STARTED_NOW_TRANSMITTING = 0xFD,
	STATUS_CODE_EVENT_STARTED_WAITING_FOR_TIME_SLOT = 0xFE,
	STATUS_CODE_WAITING_FOR_EVENT_START = 0xFF
	} SC;

typedef enum {
	DO_NOT_SLEEP,
	SLEEP_UNTIL_START_TIME,
	SLEEP_AFTER_EVENT,
	SLEEP_UNTIL_NEXT_XMSN,
	SLEEP_USER_OVERRIDE,
	SLEEP_FOREVER
	} SleepType;
	

typedef enum {
	DO_NOT_ENUNCIATE,
	LED_AND_RF,
	LED_ONLY
	} Enunciation_t;
	
#define ENUNCIATION_BLINK_WPM 8

/*******************************************************/

#ifndef uint16_t_defined
#define uint16_t_defined
typedef unsigned int uint16_t;
#endif

#ifndef uint32_t_defined
#define uint32_t_defined
typedef unsigned long uint32_t;
#endif

#ifndef unit8_t_defined
#define unit8_t_defined
typedef unsigned char uint8_t;
#endif

#ifndef null
#define null 0
#endif

#ifndef PI
#define PI 3.141592653589793
#endif

#ifndef MINUTE
#define MINUTE 60UL
#endif

#ifndef HOUR
#define HOUR 3600UL
#endif

#ifndef DAY
#define DAY 86400UL
#endif

#ifndef YEAR
#define YEAR 31536000UL
#endif

#ifndef UINT16_MAX
#define UINT16_MAX 0xFFFFU
#endif

/*******************************************************/
/*******************************************************
* ADC Scale Factors */
/* Battery voltage should be read when +12V supply is enabled and all transmitters are fully powered off */
#define ADC_REF_VOLTAGE_mV 1100UL

#define ADC_MAX_VOLTAGE_MV 4200L /* maximum voltage the ADC can read */
#define BATTERY_VOLTAGE_MAX_MV 4200L /* voltage at which the battery is considered to be fully charged */
#define BATTERY_DROP 320L /* voltage drop between the battery terminals and the ADC input while powering the ESP8266 */
#define BATTERY_DROP_OFFSET (BATTERY_DROP * 1023L)
#define VBAT(x) (BATTERY_DROP + (x * ADC_MAX_VOLTAGE_MV) / 1023L)
#define BATTERY_PERCENTAGE(x, y) ( ( 100L * ((x * ADC_MAX_VOLTAGE_MV + BATTERY_DROP_OFFSET) - (1023L * y)) )  / ((BATTERY_VOLTAGE_MAX_MV - y) * 1023L))

#define SUPPLY_VOLTAGE_MAX_MV 14100L
#define VSUPPLY(x)((x * SUPPLY_VOLTAGE_MAX_MV) / 1023L)

#define PA_VOLTAGE_MAX_MV 14100L
#define VPA(x)((x * PA_VOLTAGE_MAX_MV) / 1023L)

typedef uint16_t BatteryLevel;  /* in milliVolts */

#define VOLTS_5 (((5000L - BATTERY_DROP) * 1023L) / BATTERY_VOLTAGE_MAX_MV)
#define VOLTS_3_19 (((3190L - BATTERY_DROP) * 1023L) / BATTERY_VOLTAGE_MAX_MV)
#define VOLTS_3_0 (((3000L - BATTERY_DROP) * 1023L) / BATTERY_VOLTAGE_MAX_MV)
#define VOLTS_2_4 (((2400L - BATTERY_DROP) * 1023L) / BATTERY_VOLTAGE_MAX_MV)

#define POWER_OFF_VOLT_THRESH_MV VOLTS_2_4 /* 2.4 V = 2400 mV */
#define POWER_ON_VOLT_THRESH_MV VOLTS_3_0  /* 3.0 V = 3000 mV */

#define ANTENNA_DETECT_THRESH 20
#define ANTENNA_DETECT_DEBOUNCE 50

#define NUMBER_OF_ESSENTIAL_EVENT_PARAMETERS 12
#define TEXT_BUFF_SIZE 100

#define UNUSED_VAR 0

/*******************************************************/

#ifndef SELECTIVELY_DISABLE_OPTIMIZATION
	#define SELECTIVELY_DISABLE_OPTIMIZATION
#endif

/******************************************************
 * EEPROM definitions */
#define EEPROM_INITIALIZED_FLAG (uint16_t)0x0108
#define EEPROM_UNINITIALIZED 0x00

#define EEPROM_STATION_ID_DEFAULT "FOXBOX"
#define EEPROM_PATTERN_TEXT_DEFAULT "PARIS|"

#define EEPROM_MASTER_SETTING_DEFAULT false
#define EEPROM_START_TIME_DEFAULT 0
#define EEPROM_FINISH_TIME_DEFAULT 0
#define EEPROM_EVENT_ENABLED_DEFAULT false
#define EEPROM_ID_CODE_SPEED_DEFAULT 20
#define EEPROM_PATTERN_CODE_SPEED_DEFAULT 8
#define EEPROM_FOXORING_PATTERN_CODESPEED_DEFAULT 8
#define EEPROM_ON_AIR_TIME_DEFAULT 60
#define EEPROM_OFF_AIR_TIME_DEFAULT 240
#define EEPROM_INTRA_CYCLE_DELAY_TIME_DEFAULT 0
#define EEPROM_ID_TIME_INTERVAL_DEFAULT 300

#define EEPROM_SI5351_CALIBRATION_DEFAULT 0x00
#define EEPROM_CLK0_OUT_DEFAULT 133000000
#define EEPROM_CLK1_OUT_DEFAULT 70000000
#define EEPROM_CLK2_OUT_DEFAULT 10700000
#define EEPROM_CLK0_ONOFF_DEFAULT OFF
#define EEPROM_CLK1_ONOFF_DEFAULT OFF
#define EEPROM_CLK2_ONOFF_DEFAULT OFF

#define EEPROM_CLOCK_CALIBRATION_DEFAULT 32767
#define EEPROM_BATTERY_THRESHOLD_V (3.800)
#define MAX_UNLOCK_CODE_LENGTH 8
#define EEPROM_DTMF_UNLOCK_CODE_DEFAULT "1357"
#define MIN_UNLOCK_CODE_LENGTH 4
#define MIN_CODE_SPEED_WPM (uint8_t)5
#define MAX_CODE_SPEED_WPM (uint8_t)20
#define MAX_RF_POWER_MW (uint16_t)5000
#define MIN_RF_POWER_MW (uint16_t)0
#define EEPROM_START_EPOCH_DEFAULT 0
#define EEPROM_FINISH_EPOCH_DEFAULT 0
#define EEPROM_UTC_OFFSET_DEFAULT 0

#define EEPROM_FOX_SETTING_NONE_DEFAULT BEACON
#define EEPROM_FOX_SETTING_CLASSIC_DEFAULT FOX_1
#define EEPROM_FOX_SETTING_SPRINT_DEFAULT SPRINT_S1
#define EEPROM_FOX_SETTING_FOXORING_DEFAULT FOXORING_FOX1
#define EEPROM_FOX_SETTING_BLIND_DEFAULT FOX_1
#define EEPROM_EVENT_SETTING_DEFAULT EVENT_FOXORING
#define EEPROM_FOX_PATTERN_DEFAULT "MOE"
#define EEPROM_FOXORING_PATTERN_DEFAULT "ME"
#define EEPROM_FREQUENCY_DEFAULT 3700000
#define EEPROM_FREQUENCY_LOW_DEFAULT 3530000
#define EEPROM_FREQUENCY_MED_DEFAULT 3550000
#define EEPROM_FREQUENCY_HI_DEFAULT 3570000
#define EEPROM_FREQUENCY_BEACON_DEFAULT 3600000
#define TEXT_SET_TIME_TXT (char*)"* > CLK T YYMMDDhhmmss <- Set current time\n"
#define TEXT_SET_START_TXT (char*)"* > CLK S YYMMDDhhmmss <- Set start time\n"
#define TEXT_SET_FINISH_TXT (char*)"* > CLK F YYMMDDhhmmss <- Set finish time\n"
#define TEXT_SET_ID_TXT (char*)"* > ID \"callsign\" <- Set callsign\n"
#define TEXT_ERR_FINISH_BEFORE_START_TXT (char*)"* Err: Finish before start!\n"
#define TEXT_ERR_FINISH_IN_PAST_TXT (char*)"* Err: Finish in past!\n"
#define TEXT_ERR_START_IN_PAST_TXT (char*)"* Err: Start in past!\n"
#define TEXT_ERR_INVALID_TIME_TXT (char*)"* Err: Invalid time!\n"
#define TEXT_ERR_TIME_IN_PAST_TXT (char*)"* Err: Time in past!\n"
#define TEXT_RTC_NOT_RESPONDING_TXT (char*)"* Error: No response from clock hardware\n"
#define TEXT_TX_NOT_RESPONDING_TXT (char*)"* Error: No response from transmit hardware\n"
#define TEXT_WIFI_NOT_DETECTED_TXT (char*)"* Warning: WiFi hardware not detected\n"
#define TEXT_RESET_OCCURRED_TXT (char*)"* Warning: CPU Reset! Need to set clock\n"
#define TEXT_NOT_SLEEPING_TXT (char*)"* NanoFox is not sleeping\n"
#define TEXT_CURRENT_SETTINGS_TXT (char*)"\n*   === NanoFox Settings ===\n"
#define TEXT_EVENT_SETTINGS_TXT (char*)"\n*    === Event Frequency Settings ===\n"
#define MINIMUM_VALID_EPOCH ((time_t)1609459200UL)  /* 1 Jan 2021 00:00:00 */
#define YEAR_2000_EPOCH ((time_t)946684800UL)  /* 1 Jan 2000 00:00:00 */
#define FOREVER_EPOCH ((time_t)4294967295UL) /* 7 Feb 2106 00:00:00 */
#define SECONDS_24H 86400

typedef enum
{
	NULL_CONFIG,
	WAITING_FOR_START,
	CONFIGURATION_ERROR,
	SCHEDULED_EVENT_DID_NOT_START,
	SCHEDULED_EVENT_WILL_NEVER_RUN,
	EVENT_IN_PROGRESS
} ConfigurationState_t;



/******************************************************
 * General definitions for making the code easier to understand */

#ifndef Frequency_Hz
	typedef uint32_t Frequency_Hz;
#endif

#define ON              1
#define OFF             0
#define TOGGLE			2
#define HIGH			1
#define LOW				0
#define UNDETERMINED	3

#define MIN(A,B)    ({ __typeof__(A) __a = (A); __typeof__(B) __b = (B); __a < __b ? __a : __b; })
#define MAX(A,B)    ({ __typeof__(A) __a = (A); __typeof__(B) __b = (B); __a < __b ? __b : __a; })

#define CLAMP(low, x, high) ({\
  __typeof__(x) __x = (x); \
  __typeof__(low) __low = (low);\
  __typeof__(high) __high = (high);\
  __x > __high ? __high : (__x < __low ? __low : __x);\
  })

#define MAX_TIME 4294967295UL
#define MAX_UINT16 (uint16_t)65535
#define MAX_INT16 (int16_t)32767

typedef enum
{
	DOWN = -1,
	NOCHANGE = 0,
	UP = 1,
	SETTOVALUE
} IncrType;

typedef enum
{
	ANT_CONNECTION_UNDETERMINED,
	ANT_DISCONNECTED,
	ANT_CONNECTED
} AntConnType;


typedef enum
{
	BEACON = 0,
	FOX_1,
	FOX_2,
	FOX_3,
	FOX_4,
	FOX_5,
	SPECTATOR,
	SPRINT_S1,
	SPRINT_S2,
	SPRINT_S3,
	SPRINT_S4,
	SPRINT_S5,
	SPRINT_F1,
	SPRINT_F2,
	SPRINT_F3,
	SPRINT_F4,
	SPRINT_F5,
	FOXORING_FOX1,
	FOXORING_FOX2,
	FOXORING_FOX3,
	INVALID_FOX
	#if SUPPORT_TEMP_AND_VOLTAGE_REPORTING
	,
	REPORT_BATTERY
	#endif // SUPPORT_TEMP_AND_VOLTAGE_REPORTING
} Fox_t;

typedef enum
{
	EVENT_NONE,
	EVENT_CLASSIC,
	EVENT_SPRINT,
	EVENT_FOXORING,
	EVENT_BLIND_ARDF,
	EVENT_NUMBER_OF_EVENTS
} Event_t;

/* Periodic TIMER2 interrupt timing definitions */
#define OCR2A_OVF_FREQ_300 0x0C
#define OCR2A_OVF_FREQ_600 0x06
#define OCR2A_OVF_FREQ_720 0x05
#define OCR2A_OVF_BASE_FREQ OCR2A_OVF_FREQ_720
#define TIMER2_57HZ (120/OCR2A_OVF_BASE_FREQ)
#define TIMER2_20HZ (588/OCR2A_OVF_BASE_FREQ)
#define TIMER2_5_8HZ (1200/OCR2A_OVF_BASE_FREQ)
#define TIMER2_0_5HZ (12000/OCR2A_OVF_BASE_FREQ)

/******************************************************
 * UI Hardware-related definitions */

typedef enum
{
	FrequencyFormat,
	HourMinuteSecondFormat,
	HourMinuteSecondDateFormat
} TextFormat;

typedef enum
{
	Minutes_Seconds,                        /* minutes up to 59 */
	Hours_Minutes_Seconds,                  /* hours up to 23 */
	Day_Month_Year_Hours_Minutes_Seconds,   /* Year up to 99 */
	Minutes_Seconds_Elapsed,                /* minutes up to 99 */
	Time_Format_Not_Specified
} TimeFormat;

#define NO_TIME_SPECIFIED (-1)

#define SecondsFromHours(hours) ((hours) * 3600)
#define SecondsFromMinutes(min) ((min) * 60)

typedef enum
{
	PATTERN_TEXT,
	FOXORING_PATTERN_TEXT,
	STATION_ID
} TextIndex;

#define MAX_PATTERN_TEXT_LENGTH (uint8_t)20
#define UNLOCK_CODE_SIZE (uint8_t)8

typedef enum
{
	POWER_UP,
	PUSHBUTTON,
	PROGRAMMATIC,
	NO_ACTION
} EventActionSource_t;

typedef enum
{
	START_NOTHING,
	START_EVENT_NOW_AND_RUN_FOREVER,
	START_TRANSMISSIONS_NOW,
	START_EVENT_WITH_STARTFINISH_TIMES
} EventAction_t;

typedef enum
{
	INIT_NOT_SPECIFIED,
	INIT_EVENT_STARTING_NOW,
	INIT_TRANSMISSIONS_STARTING_NOW,
	INIT_EVENT_IN_PROGRESS_WITH_STARTFINISH_TIMES
} InitializeAction_t;

#endif  /* DEFS_H */
