OpenARDF/FlexFox80/(commit log)

2021-04-07 Baseline KiCad Files
    First KiCad files upload with no changes. Start is from 2-Band ARDF Mini Transmitter project.
    [2-Band ARDF Mini Transmitter BOM - Latest.csv, ARDF 2 Band MiniTx-2020-12-12-17-56-08.sch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]
2021-04-07 Changes for FlexFox80
    Wholesale changes for new project.
    [ARDF 2 Band MiniTx-2020-12-12-17-56-08.sch, ARDF 2 Band MiniTx.sch, Antenna Match.kicad_pcb, FlexFox80 BOM - Latest.csv, FlexFox80-2020-12-12-17-56-08.sch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]
2021-04-07 Schematic
    Schematic changes for FlexFox80
    [file5BC7F38B.sch]
2021-04-08 Schematic Updates
    More schematic changes
    [FlexFox80.sch, file591BC95F.sch, file5BC7F38B.sch]
2021-04-08 Schematic changes
    Schematic
    [FlexFox80.sch, file5BC7F38B.sch]
2021-04-08 Schematic
    Schematic changes
    [file5BC7F38B.sch]
2021-04-27 Updates to Schematic
    Updates to Schematic
    [FlexFox80.sch, file591BC95F.sch, file5BC7F38B.sch, file5BF4C51F.sch]
2021-05-10 Design Updates
    Specifying components
    [FlexFox80.csv, FlexFox80.sch, file591BC95F.sch, file5BC7F38B.sch, file5BF4C51F.sch]
2021-05-10 Design Updates
    Defining parts and footprints
    [FlexFox80.csv, FlexFox80.sch, file591BC95F.sch, file5BC7F38B.sch]
2021-05-11 Design Updates
    Updating schematic parts
    [FlexFox80.sch, file591BC95F.sch, file5BC7F38B.sch]
2021-05-11 Design Updates
    Updated schematics parts descriptions
    [FlexFox80.csv, FlexFox80.sch, file591BC95F.sch, file5BC7F38B.sch, file5BF4C51F.sch]
2021-05-12 PCB Updates
    o Started PCB layout
    [FlexFox80.kicad_pcb, FlexFox80.sch, file591BC95F.sch, file5BC7F38B.sch]
2021-05-12 PCB Updates
    Layout work
    [FlexFox80.kicad_pcb, file591BC95F.sch, file5BC7F38B.sch]
2021-05-13 PCB Layout
    Complete first pass at PCB parts layout. No traces.
    [FlexFox80.csv, FlexFox80.kicad_pcb]
2021-05-13 PCB Updates
    Work in progress - routing
    [FlexFox80.kicad_pcb]
2021-05-14 PCB Development
    Added more traces
    [FlexFox80.kicad_pcb]
2021-05-14 PCB Updates
    First cut at routing complete. DRC passes. Need to add connection to pilot pin.
    [FlexFox80.kicad_pcb]
2021-05-15 PCB Updates
    PCB is now ready for review. Still needs some silkscreen text added.
    [FlexFox80-B_Cu.gbl, FlexFox80-B_Mask.gbs, FlexFox80-B_SilkS.gbo, FlexFox80-Edge_Cuts.gm1, FlexFox80-F_Cu.gtl, FlexFox80-F_Mask.gts, FlexFox80-F_SilkS.gto, FlexFox80-NPTH-drl_map.gbr]
2021-05-16 BOM Updates
    Corrections to part information in schematic and BOMs
    [FlexFox80.csv, FlexFox80.sch, FlexFox80.xlsx, file5BC7F38B.sch]
2021-11-06 Adding Software Files
    Project uses Microchip Studio 7 for software development
    [FlexFox80.kicad_pcb, file5BC7F38B.sch]
2021-11-21 Fix
    Clear TB0 interrupt flag in ISR
2021-11-22 ADC
    ADC
2021-11-22 Development
    Basic ADC and Goertzel funtions added
2021-11-24 Development
    BINIO settings and interrupts
2021-11-25 Development
    Support for swapping USART0/1 functionality
    [driver_isr.cpp]
2021-12-01 Development
    I2C debugging
    EEPROM updates
2021-12-02 Development
    EEPROM updating
    SI5351 I2C error reporting
    [defs.h, eeprommanager.cpp, main.cpp, si5351.cpp, transmitter.cpp]
2021-12-04 Development
    Debug of string printing
2021-12-04 AVR128DA48 Redesign
    Kicad updates for new FlexFox design
    [FlexFox80.csv, FlexFox80.sch, file591BC95F.sch, file5BC7F38B.sch]
2021-12-05 Development
    I2C debugging for DS3231
2022-01-29 Updates for AVR128DA48
    o Board changes
    o Gerbers updated
    [FlexFox80-B_Cu.gbl, FlexFox80-B_Mask.gbs, FlexFox80-B_Paste.gbp, FlexFox80-B_SilkS.gbo, FlexFox80-Edge_Cuts.gm1, FlexFox80-F_Cu.gtl, FlexFox80-F_Mask.gts, FlexFox80-F_Paste.gtp]
2022-02-06 Updates
    o Added fan control
    o Fixed pinout for load switch device
    o Updated gerbers
    o Updated BOM
    [FlexFox80-B_Cu.gbl, FlexFox80-B_Mask.gbs, FlexFox80-B_Paste.gbp, FlexFox80-B_SilkS.gbo, FlexFox80-Edge_Cuts.gm1, FlexFox80-F_Cu.gtl, FlexFox80-F_Mask.gts, FlexFox80-F_Paste.gtp]
2022-02-06 Fan Control Update
    o Corrected an error in the fan control circuit
    o Updated all gerbers and fab files
    [FlexFox80-B_Cu.gbl, FlexFox80-B_Mask.gbs, FlexFox80-B_Paste.gbp, FlexFox80-B_SilkS.gbo, FlexFox80-Edge_Cuts.gm1, FlexFox80-F_Cu.gtl, FlexFox80-F_Mask.gts, FlexFox80-F_Paste.gtp]
2022-02-07 Updated BOM
    Updated BOM files
    [FlexFox80.csv]
2022-02-07 Removed old BOM files
    o Removed some old BOM files from the folder
    [FlexFox80 BOM - Latest.csv]
2022-02-17 Updated PCB
    o Changed U302 footprint to more closely match 48-TQFP (7x7) shown in the AVR128DA48 datasheet
    [FlexFox80-B_Cu.gbl, FlexFox80-B_Mask.gbs, FlexFox80-B_Paste.gbp, FlexFox80-B_SilkS.gbo, FlexFox80-Edge_Cuts.gm1, FlexFox80-F_Cu.gtl, FlexFox80-F_Mask.gts, FlexFox80-F_Paste.gtp]
2022-02-17 Schematic Update
    Updated footprint specified for AVR128DA48
    [file5BC7F38B.sch]
2022-02-17 Gerber Update
    Removed flood fills of U302 ground pins.
    [FlexFox80-B.Cu.gbl, FlexFox80-B.Mask.gbs, FlexFox80-B.SilkS.gbo, FlexFox80-B_Cu.gbl, FlexFox80-B_Mask.gbs, FlexFox80-B_Paste.gbp, FlexFox80-B_SilkS.gbo, FlexFox80-Edge.Cuts.gm1]
2022-02-24 Updates
    o BOM updates
    o Gerber updates
    [FlexFox80-B_Cu.gbl, FlexFox80-B_Mask.gbs, FlexFox80-B_Paste.gbp, FlexFox80-B_SilkS.gbo, FlexFox80-Edge_Cuts.gm1, FlexFox80-F_Cu.gtl, FlexFox80-F_Mask.gts, FlexFox80-F_Paste.gtp]
2022-02-27 Gerber Update
    o Added J201 to optionally bypass U204
    [FlexFox80-B_Cu.gbl, FlexFox80-B_Mask.gbs, FlexFox80-B_Paste.gbp, FlexFox80-B_SilkS.gbo, FlexFox80-Edge_Cuts.gm1, FlexFox80-F_Cu.gtl, FlexFox80-F_Mask.gts, FlexFox80-F_Paste.gtp]
2022-02-27 Gerber Updates
    o Changed parts for C128, L203 and L204 to help with parts shortages
    o Updated footprints
    o Updated schematic
    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
    [FlexFox80-B_Cu.gbl, FlexFox80-B_Mask.gbs, FlexFox80-B_Paste.gbp, FlexFox80-B_SilkS.gbo, FlexFox80-Edge_Cuts.gm1, FlexFox80-F_Cu.gtl, FlexFox80-F_Mask.gts, FlexFox80-F_Paste.gtp]
2022-02-27 Updated Gerbers
    Corrected version date on PCB
    [FlexFox80-B_Cu.gbl, FlexFox80-B_Mask.gbs, FlexFox80-B_Paste.gbp, FlexFox80-B_SilkS.gbo, FlexFox80-Edge_Cuts.gm1, FlexFox80-F_Cu.gtl, FlexFox80-F_Mask.gts, FlexFox80-F_Paste.gtp]
2022-03-02 Gerber Update
    o Corrected dimensions of U203
    [FlexFox80 BOM Populated.xlsx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]
2022-03-04 Footprint Updates
    Tweaks to PCB footprints.
    Removed solder paste from unpopulated components
    [FlexFox80-B_Cu.gbl, FlexFox80-B_Mask.gbs, FlexFox80-B_Paste.gbp, FlexFox80-B_SilkS.gbo, FlexFox80-Edge_Cuts.gm1, FlexFox80-F_Cu.gtl, FlexFox80-F_Mask.gts, FlexFox80-F_Paste.gtp]
2022-03-09 PCB Updates
    Adjusted clearances on PCB. All Gerbers have been updated.
    [FlexFox80-B_Cu.gbl, FlexFox80-B_Mask.gbs, FlexFox80-B_Paste.gbp, FlexFox80-B_SilkS.gbo, FlexFox80-Edge_Cuts.gm1, FlexFox80-F_Cu.gtl, FlexFox80-F_Mask.gts, FlexFox80-F_Paste.gtp]
2022-03-10 PCB Update
    Corrected some pad spacing issues.
    [FlexFox80-B_Cu.gbl, FlexFox80-B_Mask.gbs, FlexFox80-B_Paste.gbp, FlexFox80-B_SilkS.gbo, FlexFox80-Edge_Cuts.gm1, FlexFox80-F_Cu.gtl, FlexFox80-F_Mask.gts, FlexFox80-F_Paste.gtp]
2022-03-10 Update FlexFox80.kicad_pcb-bak
2022-03-10 Updated Silkscreen
    o Incremented PCB version number
    [FlexFox80-B_Cu.gbl, FlexFox80-B_Mask.gbs, FlexFox80-B_Paste.gbp, FlexFox80-B_SilkS.gbo, FlexFox80-Edge_Cuts.gm1, FlexFox80-F_Cu.gtl, FlexFox80-F_Mask.gts, FlexFox80-F_Paste.gtp]
2022-03-31 Latest Gerbers
    Gerbers with minor updates to silkscreen and D101, D301 footprints
    [FlexFox80-B_Cu.gbl, FlexFox80-B_Mask.gbs, FlexFox80-B_Paste.gbp, FlexFox80-B_SilkS.gbo, FlexFox80-Edge_Cuts.gm1, FlexFox80-F_Cu.gtl, FlexFox80-F_Mask.gts, FlexFox80-F_Paste.gtp]
2022-04-22 KiCad V6 Updates
    Mostly schematic updates for KiCad V6
    [FlexFox80-B_Cu.gbl, FlexFox80-B_Mask.gbs, FlexFox80-B_Paste.gbp, FlexFox80-B_SilkS.gbo, FlexFox80-Edge_Cuts.gm1, FlexFox80-F_Cu.gtl, FlexFox80-F_Mask.gts, FlexFox80-F_Paste.gtp]
2022-05-05 Software Updates
    o Numerous changes during board bring-up
    [Digital_Interface.sch, FlexFox80 BOM Populated.xlsx, FlexFox80-2020-12-12-17-56-08.sch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]
2022-05-07 Reorganization
    o Added folders
    o Added Arduino sketch software for Huzzah ESP8266 support
    [Digital_Interface.sch, FlexFox80 BOM Populated.xlsx, FlexFox80-2020-12-12-17-56-08.sch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]
2022-05-08 HUZZAH Fixes
    o Fix for battery voltage reporting
    o Fix for WiFi sync delays caused by legacy commands for band and modulation format
    [ARDF_Transmitter.ino, adc.cpp, adc.h, defs.h, main.cpp, transmitter.cpp]
2022-05-19 KiCad Updates
    o Fixes for problems found during first board build
    [FlexFox80.csv, FlexFox80.kicad_pcb, FlexFox80.kicad_sch, file591BC95F.kicad_sch, file5BC7F38B.kicad_sch, file5BF4C51F.kicad_sch]
2022-05-19 Software Development
    o Numerous bug fixes and function implementation changes.
    [ARDF_Transmitter.ino, Transmitter.h, binio.cpp, binio.h, dac0.cpp, defs.h, driver_init.cpp, esp8266.h]
2022-05-21 Development
    o Implemented tx inhibit when the antenna is removed
2022-05-26 Development
    o Fixed syntax error
    [transmitter.cpp]
2022-05-27 Development
    o Minor fixes
    [main.cpp]
2022-05-31 Development
    Fixes to the radio interface functionality
    [CircularStringBuff.cpp, CircularStringBuff.h, main.cpp]
2022-06-03 Development
    o Bug fixes for Radio operation
    [driver_isr.cpp, i2c.cpp, main.cpp, si5351.cpp, si5351.h, tcb.cpp, transmitter.cpp, transmitter.h]
2022-06-04 Development
    Fix for antenna disconnect behavior
    [Helpers.h, main.cpp, transmitter.cpp]
2022-06-08 Development
    o Sleep fixes
    [main.cpp]
2022-06-08 Development
    o Fixes to web socket shutdown behavior
    [ARDF_Transmitter.ino, Transmitter.h]
2022-06-09 Development
    o tweaks to start-up behavior and hardware failure detection
    [leds.cpp, leds.h, main.cpp]
2022-06-13 Development
    o Minor bug fixes
    o Improvements to radio.html
    o Huzzah version bumped to 2.0
    [ARDF_Transmitter.ino, esp8266.h]
2022-07-03 Development
    o Corrects a bug that prevented transmit power from being set properly if an antenna was not connected at power-up.
    [transmitter.cpp]
2022-07-03 Development
    o Corrects a bug that could interrupt an event stored in EEPROM if no changes to that event get downloaded from the ESP flash memory
    o Bumped software version to 0.3
    [defs.h, main.cpp]
2022-07-16 Development
    o Fixes for bugs related to coming out of sleep
    o FET driver is left on, final FET voltage is turned off if no antenna
    o Version 0.4
    [defs.h, main.cpp, transmitter.cpp]
2023-01-18 Major Update
    o Debug of RTC power up
    o LEDs now indicate hardware failures
    o Green LED now indicates if antenna is attached
    [CircularStringBuff.cpp, adc.cpp, adc.h, binio.cpp, binio.h, clkctrl.h, defs.h, driver_init.cpp]
2023-01-28 Ver 0.92
    Added on-air transmission following the connection of an antenna.
2023-01-28 Updates
    Fixes to events.html
    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
    [FlexFox80.kicad_sch, file591BC95F.kicad_sch, file5BC7F38B.kicad_sch]
2023-01-31 Development
    o Added a confirmation transmission that occurs shortly after the antenna is connected, or at power up.
    o Added debounce improvements for the pushbutton and antenna connection detect
    [binio.cpp, binio.h, defs.h, leds.cpp, main.cpp]
2023-02-01 Updates
    o Allow the antenna-connect xmit enunciation to be avoided by plugging the antenna in before power on.
    [main.cpp]
2023-02-02 Ver 0.97
    Tweaks to courtesy antenna-connect transmission.
    Debug of some memory allocation issues for strings
    [defs.h, main.cpp]
2023-07-10 Ver 0.99
    Corrects a glitch in the transmit pattern after sending the ID.
    [defs.h, main.cpp]
2023-07-10 Ver 0.100
    Corrects a small glitch that could occur in the Morse pattern.
    [defs.h, main.cpp]
2023-07-23 Ver 0.101
    Corrects an error in serial port comms.
    [defs.h, serialbus.cpp]
2023-10-13 Rev 0.103
    o Brought in changes from NanoFox
    o Fixes bug in multi-event logic that could cause some transmitters to be timed incorrectly
    [binio.cpp, defs.h, driver_isr.cpp, eeprommanager.cpp, eeprommanager.h, leds.cpp, leds.h, main.cpp]
2024-05-06 Bug Fixes
    Fixes a problem with storing the call sign
    Minor bug fixes affecting LED behavior
    [defs.h, driver_isr.cpp, eeprommanager.cpp, leds.cpp, leds.h, linkbus.h, main.cpp, serialbus.h]
2026-07-12 Update KiCad project metadata
2026-07-12 Correct EEPROM fox array declaration
    [eeprommanager.cpp]
2026-07-12 Correct circular buffer pop ordering
    [CircularStringBuff.cpp]
2026-07-12 Correct I2C failure count EEPROM writes
    [eeprommanager.cpp]
2026-07-12 Characterize RF power EEPROM width mismatch
2026-07-12 Stabilize EEPROM enum field widths
    [eeprommanager.cpp, eeprommanager.h]
2026-07-12 Add read-only FlexFox WiFi probe
2026-07-12 Track WiFi command bridge hardening
2026-07-12 Correct RF power EEPROM initialization width
    [eeprommanager.cpp]
2026-07-12 Record RF power width verification
2026-07-12 Record RF power target fault injection
2026-07-12 Request current Windows hardening verification
2026-07-12 Make Linkbus message IDs collision-free
    [driver_isr.cpp, linkbus.h, linkbus_rx_bounds.h]
2026-07-12 Guard zero-capacity text buffers
2026-07-12 Record zero-capacity guard target programming
2026-07-12 Complete zero-capacity guard target evidence
2026-07-12 Disable text buffer after allocation failure
    [CircularStringBuff.cpp]
2026-07-12 Use fixed Goertzel sample storage
    [Goertzel.cpp]
2026-07-12 Begin wireless time sync investigation
2026-07-12 Qualify wireless RTC synchronization
2026-07-12 Document Windows ESP8266 Arduino profile search
2026-07-12 Reply to ESP8266 Arduino profile request
2026-07-13 Pin compatible ESP build and qualify clone controls
2026-07-14 Fix ESP role assignment prefix
    [Event.cpp, role_assignment_bounds.h]
2026-07-14 Make full device backups optional
2026-07-17 Fix AVR sleep wake RTC accounting
    [defs.h, rtc_edge_tracker.h, tcb.cpp]
2026-07-17 Fix AVR scheduled start sleep state
    [defs.h, main.cpp]
2026-07-18 Implement wireless AVR bootloading
2026-07-18 Restore AVR event LED contract
2026-07-18 Guard WiFi AVR updates by exact device
2026-07-18 Make wireless event updates persistent and reliable
2026-07-18 Allow slow wireless AVR updates to finish
2026-07-18 Fix event Apply feedback and picker stability
    [defs.h, main.cpp]
2026-07-18 Improve wireless AVR update feedback
2026-07-18 Harden wireless AVR bootloader recovery
2026-07-19 Qualify ESP 2.22 wireless AVR recovery
2026-07-19 Harden interrupted ESP file uploads
2026-07-19 Fix startup temperature validity
    [ARDF_Transmitter.ino, AvrFirmwareUpdatePage.h, adc.cpp, adc.h, defs.h, esp8266.h, main.cpp]
2026-07-19 Add wireless fleet catch-up workflow
2026-07-19 Make wireless fleet upgrades resumable
2026-07-19 Canonicalize ESP device identities
2026-07-20 Revert "Add bounded fleet soak abort"
    This reverts commit e276e9b14729d3108209ca9795c878130921aca3.
    [ARDF_Transmitter.ino, Transmitter.h, esp8266.h, fleet_soak.h]
2026-07-20 Make ADB relay the default Android debug path
2026-07-24 Fix manual radio power initialization
    [ARDF_Transmitter.ino, main.cpp]
2026-07-24 Keep WiFi powered through AVR update handoff
